osu-uwrt/hardware_boards/README.md

# riptide_hardware
Riptide specific EAGLE libs and board files
