osu-uwrt/hardware_boards/pneumaticsBoard/README.md

#Pneumatics Board

This is the board that goes in the pnuematics housing of the competition vehicle _Riptide 2018_.
