osu-uwrt/hardware_boards/batteryBalancer/Blaine/Block Diagram.png

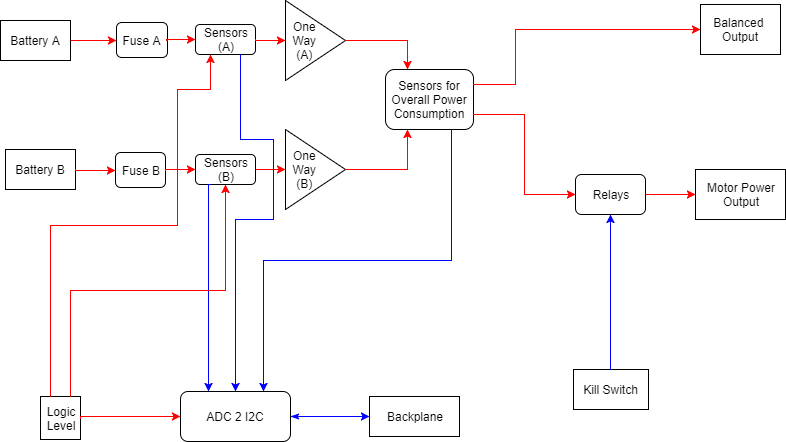
batteryBalancer/Blaine/Block Diagram.png
