osu-uwrt/hardware_boards/coProcessor/co_processor.cmp.bmp

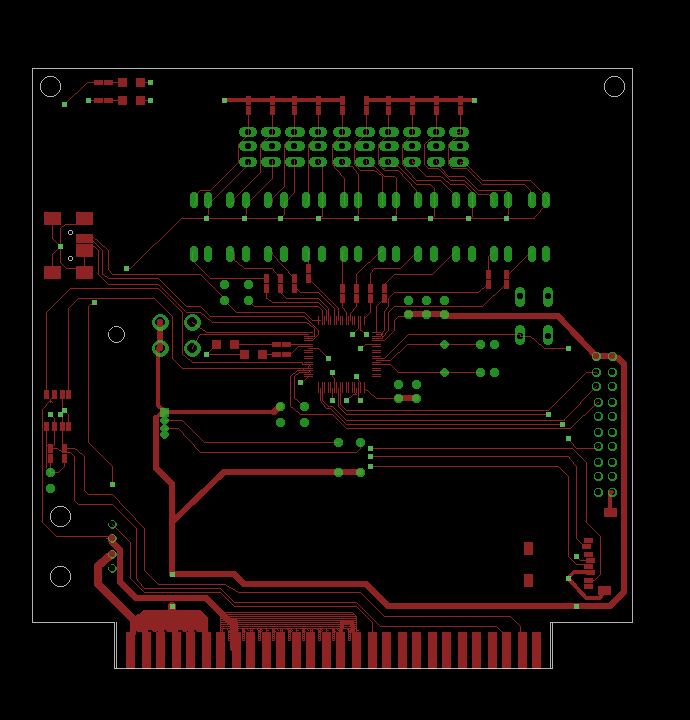
coProcessor/co_processor.cmp.bmp
