osu-uwrt/hardware_boards/coProcessor/co_processor.sol.bmp

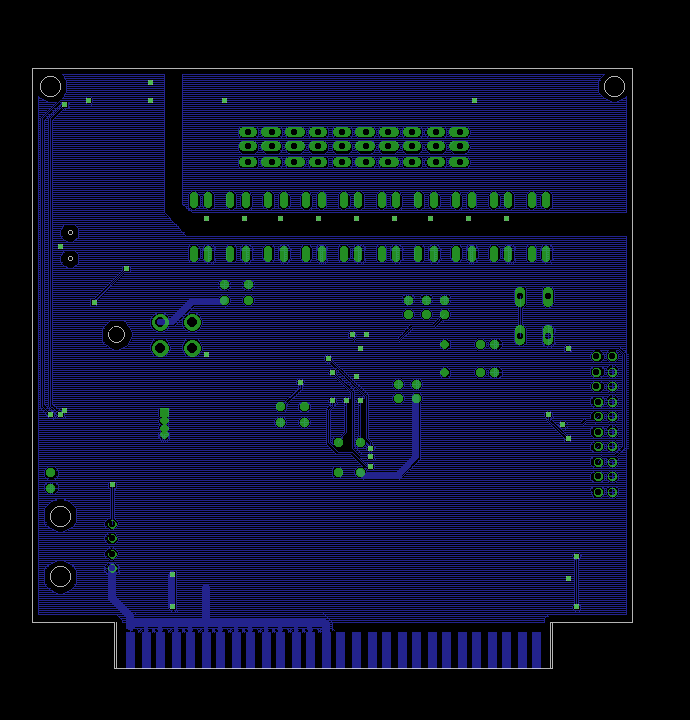
coProcessor/co_processor.sol.bmp
