osu-uwrt/hardware_boards/Status Board/Documentation/Eagle Board.png

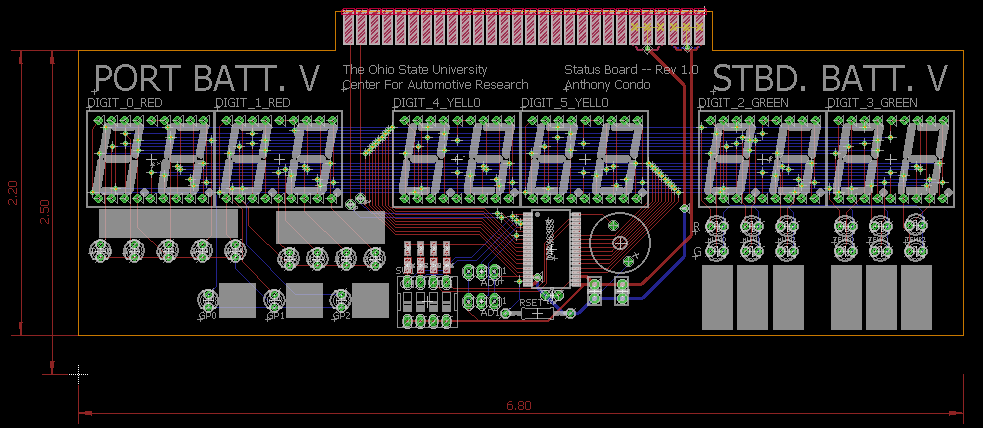
Status Board/Documentation/Eagle Board.png
