osu-uwrt/hardware_boards/Status Board/Documentation/Schematic Pt. 1 MAX6955 and Edge connector.png

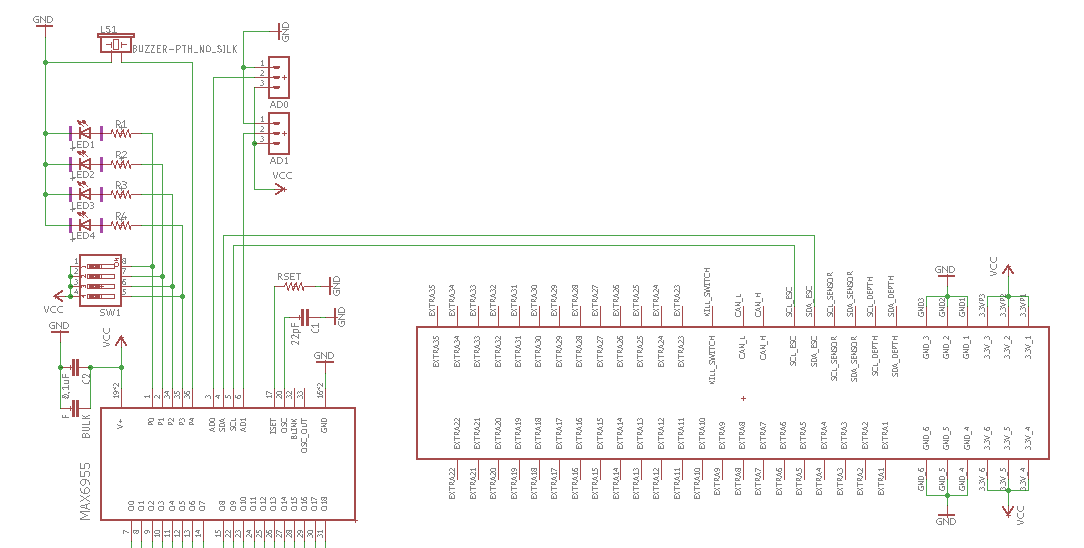
Status Board/Documentation/Schematic Pt. 1 MAX6955 and Edge connector.png
