osu-uwrt/hardware_boards/Status Board/Documentation/Schematic Pt. 2 One 4 Digit 7-Segment display and Discreet LED array.png

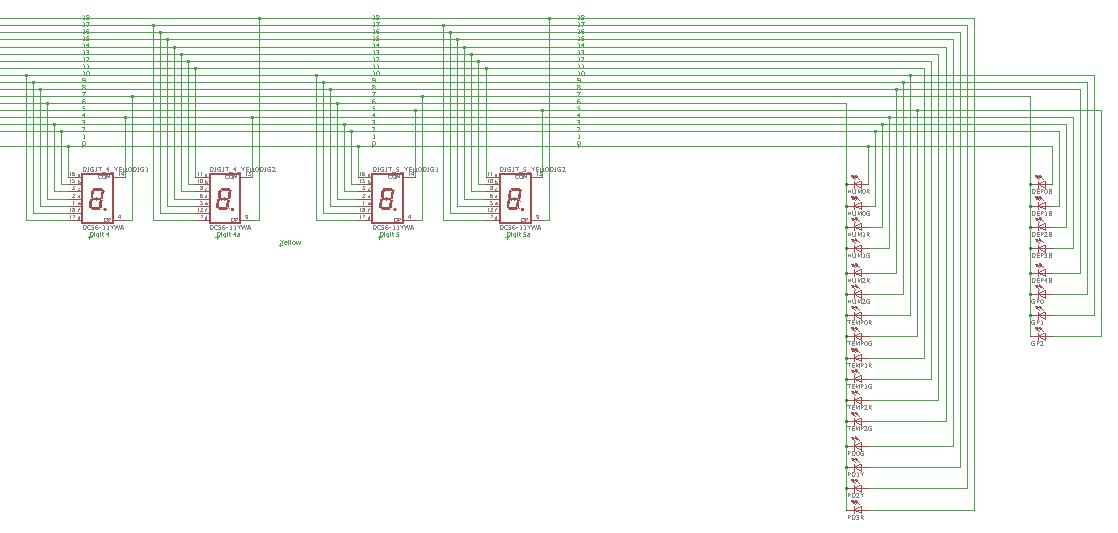
Status Board/Documentation/Schematic Pt. 2 One 4 Digit 7-Segment display and Discreet LED array.png
