osu-uwrt/hardware_boards/Status Board/Documentation/Schematic Pt. 3 Full Diagram.png

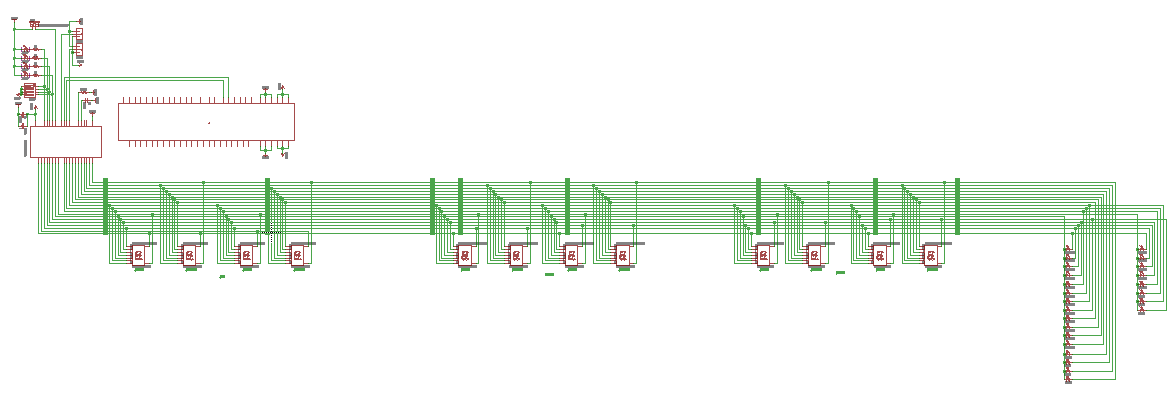
Status Board/Documentation/Schematic Pt. 3 Full Diagram.png
