osu-uwrt/hardware_boards/coProcessor/parts list.xlsx

type of part | mouser part name | manufacturer | number of parts | costs per part | total costs | mouser link | Description
Coprocessor Chip | 511-STM32F405RGT6 | STMicroelectronics | 1 |  | 0
Opto-Coupler | SFH610A-2 | Vishay | 10 |  | 0
USB Mini-B SMD Connector | PRT-00587 | Samtec | 1 |  | 0
DC Power Connector Power Jack | 490-PJ-002AH-SMT-TR | CUI Inc. | 1 |  | 0
3 Pin Header | 619-451-00303 | Parallax | 11 |  | 0
CAN Transceiver | 700-MAX3051EKAT | Maxim Integrated | 1 |  | 0 | https://www.mouser.com/ProductDetail/Maxim-Integrated/MAX3051EKA%2bT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
2 Pin Header | 538-22-27-2021 | Molex | 1 | 0.26 | 0.26 | http://mklec.com/connectors/pcb-header-pins/2-pin-header-pin-socket-and-plug-connector
Nanofit 12CKT Header Horizontal | 538-105312-2112 | Molex | 1 | 2.47 | 2.47 | https://www.mouser.com/ProductDetail/Molex/105314-2112
Nanofit 12CKT Wire Housing | 538-105312-2112 | Molex | 1 |  | 0 | https://www.mouser.com/ProductDetail/Molex/105312-2112
Standard TH LED | 941-C503BRANCZ0C0AA1 | Cree Inc. | 4 |  | 0 | https://www.mouser.com/ProductDetail/941-C503BRANCZ0C0AA1
Linear Voltage Regulator | 511-L78M05CV | STMicroelectronics | 1 |  | 0 | https://www.mouser.com/ProductDetail/511-L78M05CV
Tactile Switch | 653-B3F-1000 | Omron Electronics | 2 |  | 0 | https://www.mouser.com/ProductDetail/653-B3F-1000
SD Connector | 538-503398-0891 | Molex | 1 | 8.95 | 8.95 | https://www.mouser.com/ProductDetail/Molex/503398-0891?qs=sGAEpiMZZMvix4Kz%252byXAvY8l7qWUhbAP
Crystal Oscillator 20 pF | 520-HCA1600-20X | ECS | 1 | 0.6 | 0.6 | https://www.mouser.com/ProductDetail/ECS/ECS-160-20-1X?qs=sGAEpiMZZMsBj6bBr9Q9aXpukMv0ARbgbHEQKPAbIC0%3d
Ceramic Capacitor .1 uF 10% SMT | 80-C0603C104K5REAUTO | KEMET | 5 | 0.19 | 0.95 | https://www.mouser.com/ProductDetail/80-C0603C104K5REAUTO
Ceramic Capacitor 4.7 uF 10% | 963-JMK107BB7475KA-T | Taiyo Yuden | 6 | 0.27 | 1.62 | https://www.mouser.com/ProductDetail/963-JMK107BB7475KA-T
Ceramic Capacitor 2.2 uF 10% | 81-GRM188R61C225KE15 | Murata | 6 | 0.19 | 1.14 | https://www.mouser.com/ProductDetail/81-GRM188R61C225KE15
Ceramic Capacitor 1 nF |  |  |  |  | 0
 |  |  |  |  | 0
 |  |  |  |  | 0
 |  |  |  |  | 0
 |  |  |  |  | 0
 |  |  |  |  | 0
 |  |  |  |  | 0
 |  |  |  |  | 0
 |  |  |  |  | 0
 |  |  |  |  | 0
 |  |  |  |  | 0
 |  |  |  |  | 0
 |  |  |  |  | 0
 |  |  |  |  | 13.23
