osu-uwrt/hardware_boards/eagle_libs/internetLibraries/Eagle Libraries (E14)/LIB_STM32F405RGT6/STM32F405RGT6/3D/STM32F405RGT6.stp

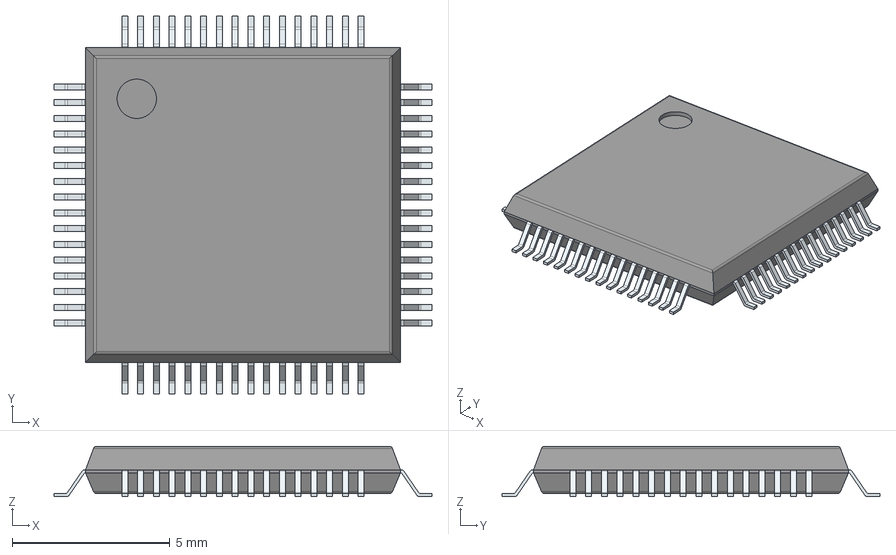
[picture p13: CAD file, 2017-11-12]
eagle_libs/internetLibraries/Eagle Libraries (E14)/LIB_STM32F405RGT6/STM32F405RGT6/3D/STM32F405RGT6.stp
12.0 x 12.0 x 1.60 mm
PinsArrayLR
PinsArrayTB
