osu-uwrt/hardware_boards/(list of files, cad)

Other CAD files:
eagle_libs/internetLibraries/Eagle Libraries (E14)/LIB_STM32F405RGT6/STM32F405RGT6/3D/STM32F405RGT6.stl
eagle_libs/internetLibraries/Eagle Libraries (E14)/STM32F405RGT6/3D/STM32F405RGT6.stl
