osu-uwrt/hardware_boards/debugBoard/README.md

#Electrical System Board Template

This is the template for our boards to fit in the mechanical mount. System revision 1.

##Description
*4inx4in board form factor. 

*4-40 through holes for mounting

*Current Edge connector and pinout configurations

*Initial labels that need to be on all boards

###--------------------------------------------------

Last revision 8/30/17
