osu-uwrt/hardware_boards/coProcessor/co_processor.pdf

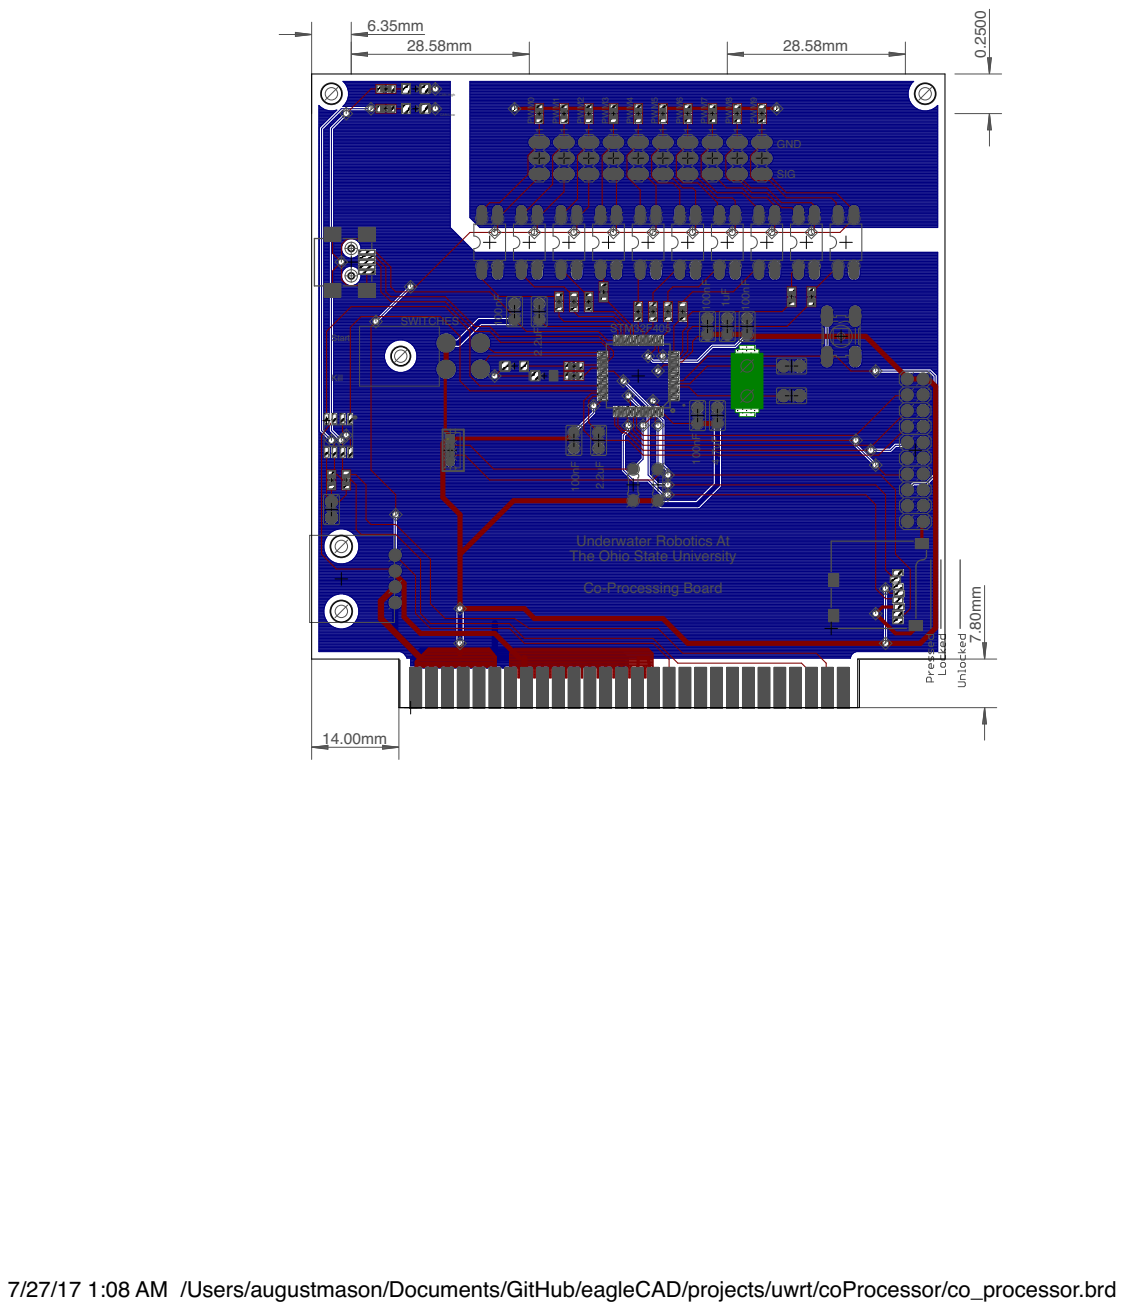
[picture p14: page 1]

Underwater Robotics At
The Ohio State University

7/27/17 1:08 AM /Users/augustmason/Documents/GitHub/eagleCAD/projects/uwrt/coProcessor/co_processor.brd
