osu-uwrt/hardware_boards/acoustics/Nice Acoustics/acoustics.brd

## EAGLE design acoustics/Nice Acoustics/acoustics.brd (2018-09-28)

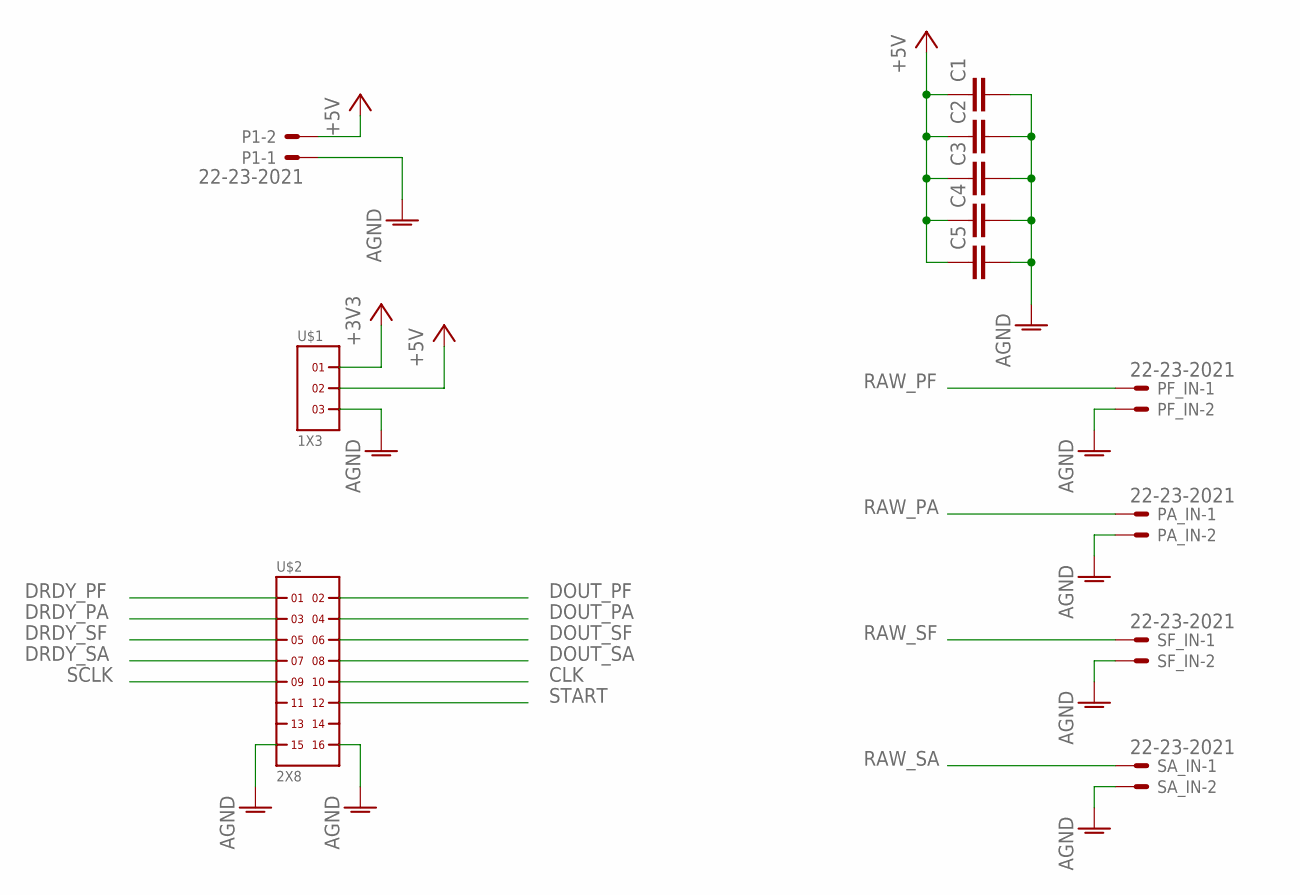
[picture p15: schematic acoustics.sch, sheet 1, Connectors]

Parts:
C1, C2, C3, C4, C5: C2,5-3; C2.5-3
P1: 22-23-2021
PA_IN: 22-23-2021
PF_IN: 22-23-2021
SA_IN: 22-23-2021
SF_IN: 22-23-2021
U$1: 1X3
U$2: 2X8

Connections:
+3V3: U$1.1; also elsewhere on the board
+5V: C1.1, C2.1, C3.1, C4.1, C5.1, P1.2, U$1.2
CLK: U$2.10; also elsewhere on the board
DOUT_PA: U$2.4; also elsewhere on the board
DOUT_PF: U$2.2; also elsewhere on the board
DOUT_SA: U$2.8; also elsewhere on the board
DOUT_SF: U$2.6; also elsewhere on the board
DRDY_PA: U$2.3; also elsewhere on the board
DRDY_PF: U$2.1; also elsewhere on the board
DRDY_SA: U$2.7; also elsewhere on the board
DRDY_SF: U$2.5; also elsewhere on the board
GND: C1.2, C2.2, C3.2, C4.2, C5.2, P1.1, PA_IN.2, PF_IN.2, SA_IN.2, SF_IN.2, U$1.3, U$2.15, U$2.16; also elsewhere on the board
RAW_PA: PA_IN.1; also elsewhere on the board
RAW_PF: PF_IN.1; also elsewhere on the board
RAW_SA: SA_IN.1; also elsewhere on the board
RAW_SF: SF_IN.1; also elsewhere on the board
SCLK: U$2.9; also elsewhere on the board
START: U$2.12; also elsewhere on the board

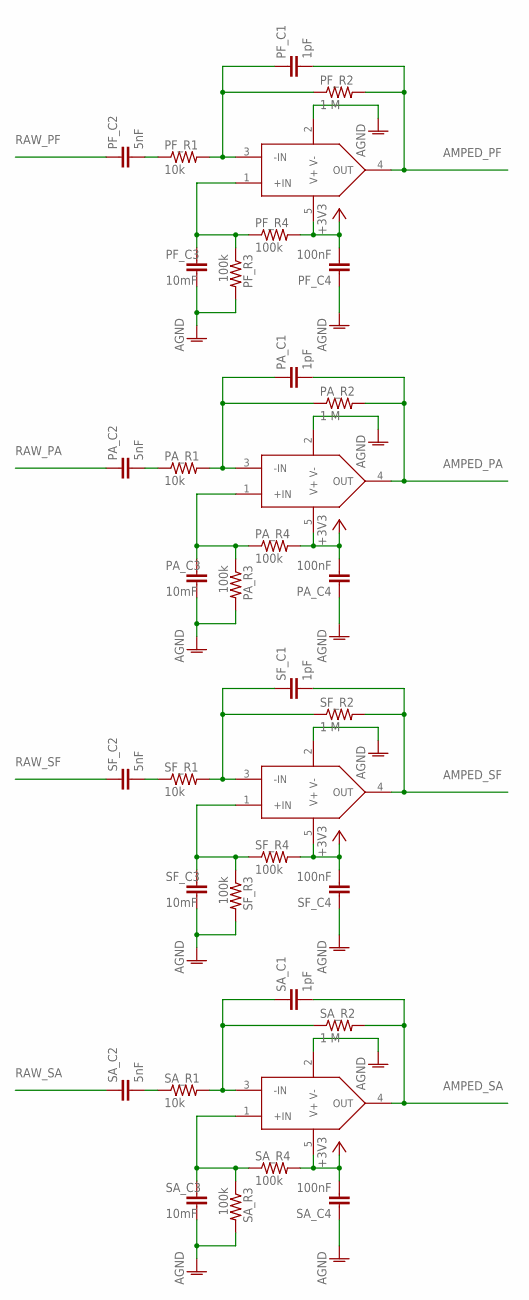
[picture p16: schematic acoustics.sch, sheet 2, Pre-amp]

Parts:
H4_PREAMP4: TLV6741; SC70-5
PA_C1: 1pF; C0603
PA_C2: 5nF; C0603
PA_C3: 10mF; C0603
PA_C4: 100nF; C0603
PA_PREAMP: TLV6741; SC70-5
PA_R1: 10k; R0603
PA_R2: 1 M; R0603
PA_R3, PA_R4: 100k; R0603
PF_C1: 1pF; C0603
PF_C2: 5nF; C0603
PF_C3: 10mF; C0603
PF_C4: 100nF; C0603
PF_PREAMP: TLV6741; SC70-5
PF_R1: 10k; R0603
PF_R2: 1 M; R0603
PF_R3, PF_R4: 100k; R0603
SA_C1: 1pF; C0603
SA_C2: 5nF; C0603
SA_C3: 10mF; C0603
SA_C4: 100nF; C0603
SA_R1: 10k; R0603
SA_R2: 1 M; R0603
SA_R3, SA_R4: 100k; R0603
SF_C1: 1pF; C0603
SF_C2: 5nF; C0603
SF_C3: 10mF; C0603
SF_C4: 100nF; C0603
SF_PREAMP3: TLV6741; SC70-5
SF_R1: 10k; R0603
SF_R2: 1 M; R0603
SF_R3, SF_R4: 100k; R0603

Connections:
+3V3: H4_PREAMP4.5 (V+), PA_C4.2, PA_PREAMP.5 (V+), PA_R4.2, PF_C4.2, PF_PREAMP.5 (V+), PF_R4.2, SA_C4.2, SA_R4.2, SF_C4.2, SF_PREAMP3.5 (V+), SF_R4.2; also elsewhere on the board
AMPED_PA: PA_C1.2, PA_PREAMP.4 (OUT), PA_R2.2; also elsewhere on the board
AMPED_PF: PF_C1.2, PF_PREAMP.4 (OUT), PF_R2.2; also elsewhere on the board
AMPED_SA: H4_PREAMP4.4 (OUT), SA_C1.2, SA_R2.2; also elsewhere on the board
AMPED_SF: SF_C1.2, SF_PREAMP3.4 (OUT), SF_R2.2; also elsewhere on the board
GND: H4_PREAMP4.2 (V-), PA_C3.2, PA_C4.1, PA_PREAMP.2 (V-), PA_R3.2, PF_C3.2, PF_C4.1, PF_PREAMP.2 (V-), PF_R3.2, SA_C3.2, SA_C4.1, SA_R3.2, SF_C3.2, SF_C4.1, SF_PREAMP3.2 (V-), SF_R3.2; also elsewhere on the board
unnamed: PF_C2.2, PF_R1.1
unnamed: PF_C1.1, PF_PREAMP.3 (-IN), PF_R1.2, PF_R2.1
unnamed: PF_C3.1, PF_PREAMP.1 (+IN), PF_R3.1, PF_R4.1
unnamed: PA_C2.2, PA_R1.1
unnamed: PA_C1.1, PA_PREAMP.3 (-IN), PA_R1.2, PA_R2.1
unnamed: PA_C3.1, PA_PREAMP.1 (+IN), PA_R3.1, PA_R4.1
unnamed: SF_C2.2, SF_R1.1
unnamed: SF_C1.1, SF_PREAMP3.3 (-IN), SF_R1.2, SF_R2.1
unnamed: SF_C3.1, SF_PREAMP3.1 (+IN), SF_R3.1, SF_R4.1
unnamed: SA_C2.2, SA_R1.1
unnamed: H4_PREAMP4.3 (-IN), SA_C1.1, SA_R1.2, SA_R2.1
unnamed: H4_PREAMP4.1 (+IN), SA_C3.1, SA_R3.1, SA_R4.1
RAW_PA: PA_C2.1; also elsewhere on the board
RAW_PF: PF_C2.1; also elsewhere on the board
RAW_SA: SA_C2.1; also elsewhere on the board
RAW_SF: SF_C2.1; also elsewhere on the board

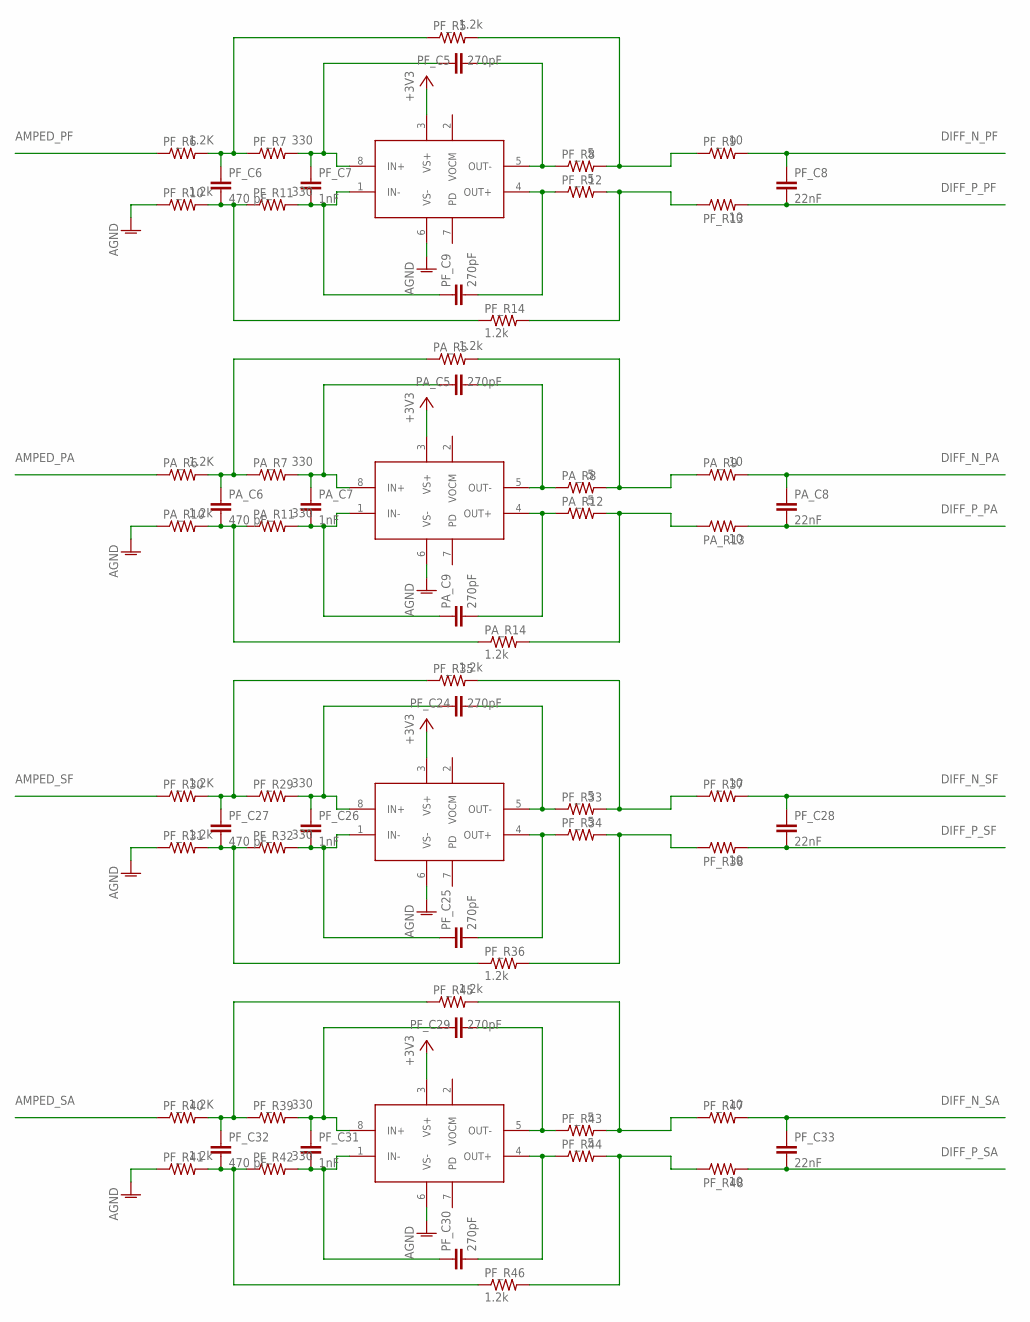
[picture p17: schematic acoustics.sch, sheet 3, Differential amplifier]

Parts:
PA_C5, PA_C9: 270pF; C0603
PA_C6: 470 pF; C0603
PA_C7: 1nF; C0603
PA_C8: 22nF; C0603
PA_DA: THS4551; VSSOP-8
PA_R5, PA_R10, PA_R14: 1.2k; R0603
PA_R6: 1.2K; R0603
PA_R7, PA_R11: 330; R0603
PA_R8, PA_R12: 5; R0603
PA_R9, PA_R13: 10; R0603
PF_C5, PF_C9, PF_C24, PF_C25, PF_C29, PF_C30: 270pF; C0603
PF_C6, PF_C27, PF_C32: 470 pF; C0603
PF_C7, PF_C26, PF_C31: 1nF; C0603
PF_C8, PF_C28, PF_C33: 22nF; C0603
PF_DA, PF_DA2, PF_DA3: THS4551; VSSOP-8
PF_R5, PF_R10, PF_R14, PF_R31, PF_R35, PF_R36, PF_R41, PF_R45, PF_R46: 1.2k; R0603
PF_R6, PF_R30, PF_R40: 1.2K; R0603
PF_R7, PF_R11, PF_R29, PF_R32, PF_R39, PF_R42: 330; R0603
PF_R8, PF_R12, PF_R33, PF_R34, PF_R43, PF_R44: 5; R0603
PF_R9, PF_R13, PF_R37, PF_R38, PF_R47, PF_R48: 10; R0603

Connections:
+3V3: PA_DA.3 (VS+), PF_DA.3 (VS+), PF_DA2.3 (VS+), PF_DA3.3 (VS+); also elsewhere on the board
AMPED_PA: PA_R6.1; also elsewhere on the board
AMPED_PF: PF_R6.1; also elsewhere on the board
AMPED_SA: PF_R40.1; also elsewhere on the board
AMPED_SF: PF_R30.1; also elsewhere on the board
DIFF_N_PA: PA_C8.1, PA_R9.2; also elsewhere on the board
DIFF_N_PF: PF_C8.1, PF_R9.2; also elsewhere on the board
DIFF_N_SA: PF_C33.1, PF_R47.2; also elsewhere on the board
DIFF_N_SF: PF_C28.1, PF_R37.2; also elsewhere on the board
DIFF_P_PA: PA_C8.2, PA_R13.2; also elsewhere on the board
DIFF_P_PF: PF_C8.2, PF_R13.2; also elsewhere on the board
DIFF_P_SA: PF_C33.2, PF_R48.2; also elsewhere on the board
DIFF_P_SF: PF_C28.2, PF_R38.2; also elsewhere on the board
GND: PA_DA.6 (VS-), PA_R10.1, PF_DA.6 (VS-), PF_DA2.6 (VS-), PF_DA3.6 (VS-), PF_R10.1, PF_R31.1, PF_R41.1; also elsewhere on the board
unnamed: PA_C5.2, PA_DA.5 (OUT-), PA_R8.1
unnamed: PA_C5.1, PA_C7.1, PA_DA.8 (IN+), PA_R7.2
unnamed: PA_C7.2, PA_C9.1, PA_DA.1 (IN-), PA_R11.2
unnamed: PA_C6.1, PA_R5.1, PA_R6.2, PA_R7.1
unnamed: PA_C6.2, PA_R10.2, PA_R11.1, PA_R14.1
unnamed: PA_C9.2, PA_DA.4 (OUT+), PA_R12.1
unnamed: PA_R5.2, PA_R8.2, PA_R9.1
unnamed: PA_R12.2, PA_R13.1, PA_R14.2
unnamed: PF_C24.2, PF_DA2.5 (OUT-), PF_R33.1
unnamed: PF_C24.1, PF_C26.1, PF_DA2.8 (IN+), PF_R29.2
unnamed: PF_C25.1, PF_C26.2, PF_DA2.1 (IN-), PF_R32.2
unnamed: PF_C27.1, PF_R29.1, PF_R30.2, PF_R35.1
unnamed: PF_C27.2, PF_R31.2, PF_R32.1, PF_R36.1
unnamed: PF_C25.2, PF_DA2.4 (OUT+), PF_R34.1
unnamed: PF_R33.2, PF_R35.2, PF_R37.1
unnamed: PF_R34.2, PF_R36.2, PF_R38.1
unnamed: PF_C29.2, PF_DA3.5 (OUT-), PF_R43.1
unnamed: PF_C29.1, PF_C31.1, PF_DA3.8 (IN+), PF_R39.2
unnamed: PF_C30.1, PF_C31.2, PF_DA3.1 (IN-), PF_R42.2
unnamed: PF_C32.1, PF_R39.1, PF_R40.2, PF_R45.1
unnamed: PF_C32.2, PF_R41.2, PF_R42.1, PF_R46.1
unnamed: PF_C30.2, PF_DA3.4 (OUT+), PF_R44.1
unnamed: PF_R43.2, PF_R45.2, PF_R47.1
unnamed: PF_R44.2, PF_R46.2, PF_R48.1
unnamed: PF_R12.2, PF_R13.1, PF_R14.2
unnamed: PF_C5.2, PF_DA.5 (OUT-), PF_R8.1
unnamed: PF_C5.1, PF_C7.1, PF_DA.8 (IN+), PF_R7.2
unnamed: PF_C7.2, PF_C9.1, PF_DA.1 (IN-), PF_R11.2
unnamed: PF_C6.1, PF_R5.1, PF_R6.2, PF_R7.1
unnamed: PF_C6.2, PF_R10.2, PF_R11.1, PF_R14.1
unnamed: PF_C9.2, PF_DA.4 (OUT+), PF_R12.1
unnamed: PF_R5.2, PF_R8.2, PF_R9.1

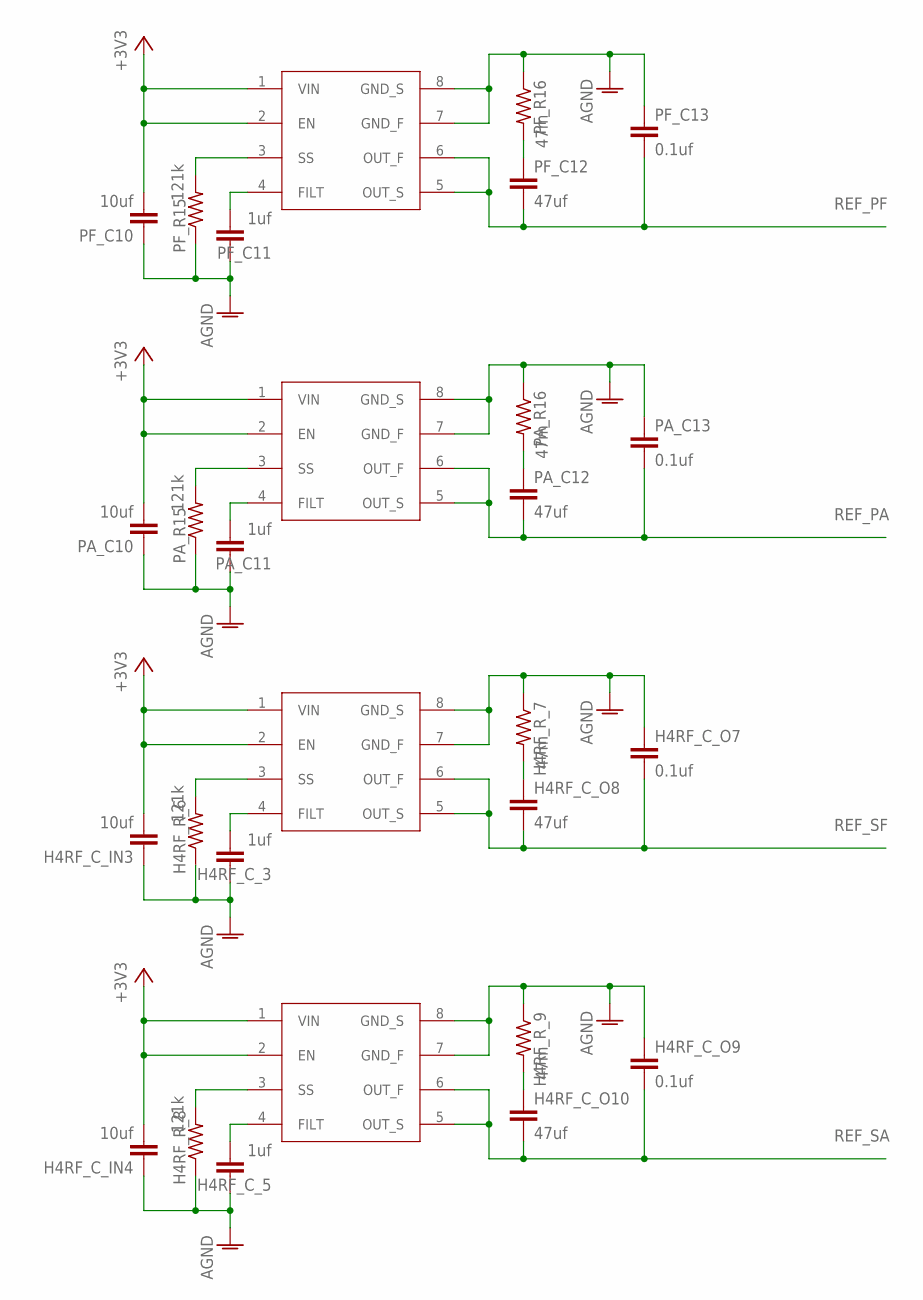
[picture p18: schematic acoustics.sch, sheet 4, Voltage Reference]

Parts:
H4RF_C_3, H4RF_C_5: 1uf; C0603
H4RF_C_IN3, H4RF_C_IN4: 10uf; C0603
H4RF_C_O7, H4RF_C_O9: 0.1uf; C0603
H4RF_C_O8, H4RF_C_O10: 47uf; C0603
H4RF_R_6, H4RF_R_8: 121k; R0603
H4RF_R_7, H4RF_R_9: 47m; R0603
H4_REFGEN3, H4_REFGEN4: REF6025
PA_C10: 10uf; C0603
PA_C11: 1uf; C0603
PA_C12: 47uf; C0603
PA_C13: 0.1uf; C0603
PA_R15: 121k; R0603
PA_R16: 47m; R0603
PA_REFGEN: REF6025
PF_C10: 10uf; C0603
PF_C11: 1uf; C0603
PF_C12: 47uf; C0603
PF_C13: 0.1uf; C0603
PF_R15: 121k; R0603
PF_R16: 47m; R0603
PF_REFGEN: REF6025

Connections:
+3V3: H4RF_C_IN3.2, H4RF_C_IN4.2, H4_REFGEN3.1 (VIN), H4_REFGEN3.2 (EN), H4_REFGEN4.1 (VIN), H4_REFGEN4.2 (EN), PA_C10.2, PA_REFGEN.1 (VIN), PA_REFGEN.2 (EN), PF_C10.2, PF_REFGEN.1 (VIN), PF_REFGEN.2 (EN); also elsewhere on the board
GND: H4RF_C_3.1, H4RF_C_5.1, H4RF_C_IN3.1, H4RF_C_IN4.1, H4RF_C_O7.1, H4RF_C_O9.1, H4RF_R_6.1, H4RF_R_7.1, H4RF_R_8.1, H4RF_R_9.1, H4_REFGEN3.7 (GND_F), H4_REFGEN3.8 (GND_S), H4_REFGEN4.7 (GND_F), H4_REFGEN4.8 (GND_S), PA_C10.1, PA_C11.1, PA_C13.1, PA_R15.1, PA_R16.1, PA_REFGEN.7 (GND_F), PA_REFGEN.8 (GND_S), PF_C10.1, PF_C11.1, PF_C13.1, PF_R15.1, PF_R16.1, PF_REFGEN.7 (GND_F), PF_REFGEN.8 (GND_S); also elsewhere on the board
unnamed: PF_C11.2, PF_REFGEN.4 (FILT)
unnamed: PF_R15.2, PF_REFGEN.3 (SS)
unnamed: PF_C12.1, PF_R16.2
unnamed: PA_C11.2, PA_REFGEN.4 (FILT)
unnamed: PA_R15.2, PA_REFGEN.3 (SS)
unnamed: PA_C12.1, PA_R16.2
unnamed: H4RF_C_3.2, H4_REFGEN3.4 (FILT)
unnamed: H4RF_R_6.2, H4_REFGEN3.3 (SS)
unnamed: H4RF_C_O8.1, H4RF_R_7.2
unnamed: H4RF_C_5.2, H4_REFGEN4.4 (FILT)
unnamed: H4RF_R_8.2, H4_REFGEN4.3 (SS)
unnamed: H4RF_C_O10.1, H4RF_R_9.2
REF_PA: PA_C12.2, PA_C13.2, PA_REFGEN.5 (OUT_S), PA_REFGEN.6 (OUT_F); also elsewhere on the board
REF_PF: PF_C12.2, PF_C13.2, PF_REFGEN.5 (OUT_S), PF_REFGEN.6 (OUT_F); also elsewhere on the board
REF_SA: H4RF_C_O9.2, H4RF_C_O10.2, H4_REFGEN4.5 (OUT_S), H4_REFGEN4.6 (OUT_F); also elsewhere on the board
REF_SF: H4RF_C_O7.2, H4RF_C_O8.2, H4_REFGEN3.5 (OUT_S), H4_REFGEN3.6 (OUT_F); also elsewhere on the board

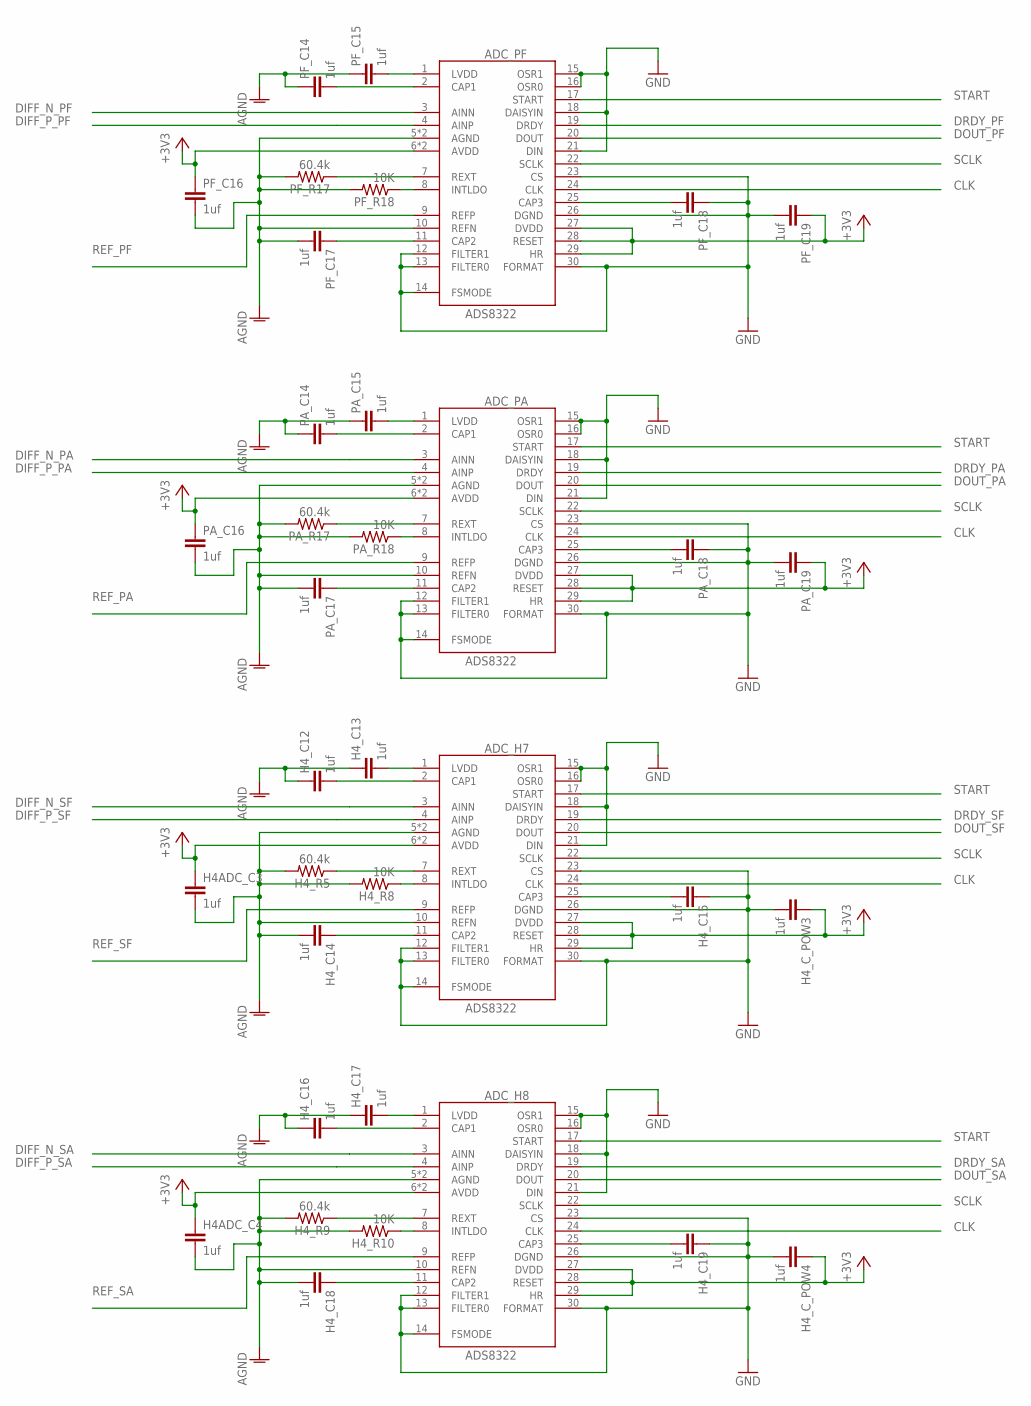
[picture p19: schematic acoustics.sch, sheet 5, ADCs]

Parts:
ADC_H7, ADC_H8: ADS8322; TQFP-32
ADC_PA: ADS8322; TQFP-32
ADC_PF: ADS8322; TQFP-32
H4ADC_C3, H4ADC_C4: 1uf; C0603K
H4_C12, H4_C13, H4_C14, H4_C15, H4_C16, H4_C17, H4_C18, H4_C19, H4_C_POW3, H4_C_POW4: 1uf; C0603
H4_R5, H4_R9: 60.4k; R0603
H4_R8, H4_R10: 10K; R0603
PA_C14, PA_C15, PA_C17, PA_C18, PA_C19: 1uf; C0603
PA_C16: 1uf; C0603K
PA_R17: 60.4k; R0603
PA_R18: 10K; R0603
PF_C14, PF_C15, PF_C17, PF_C18, PF_C19: 1uf; C0603
PF_C16: 1uf; C0603K
PF_R17: 60.4k; R0603
PF_R18: 10K; R0603

Connections:
+3V3: ADC_H7.6 (AVDD), ADC_H7.27 (DVDD), ADC_H7.28 (RESET), ADC_H7.29 (HR), ADC_H7.32 (AVDD), ADC_H8.6 (AVDD), ADC_H8.27 (DVDD), ADC_H8.28 (RESET), ADC_H8.29 (HR), ADC_H8.32 (AVDD), ADC_PA.6 (AVDD), ADC_PA.27 (DVDD), ADC_PA.28 (RESET), ADC_PA.29 (HR), ADC_PA.32 (AVDD), ADC_PF.6 (AVDD), ADC_PF.27 (DVDD), ADC_PF.28 (RESET), ADC_PF.29 (HR), ADC_PF.32 (AVDD), H4ADC_C3.1, H4ADC_C4.1, H4_C_POW3.1, H4_C_POW4.1, PA_C16.1, PA_C19.1, PF_C16.1, PF_C19.1; also elsewhere on the board
CLK: ADC_H7.24 (CLK), ADC_H8.24 (CLK), ADC_PA.24 (CLK), ADC_PF.24 (CLK); also elsewhere on the board
DIFF_N_PA: ADC_PA.3 (AINN); also elsewhere on the board
DIFF_N_PF: ADC_PF.3 (AINN); also elsewhere on the board
DIFF_N_SA: ADC_H8.3 (AINN); also elsewhere on the board
DIFF_N_SF: ADC_H7.3 (AINN); also elsewhere on the board
DIFF_P_PA: ADC_PA.4 (AINP); also elsewhere on the board
DIFF_P_PF: ADC_PF.4 (AINP); also elsewhere on the board
DIFF_P_SA: ADC_H8.4 (AINP); also elsewhere on the board
DIFF_P_SF: ADC_H7.4 (AINP); also elsewhere on the board
DOUT_PA: ADC_PA.20 (DOUT); also elsewhere on the board
DOUT_PF: ADC_PF.20 (DOUT); also elsewhere on the board
DOUT_SA: ADC_H8.20 (DOUT); also elsewhere on the board
DOUT_SF: ADC_H7.20 (DOUT); also elsewhere on the board
DRDY_PA: ADC_PA.19 (DRDY); also elsewhere on the board
DRDY_PF: ADC_PF.19 (DRDY); also elsewhere on the board
DRDY_SA: ADC_H8.19 (DRDY); also elsewhere on the board
DRDY_SF: ADC_H7.19 (DRDY); also elsewhere on the board
GND: ADC_H7.5 (AGND), ADC_H7.10 (REFN), ADC_H7.12 (FILTER1), ADC_H7.13 (FILTER0), ADC_H7.14 (FSMODE), ADC_H7.15 (OSR1), ADC_H7.16 (OSR0), ADC_H7.18 (DAISYIN), ADC_H7.21 (DIN), ADC_H7.23 (CS), ADC_H7.26 (DGND), ADC_H7.30 (FORMAT), ADC_H7.31 (AGND), ADC_H8.5 (AGND), ADC_H8.10 (REFN), ADC_H8.12 (FILTER1), ADC_H8.13 (FILTER0), ADC_H8.14 (FSMODE), ADC_H8.15 (OSR1), ADC_H8.16 (OSR0), ADC_H8.18 (DAISYIN), ADC_H8.21 (DIN), ADC_H8.23 (CS), ADC_H8.26 (DGND), ADC_H8.30 (FORMAT), ADC_H8.31 (AGND), ADC_PA.5 (AGND), ADC_PA.10 (REFN), ADC_PA.12 (FILTER1), ADC_PA.13 (FILTER0), ADC_PA.14 (FSMODE), ADC_PA.15 (OSR1), ADC_PA.16 (OSR0), ADC_PA.18 (DAISYIN), ADC_PA.21 (DIN), ADC_PA.23 (CS), ADC_PA.26 (DGND), ADC_PA.30 (FORMAT), ADC_PA.31 (AGND), ADC_PF.5 (AGND), ADC_PF.10 (REFN), ADC_PF.12 (FILTER1), ADC_PF.13 (FILTER0), ADC_PF.14 (FSMODE), ADC_PF.15 (OSR1), ADC_PF.16 (OSR0), ADC_PF.18 (DAISYIN), ADC_PF.21 (DIN), ADC_PF.23 (CS), ADC_PF.26 (DGND), ADC_PF.30 (FORMAT), ADC_PF.31 (AGND), H4ADC_C3.2, H4ADC_C4.2, H4_C12.1, H4_C13.1, H4_C14.2, H4_C15.1, H4_C16.1, H4_C17.1, H4_C18.2, H4_C19.1, H4_C_POW3.2, H4_C_POW4.2, H4_R5.2, H4_R8.2, H4_R9.2, H4_R10.2, PA_C14.1, PA_C15.1, PA_C16.2, PA_C17.2, PA_C18.1, PA_C19.2, PA_R17.2, PA_R18.2, PF_C14.1, PF_C15.1, PF_C16.2, PF_C17.2, PF_C18.1, PF_C19.2, PF_R17.2, PF_R18.2; also elsewhere on the board
unnamed: ADC_PF.2 (CAP1), PF_C14.2
unnamed: ADC_PA.1 (LVDD), PA_C15.2
unnamed: ADC_PA.8 (INTLDO), PA_R18.1
unnamed: ADC_PA.7 (REXT), PA_R17.1
unnamed: ADC_PA.11 (CAP2), PA_C17.1
unnamed: ADC_PA.25 (CAP3), PA_C18.2
unnamed: ADC_PF.1 (LVDD), PF_C15.2
unnamed: ADC_PA.2 (CAP1), PA_C14.2
unnamed: ADC_PF.8 (INTLDO), PF_R18.1
unnamed: ADC_PF.7 (REXT), PF_R17.1
unnamed: ADC_PF.11 (CAP2), PF_C17.1
unnamed: ADC_PF.25 (CAP3), PF_C18.2
unnamed: ADC_H7.1 (LVDD), H4_C13.2
unnamed: ADC_H7.8 (INTLDO), H4_R8.1
unnamed: ADC_H7.7 (REXT), H4_R5.1
unnamed: ADC_H7.11 (CAP2), H4_C14.1
unnamed: ADC_H7.25 (CAP3), H4_C15.2
unnamed: ADC_H7.2 (CAP1), H4_C12.2
unnamed: ADC_H8.1 (LVDD), H4_C17.2
unnamed: ADC_H8.8 (INTLDO), H4_R10.1
unnamed: ADC_H8.7 (REXT), H4_R9.1
unnamed: ADC_H8.11 (CAP2), H4_C18.1
unnamed: ADC_H8.25 (CAP3), H4_C19.2
unnamed: ADC_H8.2 (CAP1), H4_C16.2
REF_PA: ADC_PA.9 (REFP); also elsewhere on the board
REF_PF: ADC_PF.9 (REFP); also elsewhere on the board
REF_SA: ADC_H8.9 (REFP); also elsewhere on the board
REF_SF: ADC_H7.9 (REFP); also elsewhere on the board
SCLK: ADC_H7.22 (SCLK), ADC_H8.22 (SCLK), ADC_PA.22 (SCLK), ADC_PF.22 (SCLK); also elsewhere on the board
START: ADC_H7.17 (START), ADC_H8.17 (START), ADC_PA.17 (START), ADC_PF.17 (START); also elsewhere on the board

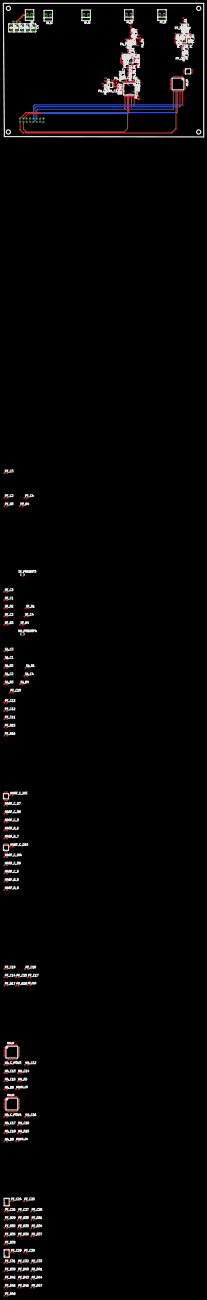
[picture p20: board acoustics.brd from above]

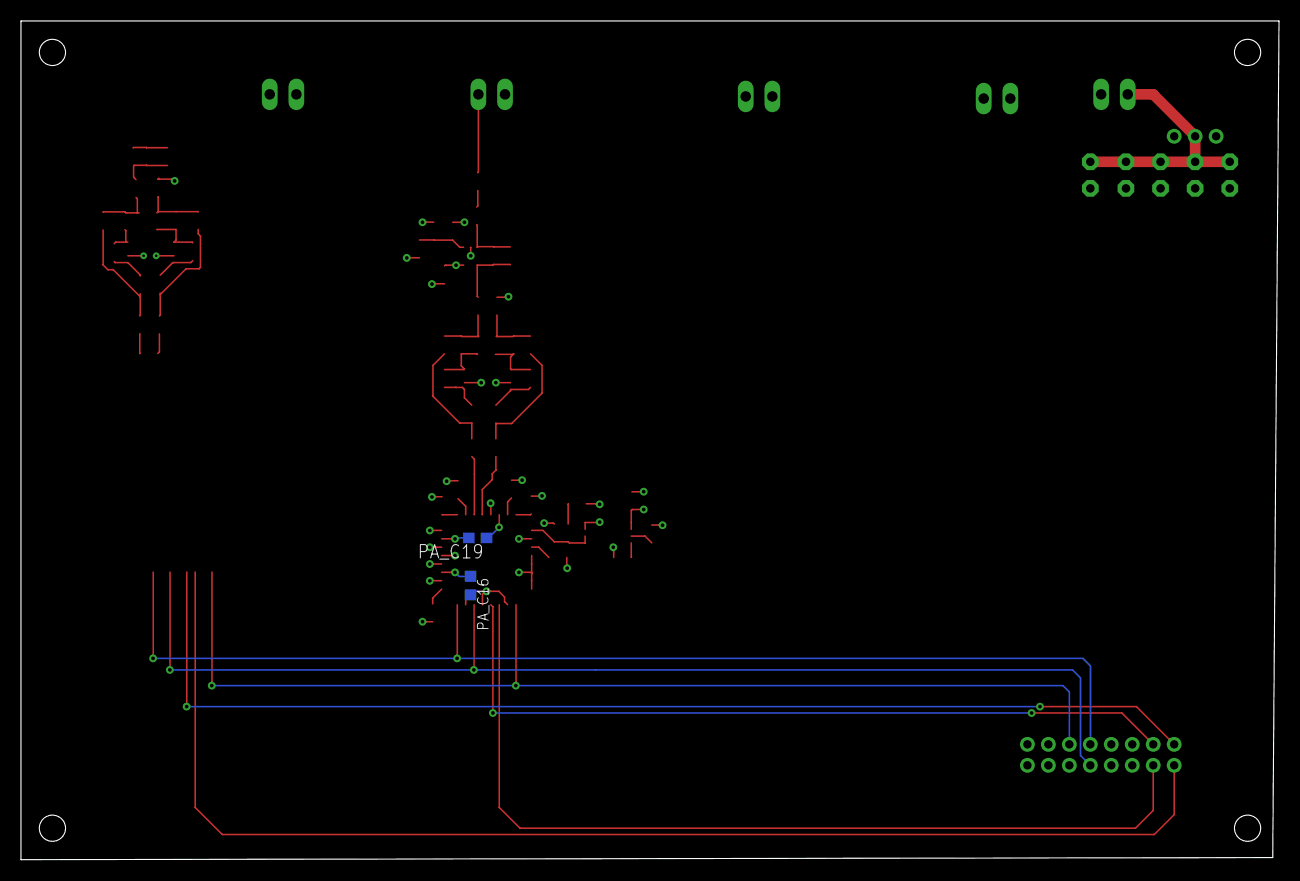
[picture p21: board acoustics.brd from below]

Board: 4 copper layers, 120.0 x 80.0 mm, 176 parts (2 on the bottom side), 114 nets.
