osu-uwrt/hardware_boards/Converter Board/ConverterBoard.brd

## EAGLE design Converter Board/ConverterBoard.brd (2018-05-21)

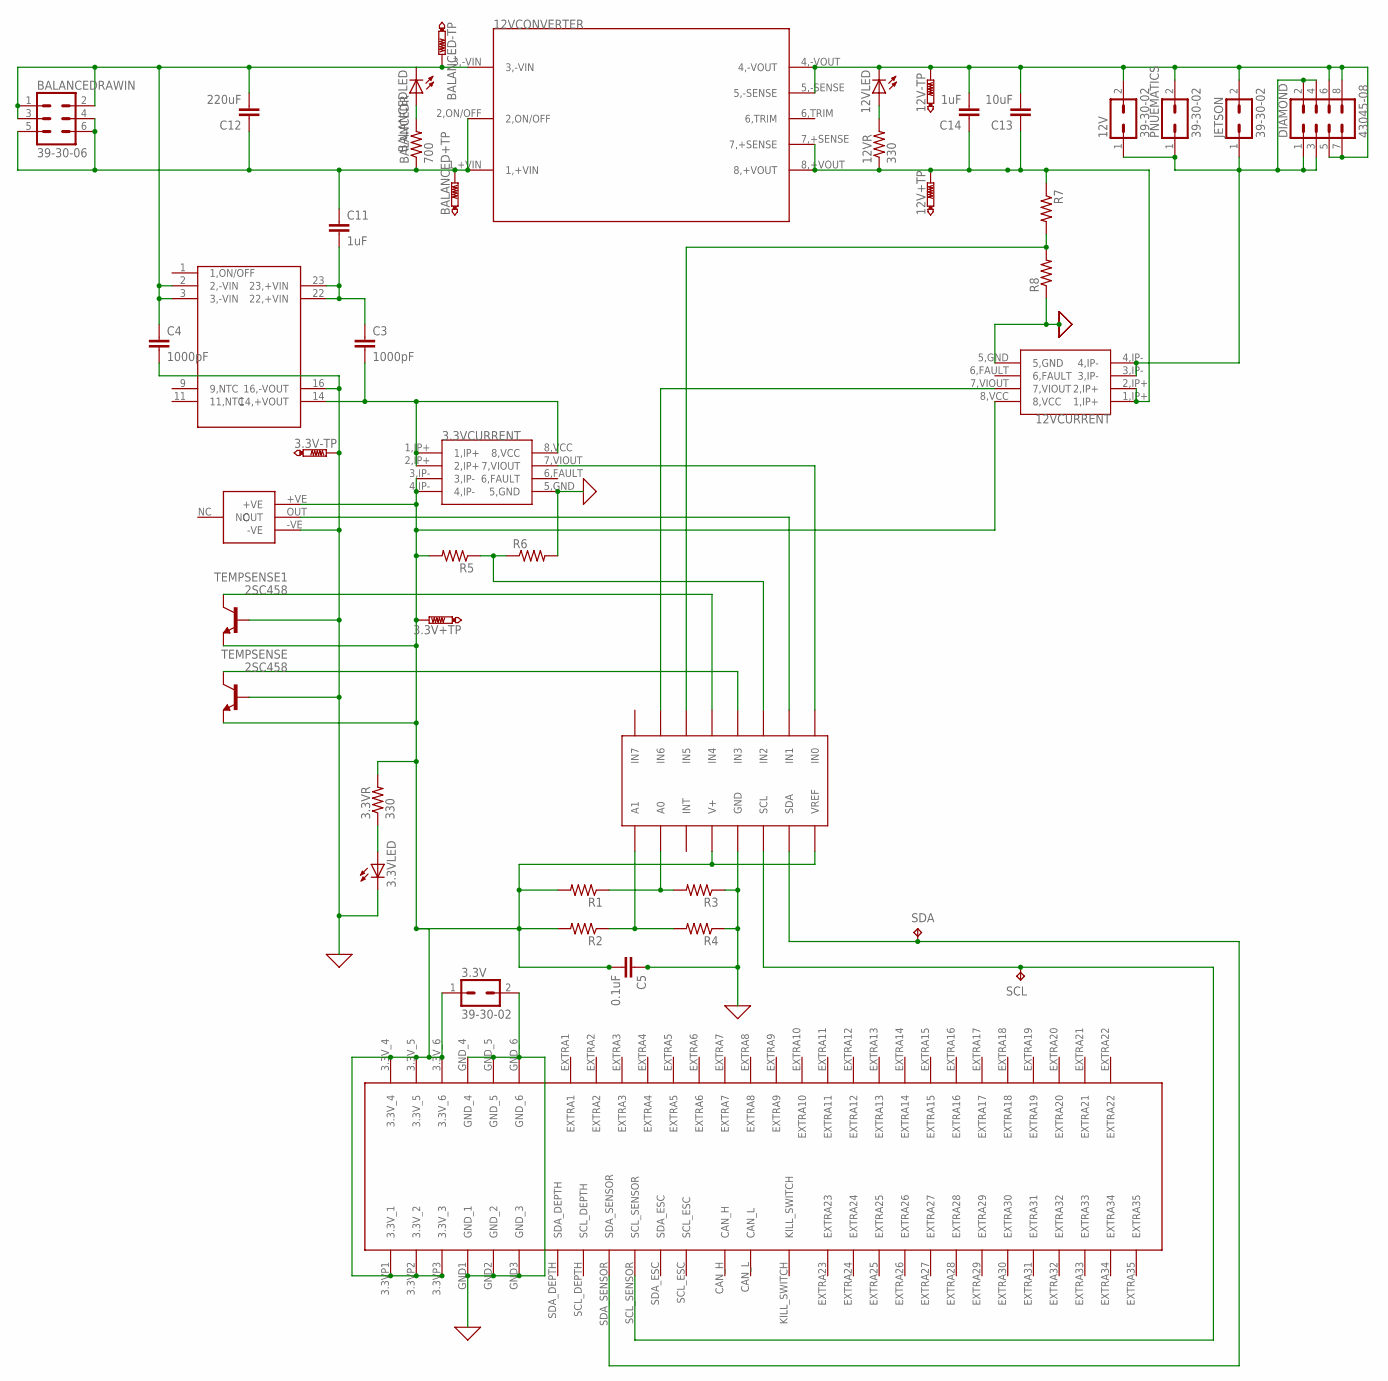
[picture p22: schematic ConverterBoard.sch]

Parts:
3.3V, 12V: 39-30-02; 39-30-?02?
3.3V+TP, 3.3V-TP, 12V+TP, 12V-TP: PTR1B1,27; B1,27
3.3VCURRENT, 12VCURRENT: CURRENTSENS
3.3VLED, 12VLED: LTST-S270GKT
3.3VR, 12VR: 330; 0204/7
12VCONVERTER: 12VCONV
ADC: ADC128D818; TSSOP-16
BALANCED+TP: PTR1B1,27; B1,27
BALANCED-TP: PTR1B1,27; B1,27
BALANCEDLED: LTST-S270GKT
BALANCEDR: 700; 0204/7
BALANCEDRAWIN: 39-30-06; 39-30-?06?
C3, C4: 1000pF; C5B3
C5: 0.1uF; C2.5-2
C11, C14: 1uF; C5B3
C12: 220uF; C5B3
C13: 10uF; C5B3
DIAMOND: 43045-08
JETSON: 39-30-02; 39-30-?02?
PNUEMATICS: 39-30-02; 39-30-?02?
R1, R2, R3, R4, R5, R6, R7, R8: R-US_0204/7; 0204/7
SCL: TPPAD1-20; P1-20
SDA: TPPAD1-20; P1-20
TEMPSENSE, TEMPSENSE1: 2SC458; TO92-ECB
U$2: 3.3VCONV
U$3: 5530843; 5530843-6-BOARDFINGERS
U$6: HUMIDITYSENSOR

Connections:
3.3VCONVIN: C3.1, C11.2, U$2.22 (22,+VIN), U$2.23 (23,+VIN)
3.3VCONVOUT: 3.3VCURRENT.1,IP+, 3.3VCURRENT.2,IP+, 3.3VCURRENT.8,VCC, C3.2, U$2.14 (14,+VOUT)
3.3VCURRENTDATA: 3.3VCURRENT.7,VIOUT, ADC.IN0
3.3VCURRENTOUT: 3.3V.1, 3.3V+TP.TP, 3.3VCURRENT.3,IP-, 3.3VCURRENT.4,IP-, 3.3VR.2, 12VCURRENT.8,VCC, ADC.V+, ADC.VREF, C5.2, R1.2, R2.2, R5.2, TEMPSENSE.E, TEMPSENSE1.E, U$3.3.3VP1 (3.3V_1), U$3.3.3VP2 (3.3V_2), U$3.3.3VP3 (3.3V_3), U$3.3.3V_4, U$3.3.3V_5, U$3.3.3V_6, U$6.+VE
3.3VDATA: ADC.IN2, R5.1, R6.1
3.3VLED: 3.3VLED.ANODE (A), 3.3VR.1
12VCONV+: 12V+TP.TP, 12VCONVERTER.7,+SENSE, 12VCONVERTER.8,+VOUT, 12VCURRENT.1,IP+, 12VCURRENT.2,IP+, 12VR.1, C13.1, C14.1, R7.1
12VCURRENTDATA: 12VCURRENT.7,VIOUT, ADC.IN6
12VCURRENTOUT: 12V.1, 12VCURRENT.3,IP-, 12VCURRENT.4,IP-, DIAMOND.1, DIAMOND.2, DIAMOND.3, DIAMOND.4, JETSON.1, PNUEMATICS.1
12VDIV: ADC.IN5, R7.2, R8.2
12VLED: 12VLED.ANODE (A), 12VR.2
A0: ADC.A0, R1.1, R3.2
A1: ADC.A1, R2.1, R4.2
BALANCED+: 12VCONVERTER.1,+VIN, 12VCONVERTER.2,ON/OFF, BALANCED+TP.TP, BALANCEDR.1, BALANCEDRAWIN.4, BALANCEDRAWIN.5, BALANCEDRAWIN.6, C11.1, C12.1
BALANCEDGND: 12VCONVERTER.3,-VIN, BALANCED-TP.TP, BALANCEDLED.CATHODE (C), BALANCEDRAWIN.1, BALANCEDRAWIN.2, BALANCEDRAWIN.3, C4.1, C12.2, U$2.2 (2,-VIN), U$2.3 (3,-VIN)
BALANCEDLED: BALANCEDLED.ANODE (A), BALANCEDR.2
CMGND: 3.3V.2, 3.3V-TP.TP, 3.3VCURRENT.5,GND, 3.3VLED.CATHODE (C), 12V.2, 12V-TP.TP, 12VCONVERTER.4,-VOUT, 12VCONVERTER.5,-SENSE, 12VCURRENT.5,GND, 12VLED.CATHODE (C), ADC.GND, C4.2, C5.1, C13.2, C14.2, DIAMOND.5, DIAMOND.6, DIAMOND.7, DIAMOND.8, JETSON.2, PNUEMATICS.2, R3.1, R4.1, R6.2, R8.1, TEMPSENSE.B, TEMPSENSE1.B, U$2.16 (16,-VOUT), U$3.GND1 (GND_1), U$3.GND2 (GND_2), U$3.GND3 (GND_3), U$3.GND_4, U$3.GND_5, U$3.GND_6, U$6.-VE
HUMIDITYDATA: ADC.IN1, U$6.OUT
SCL: ADC.SCL, SCL.TP, U$3.SCL_SENSOR
SDA: ADC.SDA, SDA.TP, U$3.SDA_SENSOR
TEMP1DATA: ADC.IN4, TEMPSENSE1.C
TEMPDATA: ADC.IN3, TEMPSENSE.C

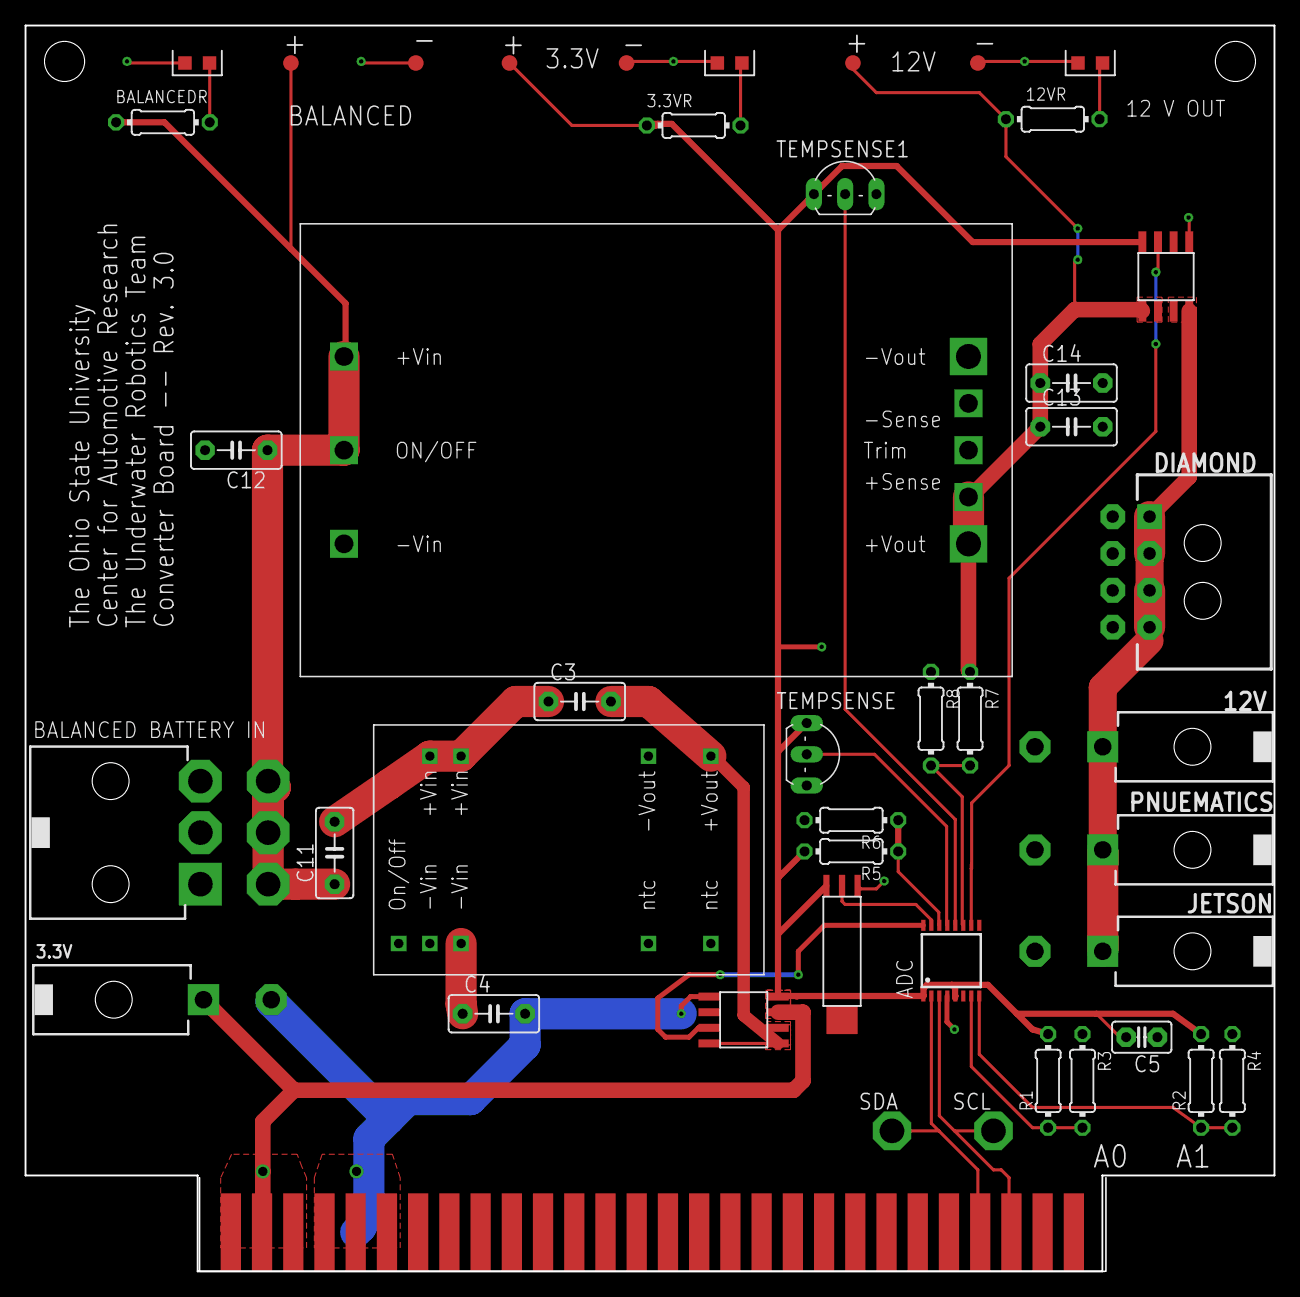
[picture p23: board Converter Board/ConverterBoard.brd from above]

Board: 2 copper layers, 101.6 x 101.3 mm, 44 parts (0 on the bottom side), 22 nets.
