osu-uwrt/hardware_boards/BatteryMonitor/Battery_Monitor.brd

## EAGLE design BatteryMonitor/Battery_Monitor.brd (2018-04-10)

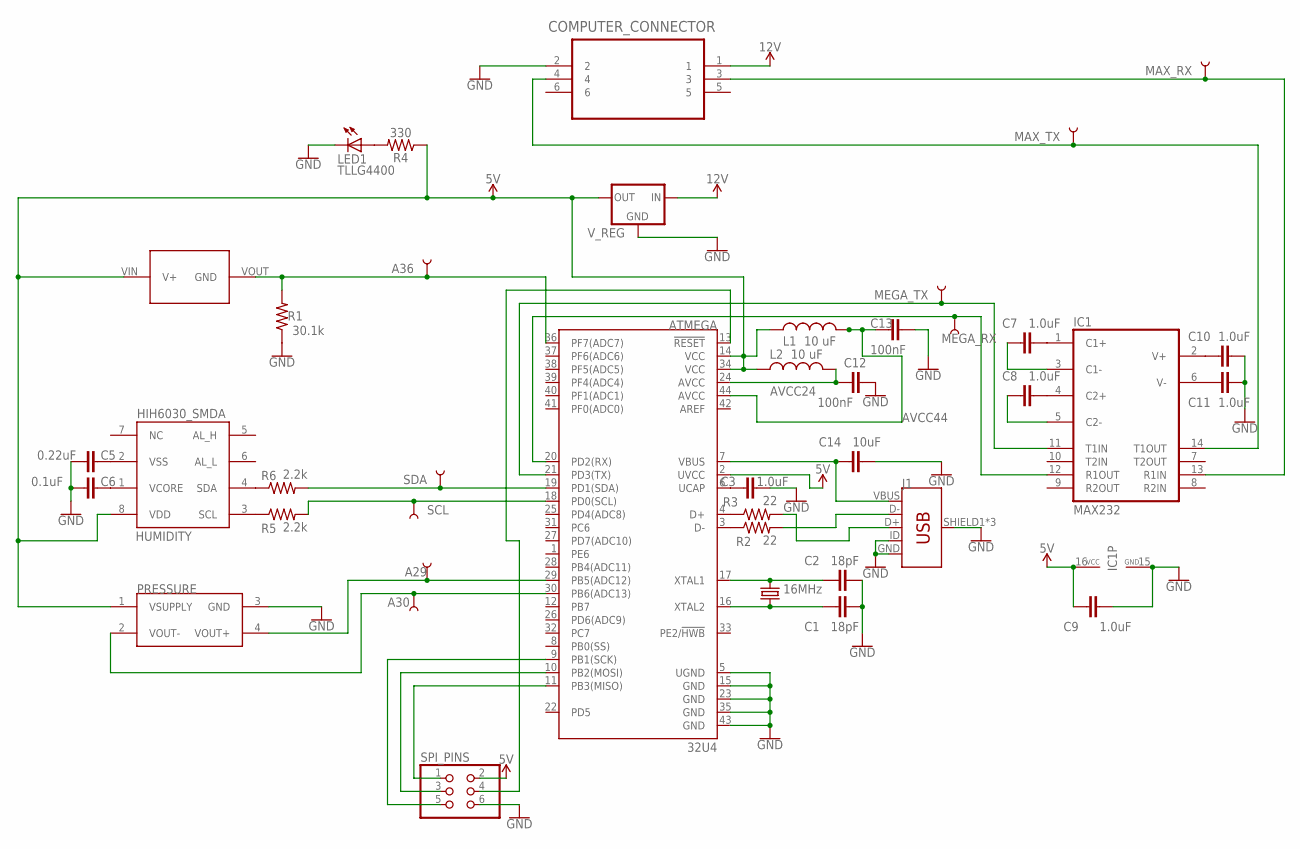
[picture p24: schematic Battery_Monitor.sch]

Parts:
16MHZ_CRYSTAL: 16MHz; HC49/S
A29, A30, A36: TEST-POINT3X5; PAD.03X.05
ATMEGA: 32U4; QFN-44
C1, C2: 18pF; 0603
C3, C7, C8, C9, C10, C11: 1.0uF; 0402
C5: 0.22uF; 0603
C6: 0.1uF; 0402
C12, C13: 100nF; 0402
C14: 10uF; 0603
COMPUTER_CONNECTOR: 52271-0469; MOLEX_52271-0469
FLEX_SQ: MOLEX_2WIRE2018; SMT_MOLEX_PKG
HUMIDITY: HIH6030_SMDA; SMD-8
IC1: MAX232; DIL16
J1: USB_MICRO-B_FEMALE-SMT; USB-B-MICRO-SMD
L1, L2: 10 uF; L1812
LED1: TLLG4400; LED3MM
MAX_RX: TEST-POINT3X5; PAD.03X.05
MAX_TX: TEST-POINT3X5; PAD.03X.05
MEGA_RX: TEST-POINT3X5; PAD.03X.05
MEGA_TX: TEST-POINT3X5; PAD.03X.05
PRESSURE: HONEYWELL_PRESSURE_SENSOR2018; 4PIN_SMT
R1: 30.1k; 0603
R2, R3: 22; 0402
R4: 330; 0603
R5, R6: 2.2k; 0603
SCL: TEST-POINT3X5; PAD.03X.05
SDA: TEST-POINT3X5; PAD.03X.05
SPI_PINS: PINHD-2X3; 2X03
V_REG: DC_DC_78XXA; DC-DC_CONVERTER_78XX

Connections:
5V: ATMEGA.2 (UVCC), ATMEGA.14 (VCC), ATMEGA.34 (VCC), C9.1, FLEX_SQ.VIN (V+), HUMIDITY.8 (VDD), IC1.16 (VCC), L1.1, L2.1, PRESSURE.1 (VSUPPLY), R4.1, SPI_PINS.2, V_REG.VOUT (OUT)
12V: COMPUTER_CONNECTOR.1, V_REG.VIN (IN)
A29: A29.P$1, ATMEGA.29 (PB5(ADC12)), PRESSURE.4 (VOUT+)
A30: A30.P$1, ATMEGA.30 (PB6(ADC13)), PRESSURE.2 (VOUT-)
A36: A36.P$1, ATMEGA.36 (PF7(ADC7)), FLEX_SQ.VOUT (GND), R1.2
AVCC24: ATMEGA.24 (AVCC), C12.2, L2.2
AVCC44: ATMEGA.44 (AVCC), C13.2, L1.2
D+: J1.D+, R3.2
D-: J1.D-, R2.2
GND: ATMEGA.5 (UGND), ATMEGA.15 (GND), ATMEGA.23 (GND), ATMEGA.35 (GND), ATMEGA.43 (GND), C1.1, C2.1, C3.2, C5.1, C6.1, C9.2, C10.2, C11.2, C12.1, C13.1, C14.2, COMPUTER_CONNECTOR.2, IC1.15 (GND), J1.GND, J1.ID, J1.SHIELD1 (SHIELD), J1.SHIELD2 (SHIELD), J1.SHIELD3 (SHIELD), LED1.K (C), PRESSURE.3 (GND), R1.1, SPI_PINS.6, V_REG.GND
MAX_RX: COMPUTER_CONNECTOR.3, IC1.13 (R1IN), MAX_RX.P$1
MAX_TX: COMPUTER_CONNECTOR.4, IC1.14 (T1OUT), MAX_TX.P$1
MEGA_RX: ATMEGA.20 (PD2(RX)), IC1.12 (R1OUT), MEGA_RX.P$1
MEGA_TX: ATMEGA.21 (PD3(TX)), IC1.11 (T1IN), MEGA_TX.P$1
MISO: ATMEGA.11 (PB3(MISO)), SPI_PINS.1
MOSI: ATMEGA.10 (PB2(MOSI)), SPI_PINS.3
unnamed: HUMIDITY.3 (SCL), R5.1
unnamed: HUMIDITY.4 (SDA), R6.1
unnamed: C6.2, HUMIDITY.1 (VCORE)
unnamed: C5.2, HUMIDITY.2 (VSS)
unnamed: C7.1, IC1.1 (C1+)
unnamed: C8.1, IC1.4 (C2+)
unnamed: C8.2, IC1.5 (C2-)
unnamed: C7.2, IC1.3 (C1-)
unnamed: C10.1, IC1.2 (V+)
unnamed: C11.1, IC1.6 (V-)
unnamed: ATMEGA.3 (D-), R2.1
unnamed: ATMEGA.4 (D+), R3.1
unnamed: ATMEGA.6 (UCAP), C3.1
unnamed: LED1.A, R4.2
RESET: ATMEGA.13 (!RESET), SPI_PINS.4
SCK: ATMEGA.9 (PB1(SCK)), SPI_PINS.5
SCL: ATMEGA.18 (PD0(SCL)), R5.2, SCL.P$1
SDA: ATMEGA.19 (PD1(SDA)), R6.2, SDA.P$1
TAL1: 16MHZ_CRYSTAL.1, ATMEGA.17 (XTAL1), C2.2
TAL2: 16MHZ_CRYSTAL.2, ATMEGA.16 (XTAL2), C1.2
VBUS: ATMEGA.7 (VBUS), C14.1, J1.VBUS

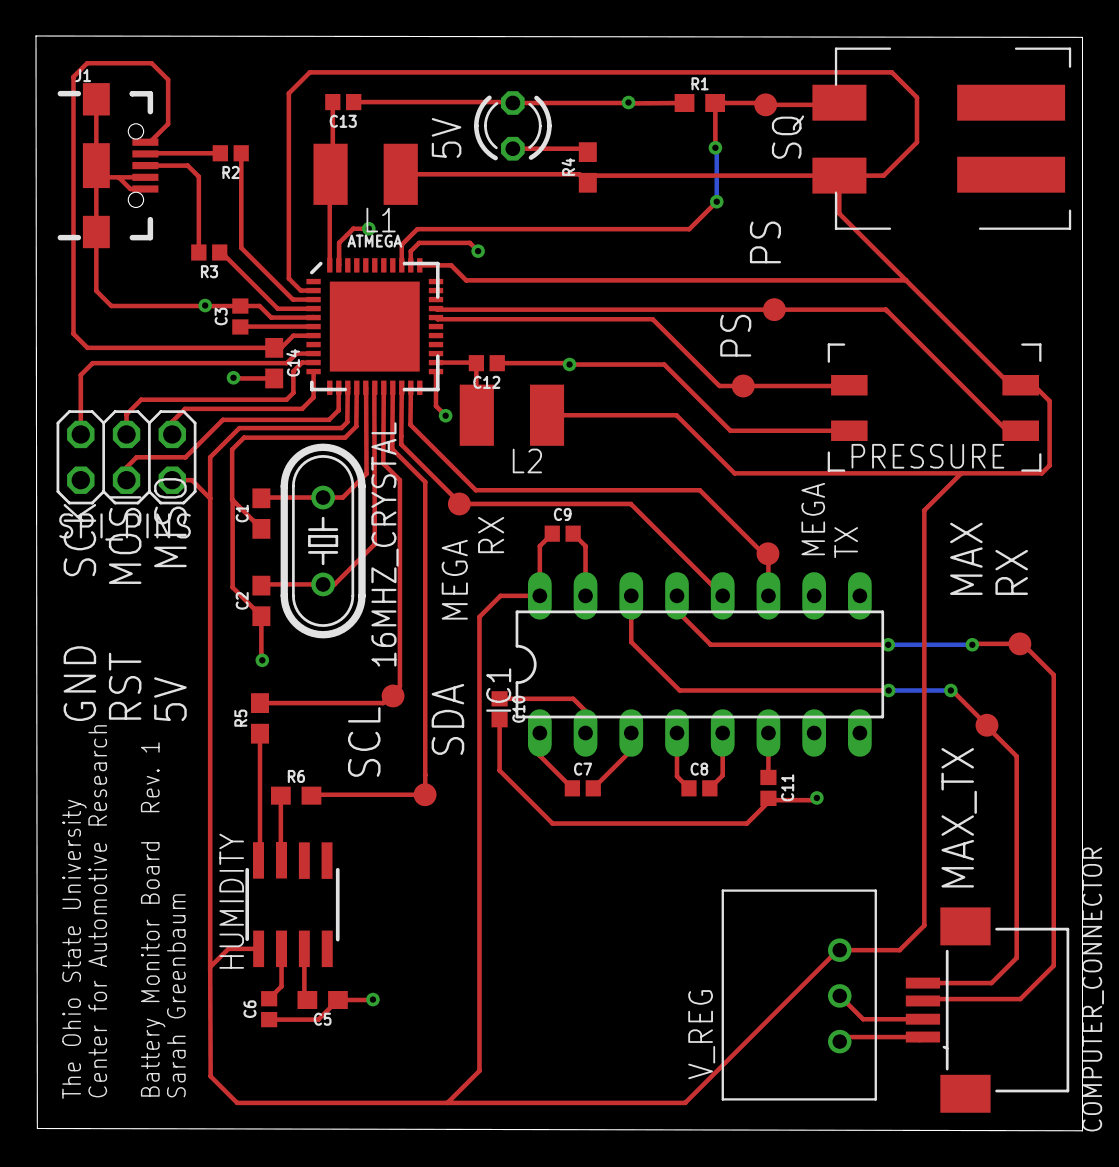
[picture p25: board Battery_Monitor.brd from above]

Board: 2 copper layers, 58.1 x 60.8 mm, 41 parts (0 on the bottom side), 37 nets.
