osu-uwrt/hardware_boards/Status Board/Current Rev/Status_Board.brd

## EAGLE design Status Board/Current Rev/Status_Board.brd (2018-04-06)

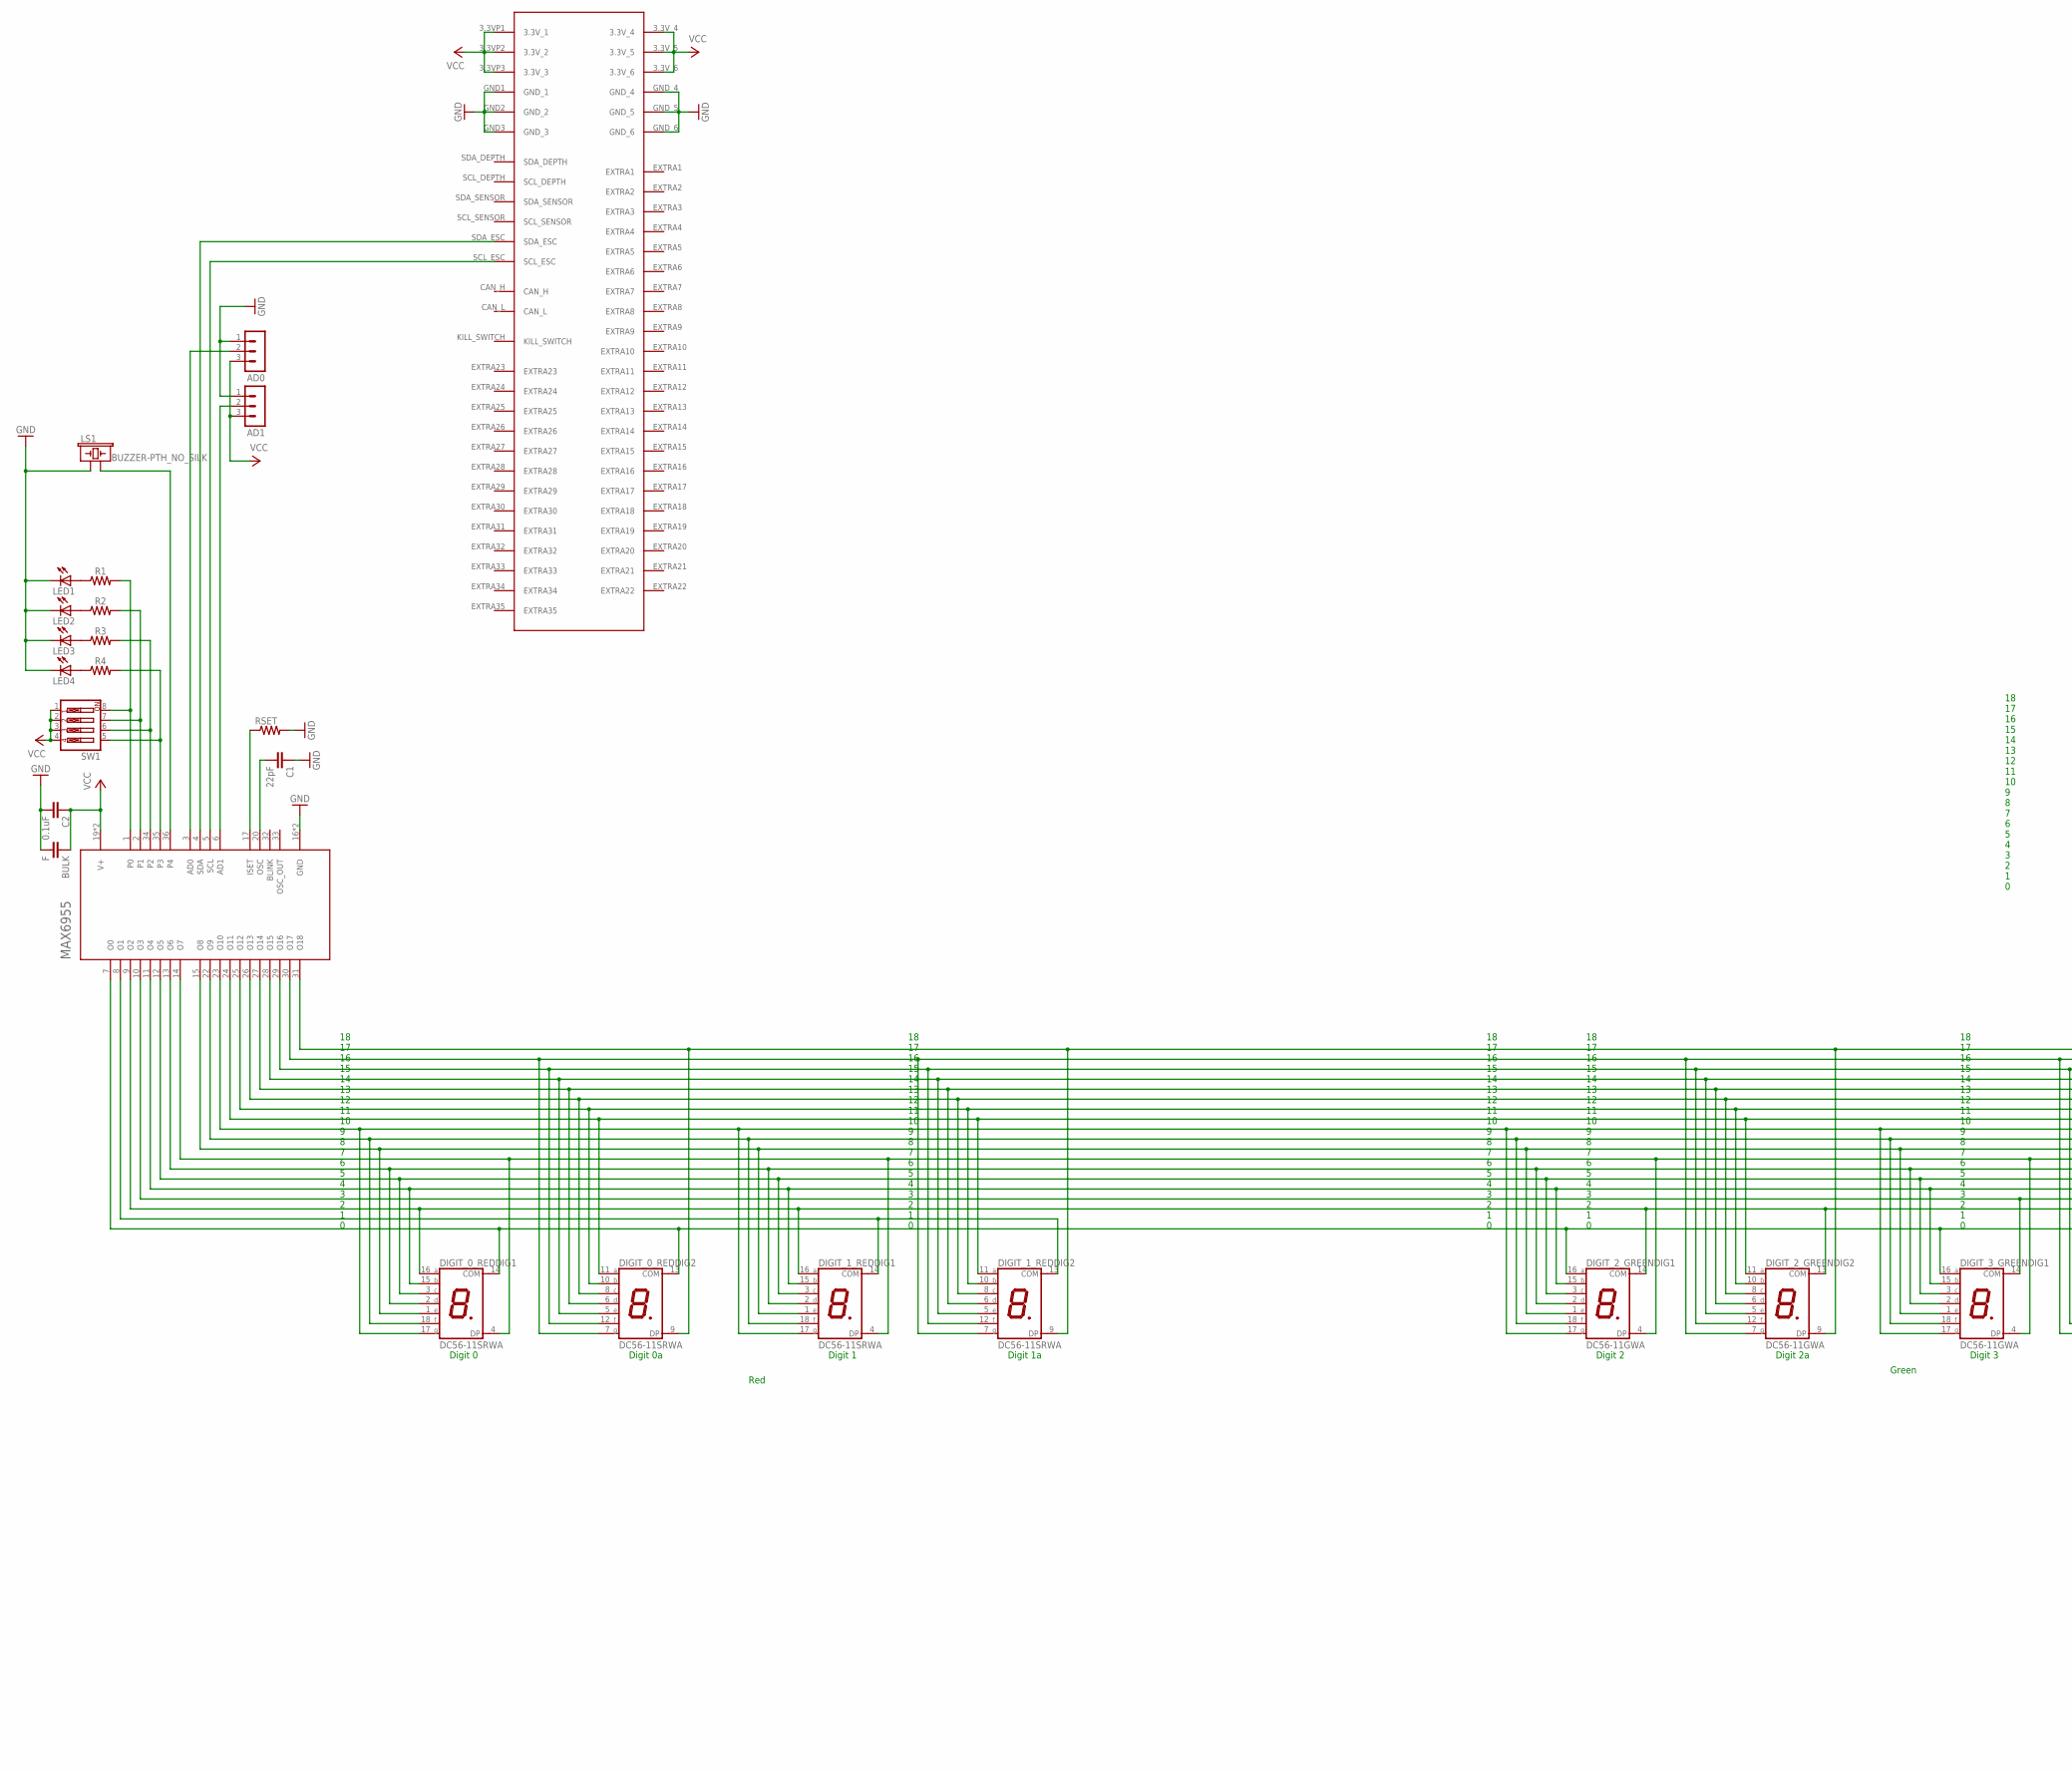
[picture p26: schematic Status_Board.sch, part in row 1, column 1]

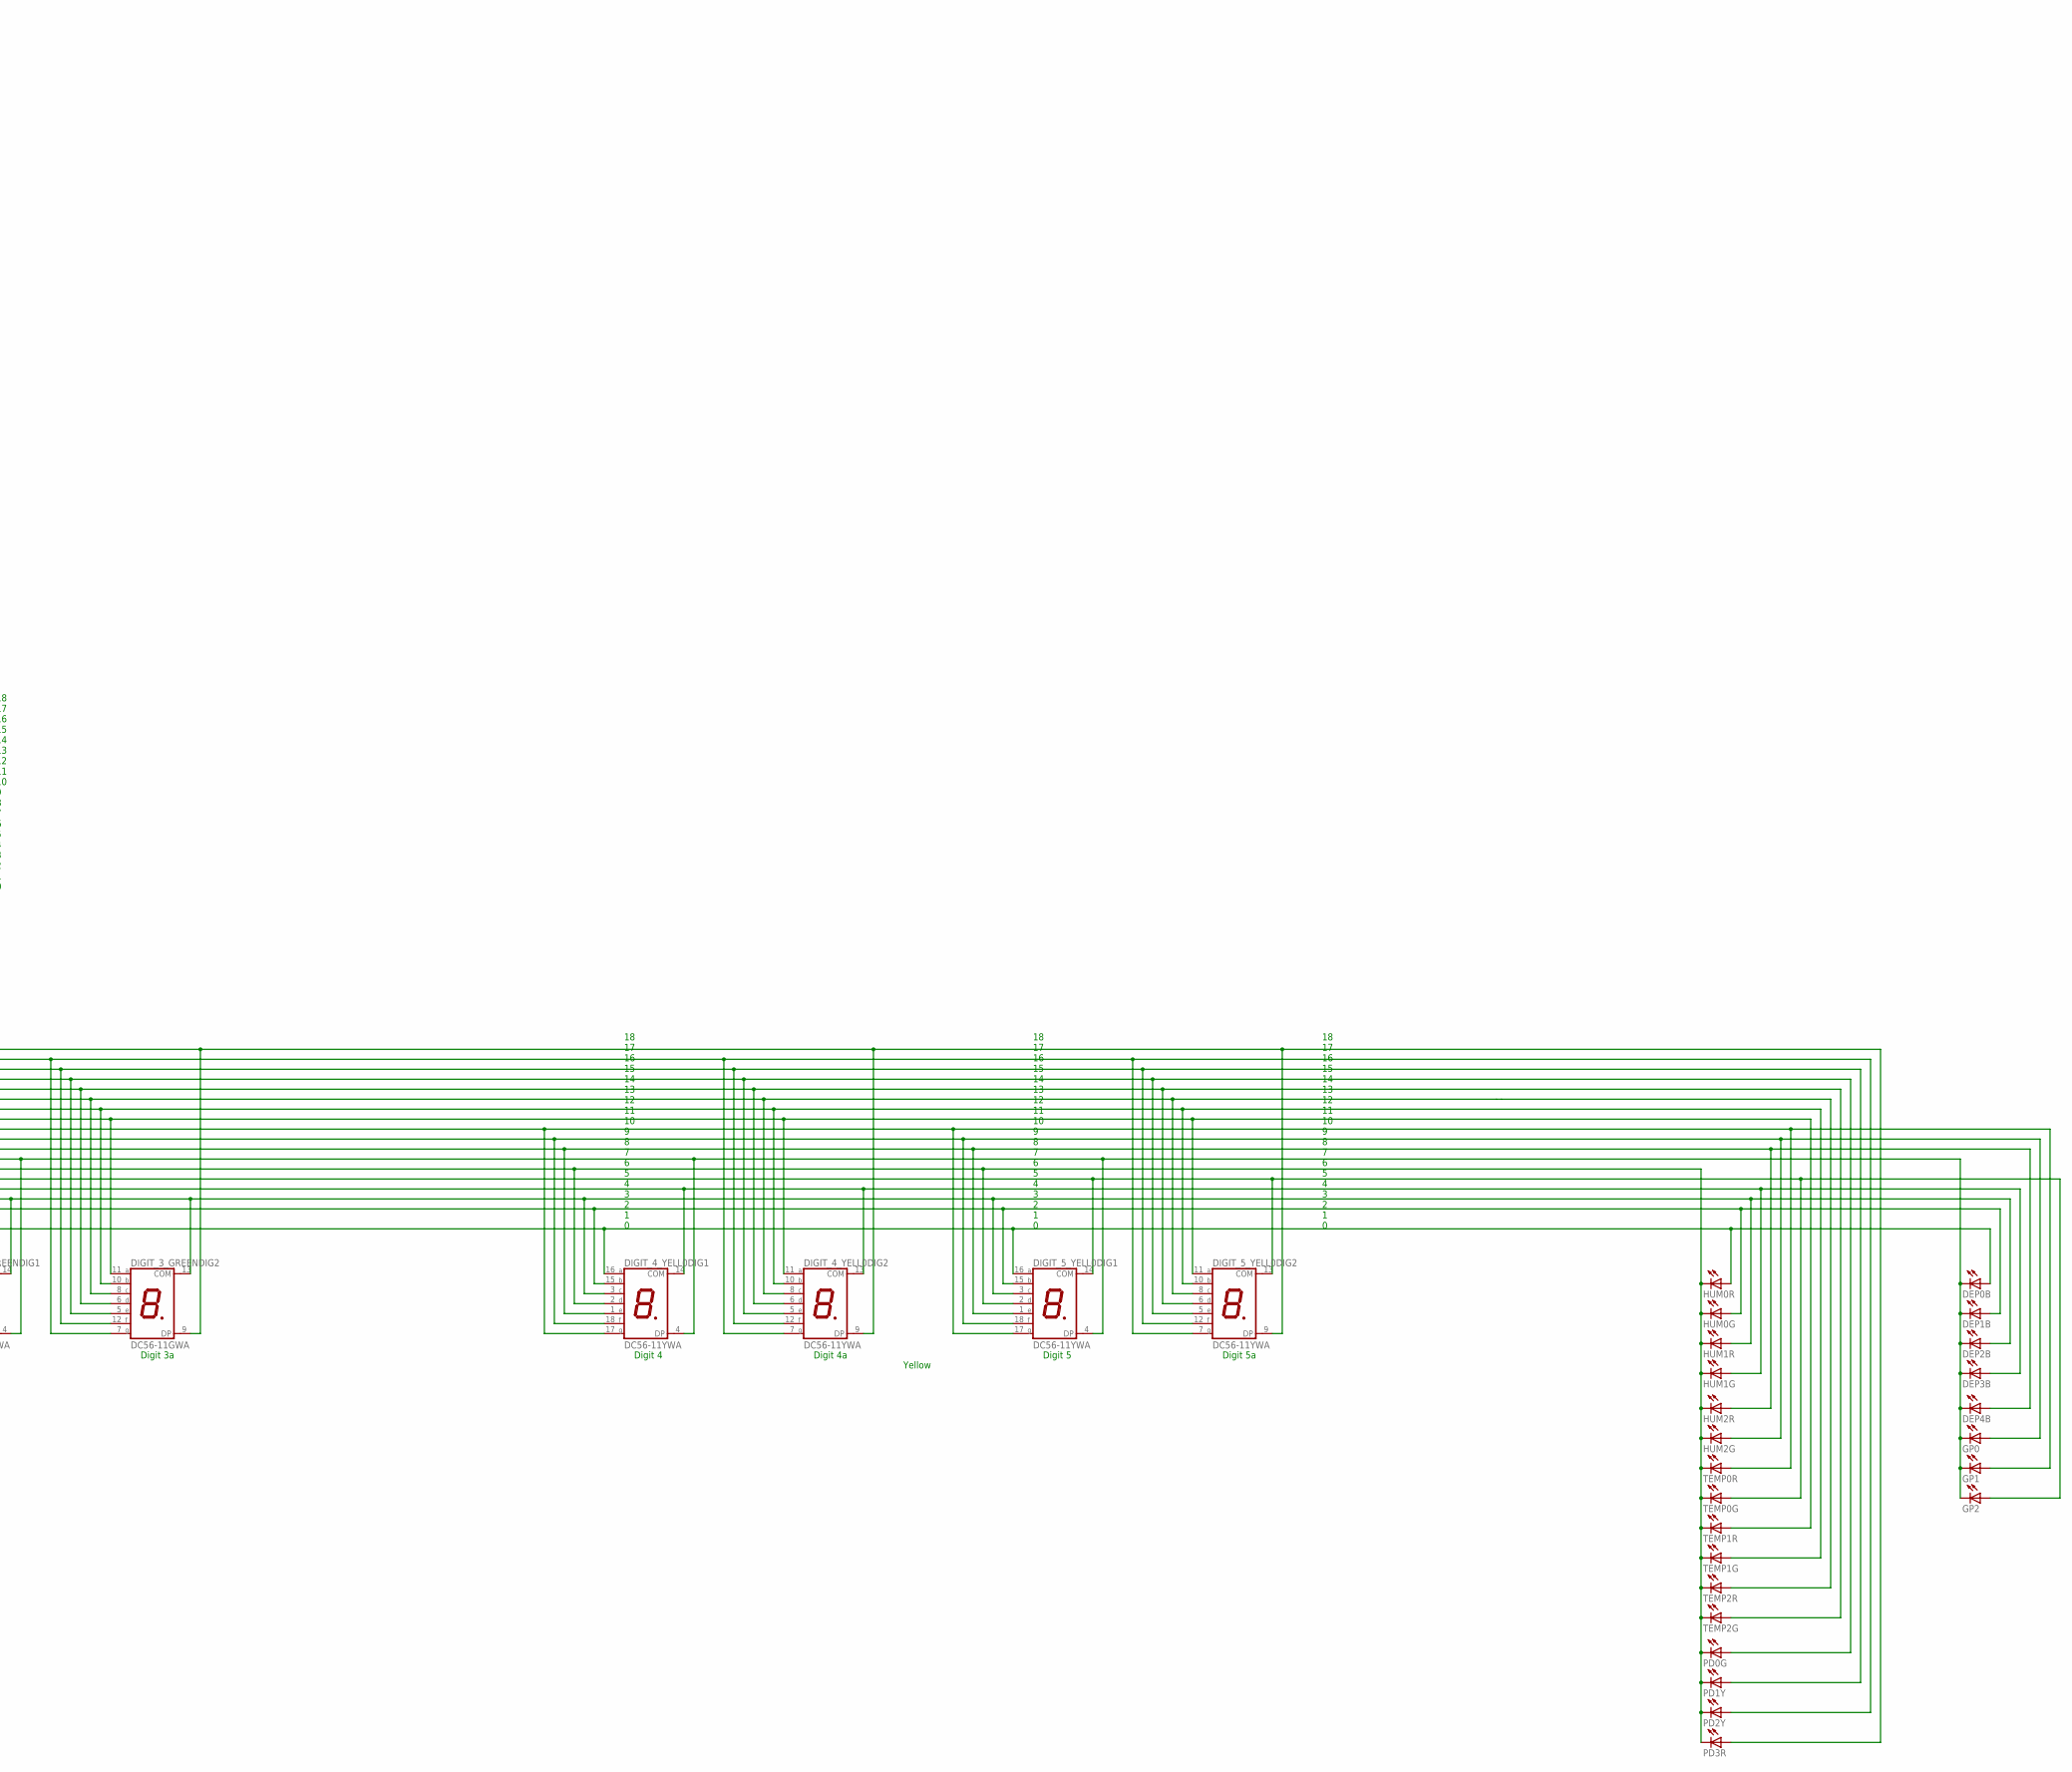
[picture p27: schematic Status_Board.sch, part in row 1, column 2]

Parts:
AD0, AD1: MA03-1
BULK: F; CAP-PTH-SMALL-KIT
C1: 22pF; CAP-PTH-2.54
C2: 0.1uF; CAP-PTH-SMALL-KIT
DEP0B, DEP1B, DEP2B, DEP3B, DEP4B: LED3MM
DIGIT_0_RED, DIGIT_1_RED: DC56-11SRWA; DA56
DIGIT_2_GREEN, DIGIT_3_GREEN: DC56-11GWA; DA56
DIGIT_4_YELL0, DIGIT_5_YELL0: DC56-11YWA; DA56
GP0, GP1, GP2: LED3MM
HUM0G, HUM0R, HUM1G, HUM1R, HUM2G, HUM2R: LED3MM
LED1, LED2, LED3, LED4: LED_ESML0603; LED_SML0603
LS1: BUZZER-PTH_NO_SILK; BUZZER-12MM-NS
MAX6955: MAX6955; SSOP36
PD0G, PD1Y, PD2Y, PD3R: LED3MM
R1, R2, R3, R4: 68OHM-0603-1/10W-1%; 0603
RSET: R-US_0207/12; 0207/12
SW1: SW_DIP-4; EDG-04
TEMP0G, TEMP0R, TEMP1G, TEMP1R, TEMP2G, TEMP2R: LED3MM
U$2: 5530843; 5530843-6-BOARDFINGERS

Connections:
013: DIGIT_0_RED.8 (C), DIGIT_1_RED.8 (C), DIGIT_2_GREEN.8 (C), DIGIT_3_GREEN.8 (C), DIGIT_4_YELL0.8 (C), DIGIT_5_YELL0.8 (C), MAX6955.26 (O13), TEMP2R.A
AD0: AD0.2, MAX6955.3 (AD0)
AD1: AD1.2, MAX6955.6 (AD1)
GND: AD0.1, AD1.1, BULK.2, C1.1, C2.2, LED1.C, LED2.C, LED3.C, LED4.C, LS1.+ (1), MAX6955.16 (GND), MAX6955.18 (GND), RSET.2, U$2.GND1 (GND_1), U$2.GND2 (GND_2), U$2.GND3 (GND_3), U$2.GND_4, U$2.GND_5, U$2.GND_6
ISET: MAX6955.17 (ISET), RSET.1
unnamed: LED1.A, R1.1
unnamed: LED2.A, R2.1
unnamed: LED3.A, R3.1
unnamed: LED4.A, R4.1
O0: DEP0B.A, DIGIT_0_RED.13 (COM), DIGIT_0_RED.14 (COM), DIGIT_2_GREEN.16 (A), DIGIT_3_GREEN.16 (A), DIGIT_4_YELL0.16 (A), DIGIT_5_YELL0.16 (A), HUM0R.A, MAX6955.7 (O0)
O1: DIGIT_1_RED.13 (COM), DIGIT_1_RED.14 (COM), MAX6955.8 (O1)
O2: DEP1B.A, DIGIT_0_RED.16 (A), DIGIT_1_RED.16 (A), DIGIT_2_GREEN.13 (COM), DIGIT_2_GREEN.14 (COM), DIGIT_4_YELL0.15 (B), DIGIT_5_YELL0.15 (B), HUM0G.A, MAX6955.9 (O2)
O3: DEP2B.A, DIGIT_3_GREEN.13 (COM), DIGIT_3_GREEN.14 (COM), DIGIT_4_YELL0.3 (C), DIGIT_5_YELL0.3 (C), HUM1R.A, MAX6955.10 (O3)
O4: DEP3B.A, DIGIT_0_RED.15 (B), DIGIT_1_RED.15 (B), DIGIT_2_GREEN.15 (B), DIGIT_3_GREEN.15 (B), DIGIT_4_YELL0.13 (COM), DIGIT_4_YELL0.14 (COM), HUM1G.A, MAX6955.11 (O4)
O5: DIGIT_0_RED.3 (C), DIGIT_1_RED.3 (C), DIGIT_2_GREEN.3 (C), DIGIT_3_GREEN.3 (C), DIGIT_5_YELL0.13 (COM), DIGIT_5_YELL0.14 (COM), GP2.A, MAX6955.12 (O5), TEMP0G.A
O6: DIGIT_0_RED.2 (D), DIGIT_1_RED.2 (D), DIGIT_2_GREEN.2 (D), DIGIT_3_GREEN.2 (D), DIGIT_4_YELL0.2 (D), DIGIT_5_YELL0.2 (D), HUM0G.K (C), HUM0R.K (C), HUM1G.K (C), HUM1R.K (C), HUM2G.K (C), HUM2R.K (C), MAX6955.13 (O6), PD0G.K (C), PD1Y.K (C), PD2Y.K (C), PD3R.K (C), TEMP0G.K (C), TEMP0R.K (C), TEMP1G.K (C), TEMP1R.K (C), TEMP2G.K (C), TEMP2R.K (C)
O7: DEP0B.K (C), DEP1B.K (C), DEP2B.K (C), DEP3B.K (C), DEP4B.K (C), DIGIT_0_RED.4 (DP), DIGIT_1_RED.4 (DP), DIGIT_2_GREEN.4 (DP), DIGIT_3_GREEN.4 (DP), DIGIT_4_YELL0.4 (DP), DIGIT_5_YELL0.4 (DP), GP0.K (C), GP1.K (C), GP2.K (C), MAX6955.14 (O7)
O8: DEP4B.A, DIGIT_0_RED.1 (E), DIGIT_1_RED.1 (E), DIGIT_2_GREEN.1 (E), DIGIT_3_GREEN.1 (E), DIGIT_4_YELL0.1 (E), DIGIT_5_YELL0.1 (E), HUM2R.A, MAX6955.15 (O8)
O9: DIGIT_0_RED.18 (F), DIGIT_1_RED.18 (F), DIGIT_2_GREEN.18 (F), DIGIT_3_GREEN.18 (F), DIGIT_4_YELL0.18 (F), DIGIT_5_YELL0.18 (F), GP0.A, HUM2G.A, MAX6955.22 (O9)
O10: DIGIT_0_RED.17 (G), DIGIT_1_RED.17 (G), DIGIT_2_GREEN.17 (G), DIGIT_3_GREEN.17 (G), DIGIT_4_YELL0.17 (G), DIGIT_5_YELL0.17 (G), GP1.A, MAX6955.23 (O10), TEMP0R.A
O11: DIGIT_0_RED.11 (A), DIGIT_1_RED.11 (A), DIGIT_2_GREEN.11 (A), DIGIT_3_GREEN.11 (A), DIGIT_4_YELL0.11 (A), DIGIT_5_YELL0.11 (A), MAX6955.24 (O11), TEMP1R.A
O12: DIGIT_0_RED.10 (B), DIGIT_1_RED.10 (B), DIGIT_2_GREEN.10 (B), DIGIT_3_GREEN.10 (B), DIGIT_4_YELL0.10 (B), DIGIT_5_YELL0.10 (B), MAX6955.25 (O12), TEMP1G.A
O14: DIGIT_0_RED.6 (D), DIGIT_1_RED.6 (D), DIGIT_2_GREEN.6 (D), DIGIT_3_GREEN.6 (D), DIGIT_4_YELL0.6 (D), DIGIT_5_YELL0.6 (D), MAX6955.27 (O14), TEMP2G.A
O15: DIGIT_0_RED.5 (E), DIGIT_1_RED.5 (E), DIGIT_2_GREEN.5 (E), DIGIT_3_GREEN.5 (E), DIGIT_4_YELL0.5 (E), DIGIT_5_YELL0.5 (E), MAX6955.28 (O15), PD0G.A
O16: DIGIT_0_RED.12 (F), DIGIT_1_RED.12 (F), DIGIT_2_GREEN.12 (F), DIGIT_3_GREEN.12 (F), DIGIT_4_YELL0.12 (F), DIGIT_5_YELL0.12 (F), MAX6955.29 (O16), PD1Y.A
O17: DIGIT_0_RED.7 (G), DIGIT_1_RED.7 (G), DIGIT_2_GREEN.7 (G), DIGIT_3_GREEN.7 (G), DIGIT_4_YELL0.7 (G), DIGIT_5_YELL0.7 (G), MAX6955.30 (O17), PD2Y.A
O18: DIGIT_0_RED.9 (DP), DIGIT_1_RED.9 (DP), DIGIT_2_GREEN.9 (DP), DIGIT_3_GREEN.9 (DP), DIGIT_4_YELL0.9 (DP), DIGIT_5_YELL0.9 (DP), MAX6955.31 (O18), PD3R.A
OSC: C1.2, MAX6955.20 (OSC)
P0: MAX6955.1 (P0), R1.2, SW1.8
P1: MAX6955.2 (P1), R2.2, SW1.7
P2: MAX6955.34 (P2), R3.2, SW1.6
P3: MAX6955.35 (P3), R4.2, SW1.5
P4: LS1.- (2), MAX6955.36 (P4)
SCL: MAX6955.5 (SCL), U$2.SCL_ESC
SDA: MAX6955.4 (SDA), U$2.SDA_ESC
VCC: AD0.3, AD1.3, BULK.1, C2.1, MAX6955.19 (V+), MAX6955.21 (V+), SW1.1, SW1.2, SW1.3, SW1.4, U$2.3.3VP1 (3.3V_1), U$2.3.3VP2 (3.3V_2), U$2.3.3VP3 (3.3V_3), U$2.3.3V_4, U$2.3.3V_5, U$2.3.3V_6

Notes on the sheet:
Green
Red
Yellow
Digit 0
Digit 0a
18 17 16 15 14 13 12 11 10 9 8 7 6 5 4 3 2 1 0
Digit 1
Digit 1a
Digit 2
Digit 2a
Digit 3
Digit 3a
Digit 4
Digit 4a
Digit 5
Digit 5a

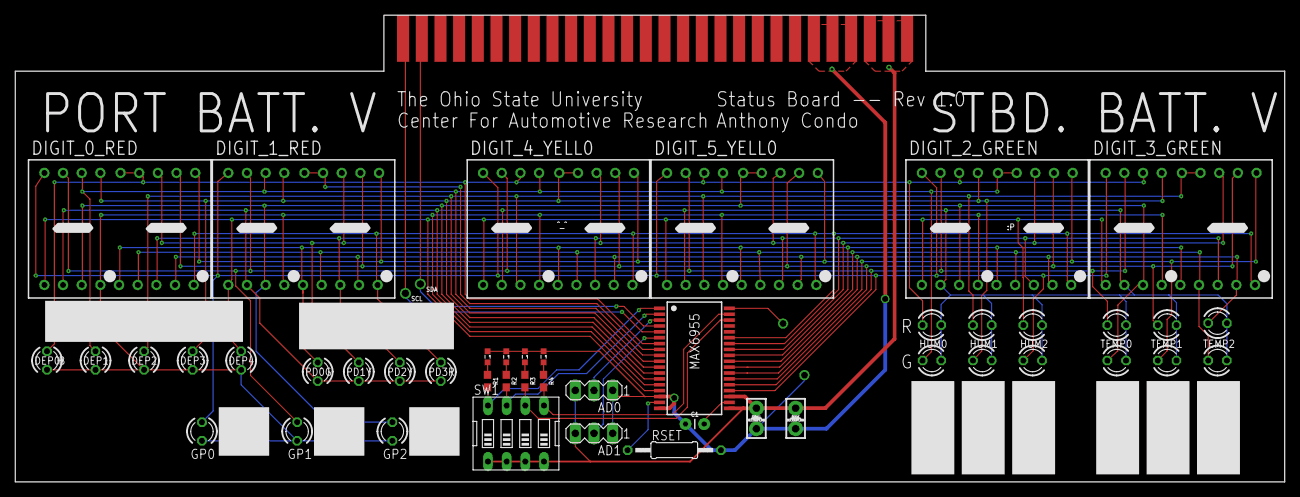
[picture p28: board Status_Board.brd from above]

Board: 2 copper layers, 172.7 x 63.5 mm, 48 parts (0 on the bottom side), 36 nets.
