osu-uwrt/hardware_boards/coProcessor/CoprocessorBoard3.0.brd

## EAGLE design coProcessor/CoprocessorBoard3.0.brd (2018-04-06)

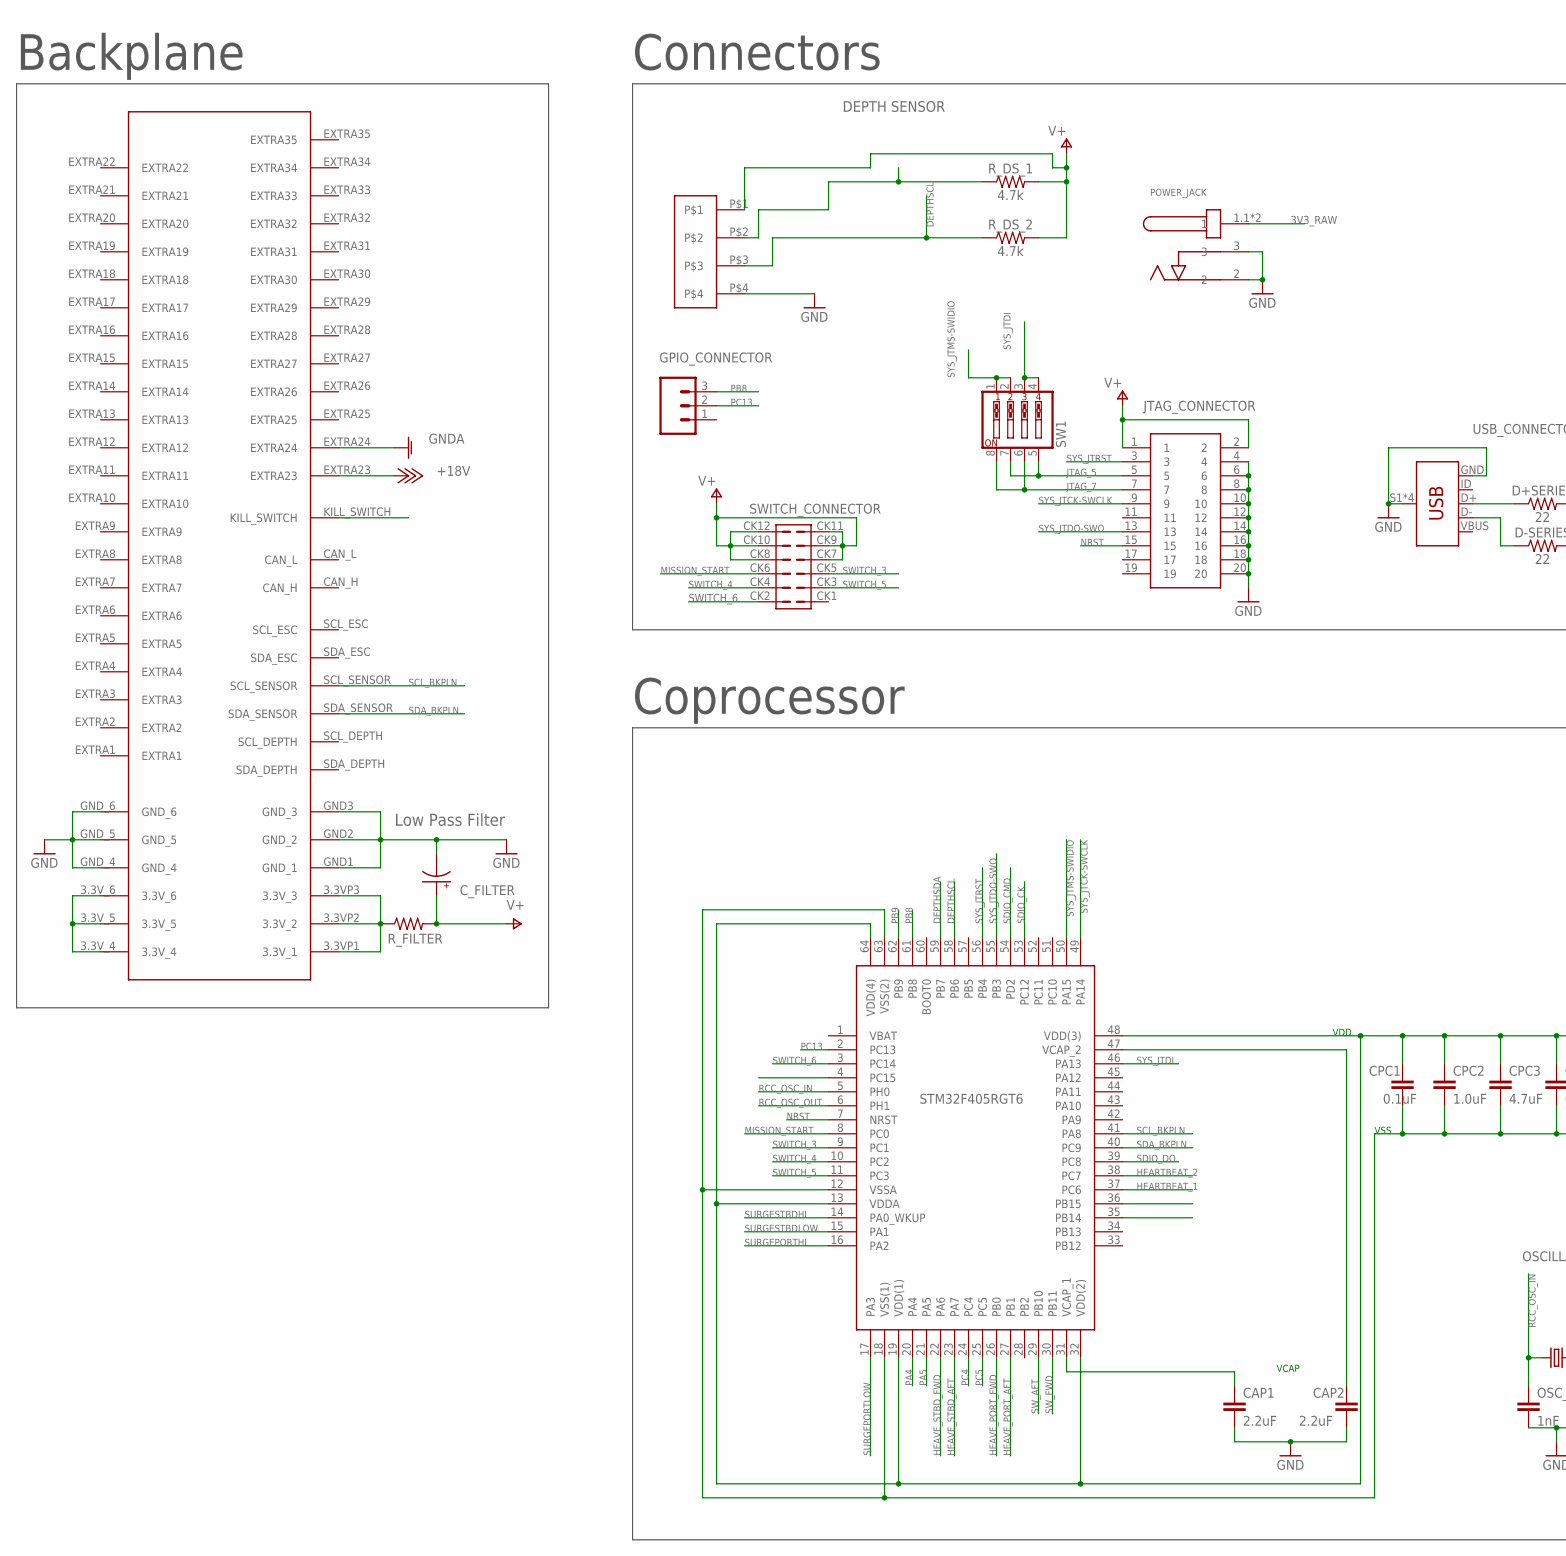
[picture p29: schematic CoprocessorBoard3.0.sch, part in row 1, column 1]

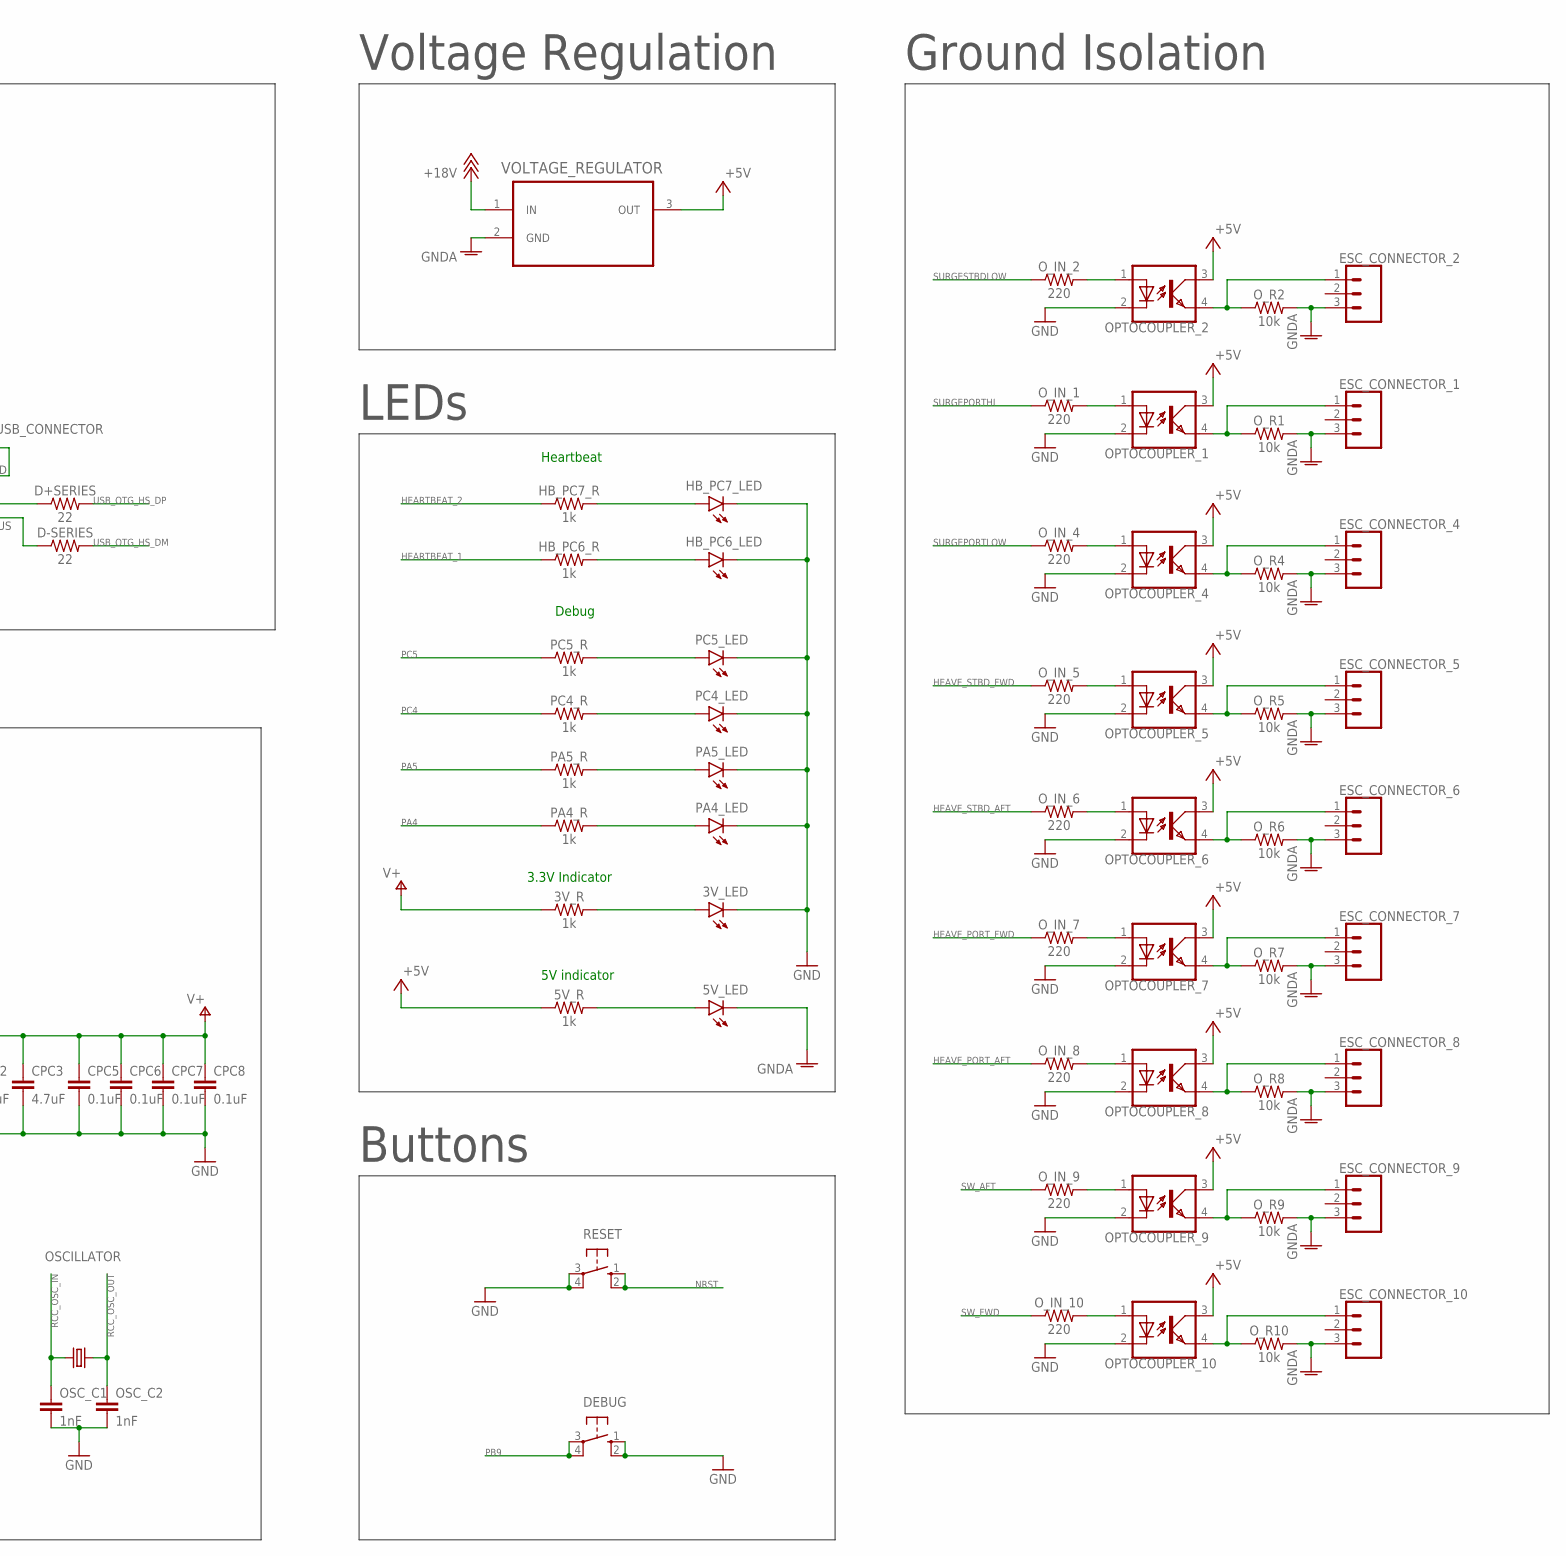
[picture p30: schematic CoprocessorBoard3.0.sch, part in row 1, column 2]

Parts:
3V_LED, 5V_LED: WHITE; LED-0603
3V_R, 5V_R: 1k; AXIAL-0.3
CAP1, CAP2: 2.2uF; 0603
CPC1, CPC5, CPC6, CPC7, CPC8: 0.1uF; 0603
CPC2: 1.0uF; 0603
CPC3: 4.7uF; 0603
C_FILTER: CPOL-USE2-5; E2-5
D+SERIES: 22; AXIAL-0.3
D-SERIES: 22; AXIAL-0.3
DEBUG: 10-XX; B3F-10XX
ESC_CONNECTOR_1, ESC_CONNECTOR_2, ESC_CONNECTOR_4, ESC_CONNECTOR_5, ESC_CONNECTOR_6, ESC_CONNECTOR_7, ESC_CONNECTOR_8, ESC_CONNECTOR_9, ESC_CONNECTOR_10: 455-1750-1-ND; 1X03
GPIO_CONNECTOR: 455-1750-1-ND; 1X03
HB_PC6_LED, HB_PC7_LED: WHITE; LED-0603
HB_PC6_R, HB_PC7_R: 1k; AXIAL-0.3
IC1: STM32F405RGT6; QFP50P1200X1200X160-64N
JTAG_CONNECTOR: 30320-6002HB; SHDR20W81P254_2X10_3300X840X93
OPTOCOUPLER_1, OPTOCOUPLER_2, OPTOCOUPLER_4, OPTOCOUPLER_5, OPTOCOUPLER_6, OPTOCOUPLER_7, OPTOCOUPLER_8, OPTOCOUPLER_9, OPTOCOUPLER_10: SFH610; DIL04
OSCILLATOR: CRYSTALHC49S; HC49/S
OSC_C1, OSC_C2: 1nF; CAP-PTH-2.54
O_IN_1, O_IN_2, O_IN_4, O_IN_5, O_IN_6, O_IN_7, O_IN_8, O_IN_9, O_IN_10: 220; AXIAL-0.3
O_R1, O_R2, O_R4, O_R5, O_R6, O_R7, O_R8, O_R9, O_R10: 10k; AXIAL-0.3
PA4_LED, PA5_LED: WHITE; LED-0603
PA4_R, PA5_R: 1k; AXIAL-0.3
PC4_LED, PC5_LED: WHITE; LED-0603
PC4_R, PC5_R: 1k; AXIAL-0.3
POWER_JACK: PJ-002AH-SMT-TR; CUI_PJ-002AH-SMT-TR
RESET: 10-XX; B3F-10XX
R_DS_1, R_DS_2: 4.7k; AXIAL-0.3
R_FILTER: R-US_0204/7; 0204/7
SW1: SW_DIP-4; EDG-04
SWITCH_CONNECTOR: 105314-2112
U$1: 5530843; 5530843-6-BOARDFINGERS
U$2: NANOFIT_4PIN_STR
USB_CONNECTOR: USB_MINI-B_SMT; USB-MINIB
VOLTAGE_REGULATOR: L78M05CV; TO254P450X1020X1935-3P

Connections:
3V3: 3V_R.P$1 (1), CPC1.1, CPC2.1, CPC3.1, CPC5.1, CPC6.1, CPC7.1, CPC8.1, C_FILTER.+, IC1.13 (VDDA), IC1.19 (VDD(1)), IC1.32 (VDD(2)), IC1.48 (VDD(3)), IC1.64 (VDD(4)), JTAG_CONNECTOR.1, JTAG_CONNECTOR.2, R_DS_1.P$2 (2), R_DS_2.P$2 (2), R_FILTER.2, SWITCH_CONNECTOR.CK7, SWITCH_CONNECTOR.CK8, SWITCH_CONNECTOR.CK9, SWITCH_CONNECTOR.CK10, SWITCH_CONNECTOR.CK11, SWITCH_CONNECTOR.CK12, U$2.P$1
3V3_RAW: POWER_JACK.1.1 (1), POWER_JACK.1.2 (1), R_FILTER.1, U$1.3.3VP1 (3.3V_1), U$1.3.3VP2 (3.3V_2), U$1.3.3VP3 (3.3V_3), U$1.3.3V_4, U$1.3.3V_5, U$1.3.3V_6
+5V: 5V_R.P$1 (1), OPTOCOUPLER_1.3 (COL), OPTOCOUPLER_2.3 (COL), OPTOCOUPLER_4.3 (COL), OPTOCOUPLER_5.3 (COL), OPTOCOUPLER_6.3 (COL), OPTOCOUPLER_7.3 (COL), OPTOCOUPLER_8.3 (COL), OPTOCOUPLER_9.3 (COL), OPTOCOUPLER_10.3 (COL), VOLTAGE_REGULATOR.3 (OUT)
+18V: U$1.EXTRA23, VOLTAGE_REGULATOR.1 (IN)
D+CON: D+SERIES.P$1 (1), USB_CONNECTOR.D+
D-CON: D-SERIES.P$1 (1), USB_CONNECTOR.D-
DEPTHSCL: IC1.58 (PB6), R_DS_2.P$1 (1), U$2.P$3
DEPTHSDA: IC1.59 (PB7), R_DS_1.P$1 (1), U$2.P$2
GND: 3V_LED.C, CAP1.2, CAP2.2, CPC1.2, CPC2.2, CPC3.2, CPC5.2, CPC6.2, CPC7.2, CPC8.2, C_FILTER.-, DEBUG.1 (S), DEBUG.2 (S1), HB_PC6_LED.C, HB_PC7_LED.C, IC1.12 (VSSA), IC1.18 (VSS(1)), IC1.63 (VSS(2)), JTAG_CONNECTOR.4, JTAG_CONNECTOR.6, JTAG_CONNECTOR.8, JTAG_CONNECTOR.10, JTAG_CONNECTOR.12, JTAG_CONNECTOR.14, JTAG_CONNECTOR.16, JTAG_CONNECTOR.18, JTAG_CONNECTOR.20, OPTOCOUPLER_1.2 (C), OPTOCOUPLER_2.2 (C), OPTOCOUPLER_4.2 (C), OPTOCOUPLER_5.2 (C), OPTOCOUPLER_6.2 (C), OPTOCOUPLER_7.2 (C), OPTOCOUPLER_8.2 (C), OPTOCOUPLER_9.2 (C), OPTOCOUPLER_10.2 (C), OSC_C1.2, OSC_C2.2, PA4_LED.C, PA5_LED.C, PC4_LED.C, PC5_LED.C, POWER_JACK.2, POWER_JACK.3, RESET.3, RESET.4 (P1), U$1.GND1 (GND_1), U$1.GND2 (GND_2), U$1.GND3 (GND_3), U$1.GND_4, U$1.GND_5, U$1.GND_6, U$2.P$4, USB_CONNECTOR.GND, USB_CONNECTOR.S1 (SHIELD), USB_CONNECTOR.S2 (SHIELD), USB_CONNECTOR.S3 (SHIELD), USB_CONNECTOR.S4 (SHIELD)
GNDBAT: 5V_LED.C, ESC_CONNECTOR_1.3, ESC_CONNECTOR_2.3, ESC_CONNECTOR_4.3, ESC_CONNECTOR_5.3, ESC_CONNECTOR_6.3, ESC_CONNECTOR_7.3, ESC_CONNECTOR_8.3, ESC_CONNECTOR_9.3, ESC_CONNECTOR_10.3, O_R1.P$2 (2), O_R2.P$2 (2), O_R4.P$2 (2), O_R5.P$2 (2), O_R6.P$2 (2), O_R7.P$2 (2), O_R8.P$2 (2), O_R9.P$2 (2), O_R10.P$2 (2), U$1.EXTRA24, VOLTAGE_REGULATOR.2 (GND)
HEARTBEAT_1: HB_PC6_R.P$1 (1), IC1.37 (PC6)
HEARTBEAT_2: HB_PC7_R.P$1 (1), IC1.38 (PC7)
HEAVE_PORT_AFT: IC1.27 (PB1), O_IN_8.P$1 (1)
HEAVE_PORT_FWD: IC1.26 (PB0), O_IN_7.P$1 (1)
HEAVE_STBD_AFT: IC1.23 (PA7), O_IN_6.P$1 (1)
HEAVE_STBD_FWD: IC1.22 (PA6), O_IN_5.P$1 (1)
JTAG_5: JTAG_CONNECTOR.5, SW1.5, SW1.7
JTAG_7: JTAG_CONNECTOR.7, SW1.6, SW1.8
KILL_SWITCH: IC1.4 (PC15), U$1.KILL_SWITCH
MISSION_START: IC1.8 (PC0), SWITCH_CONNECTOR.CK6
unnamed: ESC_CONNECTOR_1.1, OPTOCOUPLER_1.4 (EMIT), O_R1.P$1 (1)
unnamed: ESC_CONNECTOR_2.1, OPTOCOUPLER_2.4 (EMIT), O_R2.P$1 (1)
unnamed: OPTOCOUPLER_1.1 (A), O_IN_1.P$2 (2)
unnamed: ESC_CONNECTOR_4.1, OPTOCOUPLER_4.4 (EMIT), O_R4.P$1 (1)
unnamed: ESC_CONNECTOR_5.1, OPTOCOUPLER_5.4 (EMIT), O_R5.P$1 (1)
unnamed: ESC_CONNECTOR_6.1, OPTOCOUPLER_6.4 (EMIT), O_R6.P$1 (1)
unnamed: ESC_CONNECTOR_7.1, OPTOCOUPLER_7.4 (EMIT), O_R7.P$1 (1)
unnamed: ESC_CONNECTOR_8.1, OPTOCOUPLER_8.4 (EMIT), O_R8.P$1 (1)
unnamed: ESC_CONNECTOR_9.1, OPTOCOUPLER_9.4 (EMIT), O_R9.P$1 (1)
unnamed: ESC_CONNECTOR_10.1, OPTOCOUPLER_10.4 (EMIT), O_R10.P$1 (1)
unnamed: OPTOCOUPLER_10.1 (A), O_IN_10.P$2 (2)
unnamed: OPTOCOUPLER_9.1 (A), O_IN_9.P$2 (2)
unnamed: OPTOCOUPLER_8.1 (A), O_IN_8.P$2 (2)
unnamed: OPTOCOUPLER_7.1 (A), O_IN_7.P$2 (2)
unnamed: OPTOCOUPLER_6.1 (A), O_IN_6.P$2 (2)
unnamed: OPTOCOUPLER_5.1 (A), O_IN_5.P$2 (2)
unnamed: OPTOCOUPLER_4.1 (A), O_IN_4.P$2 (2)
unnamed: OPTOCOUPLER_2.1 (A), O_IN_2.P$2 (2)
unnamed: HB_PC6_LED.A, HB_PC6_R.P$2 (2)
unnamed: HB_PC7_LED.A, HB_PC7_R.P$2 (2)
unnamed: PC5_LED.A, PC5_R.P$2 (2)
unnamed: PC4_LED.A, PC4_R.P$2 (2)
unnamed: PA5_LED.A, PA5_R.P$2 (2)
unnamed: PA4_LED.A, PA4_R.P$2 (2)
unnamed: 5V_LED.A, 5V_R.P$2 (2)
unnamed: 3V_LED.A, 3V_R.P$2 (2)
NRST: IC1.7 (NRST), JTAG_CONNECTOR.15, RESET.1 (S), RESET.2 (S1)
PA4: IC1.20 (PA4), PA4_R.P$1 (1)
PA5: IC1.21 (PA5), PA5_R.P$1 (1)
PB8: GPIO_CONNECTOR.3, IC1.61 (PB8)
PB9: DEBUG.3, DEBUG.4 (P1), IC1.62 (PB9)
PC4: IC1.24 (PC4), PC4_R.P$1 (1)
PC5: IC1.25 (PC5), PC5_R.P$1 (1)
PC13: GPIO_CONNECTOR.2, IC1.2 (PC13)
RCC_OSC_IN: IC1.5 (PH0), OSCILLATOR.1, OSC_C1.1
RCC_OSC_OUT: IC1.6 (PH1), OSCILLATOR.2, OSC_C2.1
SCL_BKPLN: IC1.41 (PA8), U$1.SCL_SENSOR
SDA_BKPLN: IC1.40 (PC9), U$1.SDA_SENSOR
SDIO_CK: IC1.53 (PC12)
SDIO_CMD: IC1.54 (PD2)
SDIO_DO: IC1.39 (PC8)
SURGEPORTHI: IC1.16 (PA2), O_IN_1.P$1 (1)
SURGEPORTLOW: IC1.17 (PA3), O_IN_4.P$1 (1)
SURGESTBDHI: IC1.14 (PA0_WKUP)
SURGESTBDLOW: IC1.15 (PA1), O_IN_2.P$1 (1)
SWITCH_3: IC1.9 (PC1), SWITCH_CONNECTOR.CK5
SWITCH_4: IC1.10 (PC2), SWITCH_CONNECTOR.CK4
SWITCH_5: IC1.11 (PC3), SWITCH_CONNECTOR.CK3
SWITCH_6: IC1.3 (PC14), SWITCH_CONNECTOR.CK2
SW_AFT: IC1.29 (PB10), O_IN_9.P$1 (1)
SW_FWD: IC1.30 (PB11), O_IN_10.P$1 (1)
SYS_JTCK-SWCLK: IC1.49 (PA14), JTAG_CONNECTOR.9
SYS_JTDI: IC1.46 (PA13), SW1.3, SW1.4
SYS_JTDO-SWO: IC1.55 (PB3), JTAG_CONNECTOR.13
SYS_JTMS-SWIDIO: IC1.50 (PA15), SW1.1, SW1.2
SYS_JTRST: IC1.56 (PB4), JTAG_CONNECTOR.3
USB_OTG_HS_DM: D-SERIES.P$2 (2), IC1.35 (PB14)
USB_OTG_HS_DP: D+SERIES.P$2 (2), IC1.36 (PB15)
VBUS: USB_CONNECTOR.VBUS
VCAP1: CAP1.1, IC1.31 (VCAP_1)
VCAP2: CAP2.1, IC1.47 (VCAP_2)

Notes on the sheet:
Connectors
Voltage Regulation
Ground Isolation
Coprocessor
VCAP
VDD
VSS
Backplane
LEDs
Heartbeat
Debug
5V indicator
3.3V Indicator
Buttons
DEPTH SENSOR
Low Pass Filter

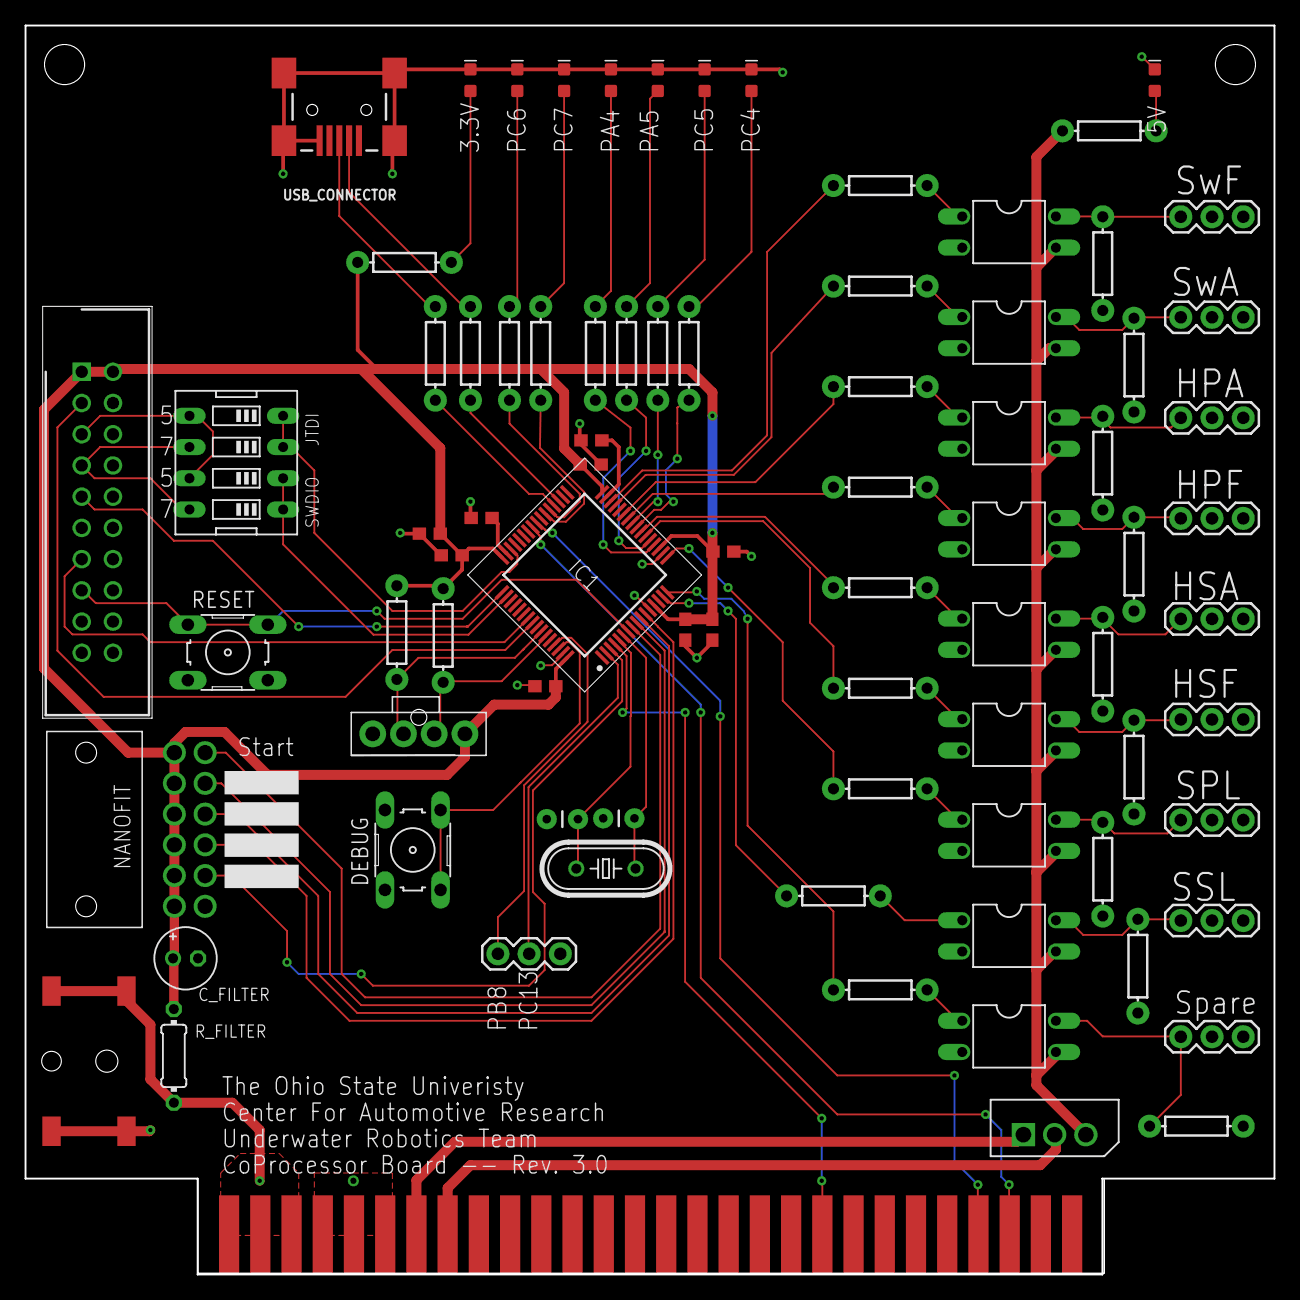
[picture p31: board CoprocessorBoard3.0.brd from above]

Board: 2 copper layers, 101.6 x 101.6 mm, 82 parts (0 on the bottom side), 76 nets.
