osu-uwrt/hardware_boards/coProcessor/OldRevs/Coprocessor_Board.brd

## EAGLE design coProcessor/OldRevs/Coprocessor_Board.brd (2018-01-24, an earlier design)

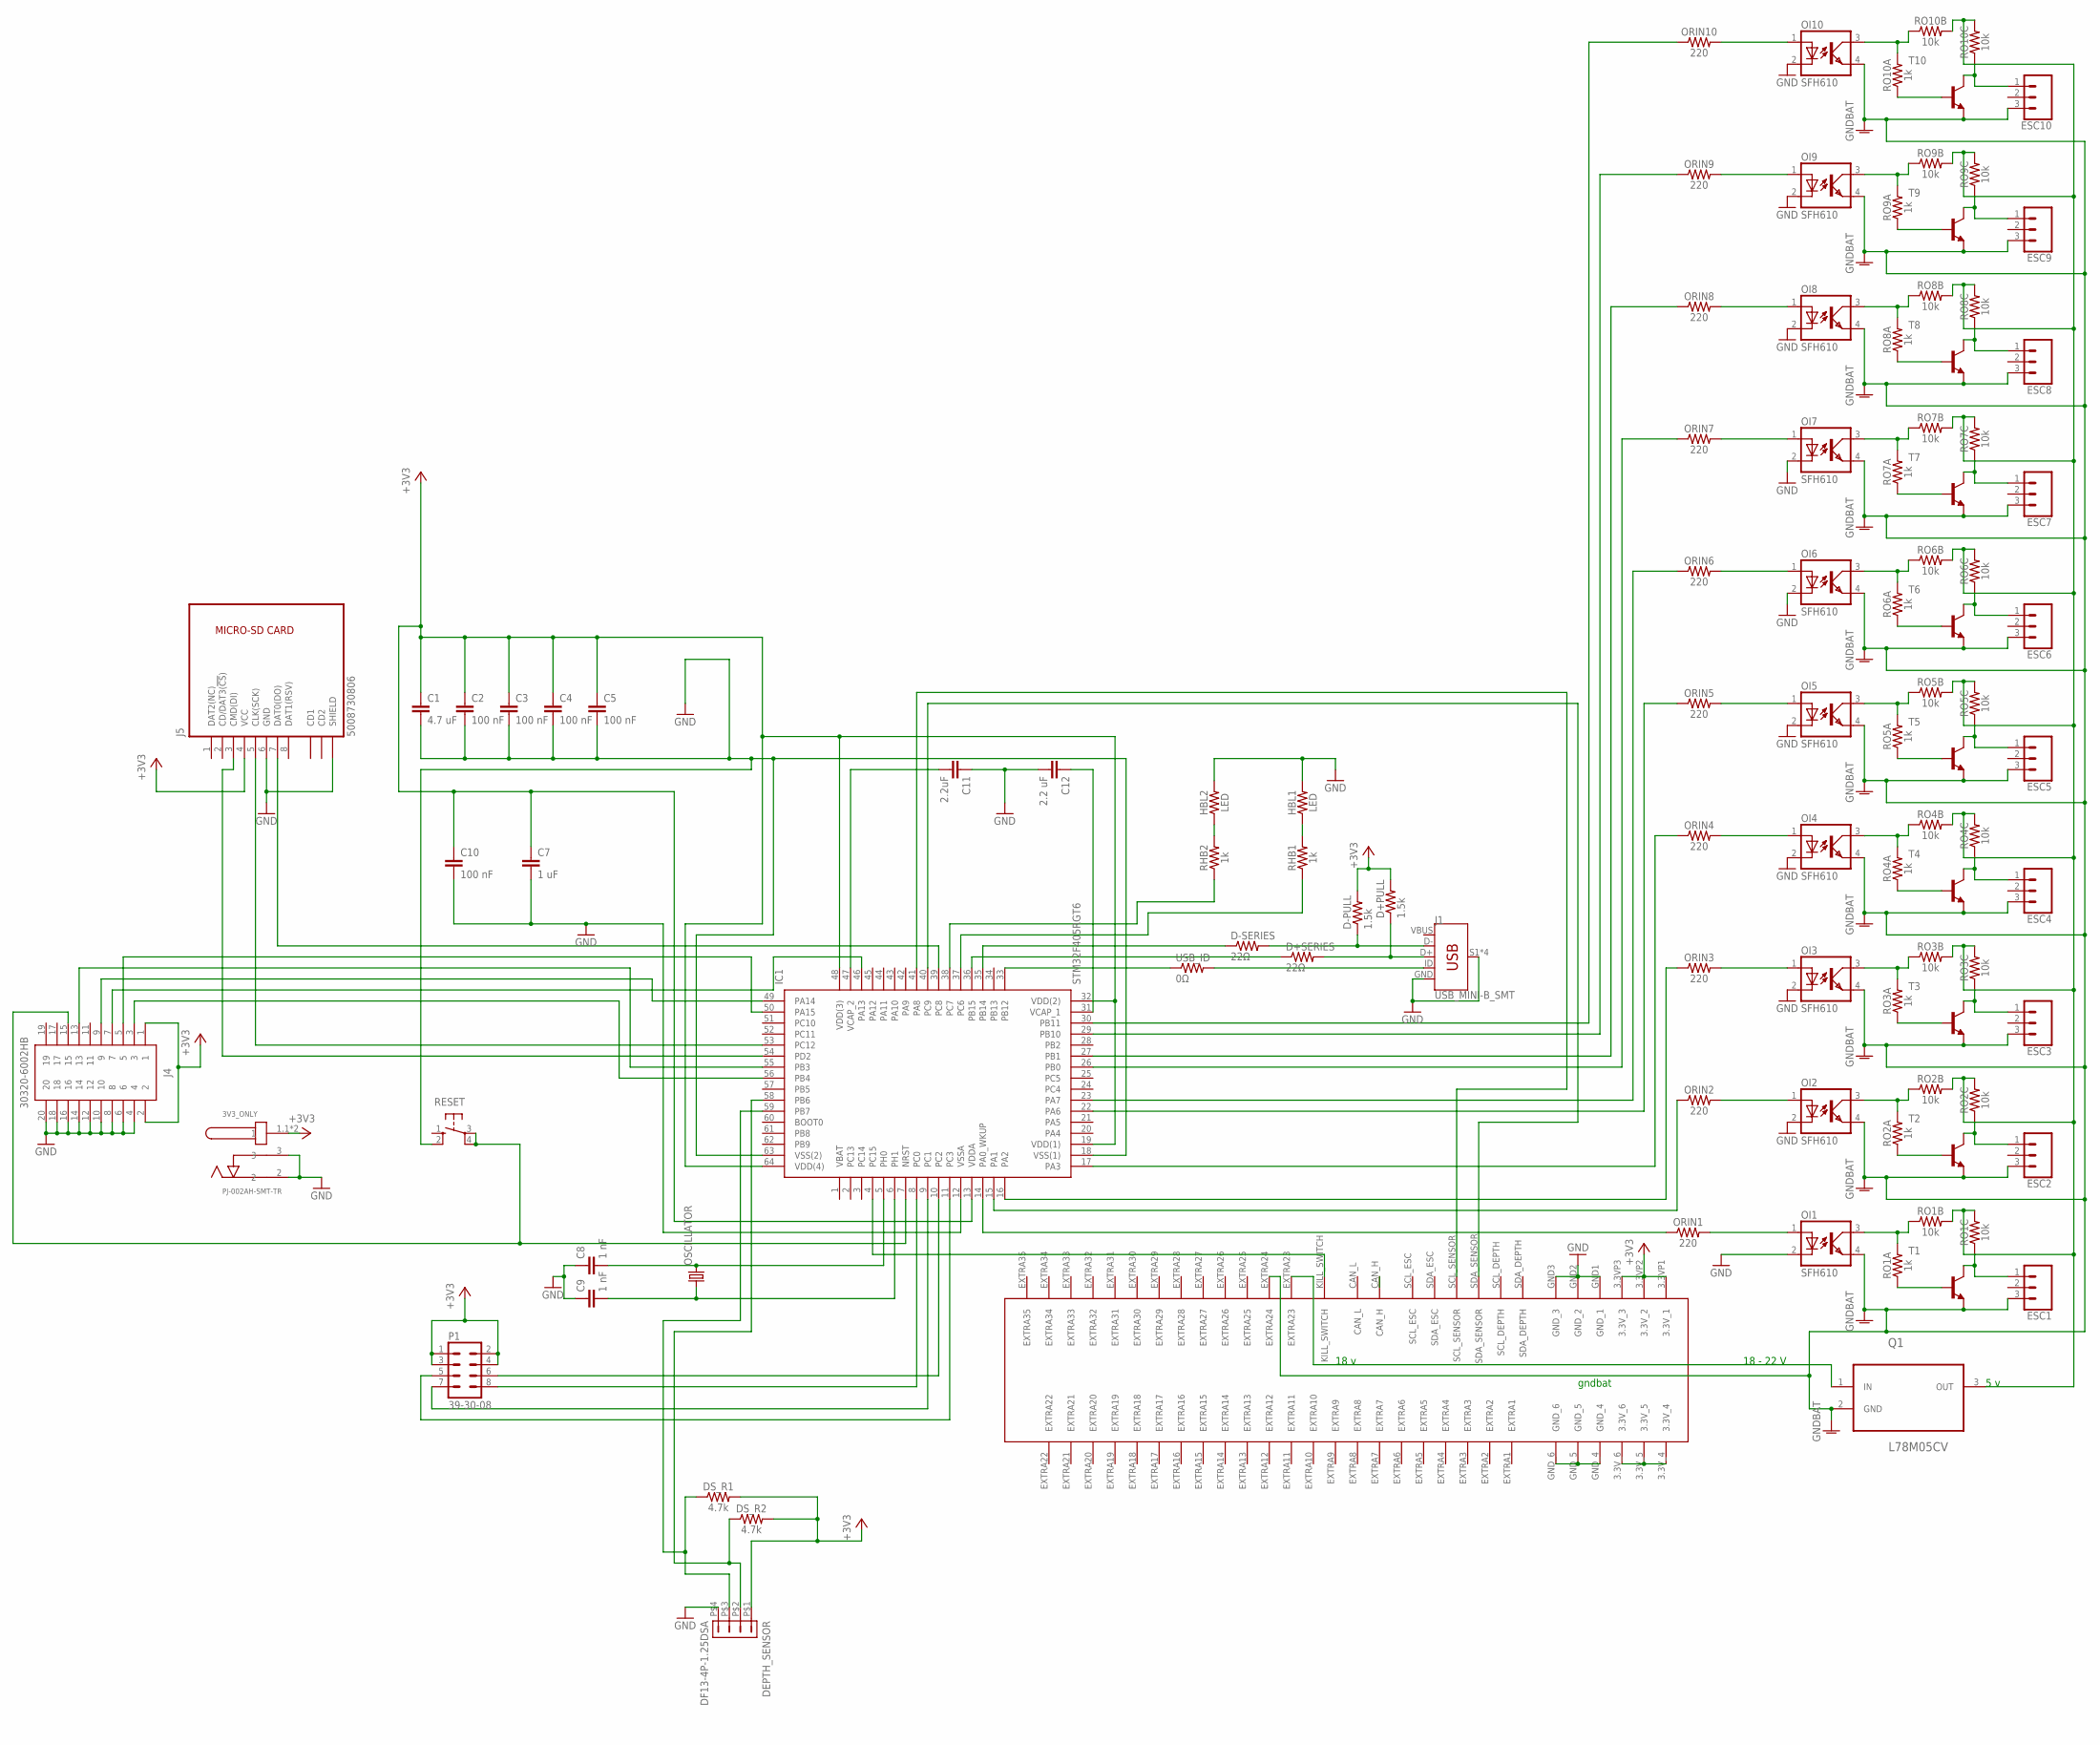
[picture p32: schematic Coprocessor_Board.sch]

Parts:
3V3_ONLY: PJ-002AH-SMT-TR; CUI_PJ-002AH-SMT-TR
C1: 4.7 uF; 0603
C2, C3, C4, C5, C10: 100 nF; 0603
C7: 1 uF; 0603
C8, C9: 1 nF; CAP-PTH-2.54
C11: 2.2uF; 0603
C12: 2.2 uF; 0603
D+PULL: 1.5k; 0204/7
D+SERIES: 22Ω; 0204/7
D-PULL: 1.5k; 0204/7
D-SERIES: 22Ω; 0204/7
DEPTH_SENSOR: DF13-4P-1.25DSA
DS_R1, DS_R2: 4.7k; AXIAL-0.1
ESC1, ESC2, ESC3, ESC4, ESC5, ESC6, ESC7, ESC8, ESC9, ESC10: CONN_03; 1X03
HBL1, HBL2: LED; AXIAL-0.1
IC1: STM32F405RGT6; QFP50P1200X1200X160-64N
J1: USB_MINI-B_SMT; USB-MINIB
J4: 30320-6002HB; SHDR20W81P254_2X10_3300X840X93
J5: 5008730806
OI1, OI2, OI3, OI4, OI5, OI6, OI7, OI8, OI9, OI10: SFH610; DIL04
ORIN1, ORIN2, ORIN3, ORIN4, ORIN5, ORIN6, ORIN7, ORIN8, ORIN9, ORIN10: 220; AXIAL-0.1
OSCILLATOR: CRYSTALHC49S; HC49/S
P1: 39-30-08; 39-30-?08?
Q1: L78M05CV; TO254P450X1020X1935-3P
RESET: 10-XX; B3F-10XX
RHB1, RHB2: 1k; AXIAL-0.3
RO1A, RO2A, RO3A, RO4A, RO5A, RO6A, RO7A, RO8A, RO9A, RO10A: 1k; 0603
RO1B, RO1C, RO2B, RO2C, RO3B, RO3C, RO4B, RO4C, RO5B, RO5C, RO6B, RO6C, RO7B, RO7C, RO8B, RO8C, RO9B, RO9C, RO10B, RO10C: 10k; 0603
T1, T2, T3, T4, T5, T6, T7, T8, T9, T10: -NPN-TO126V; TO126V
U$1: 5530843; 5530843-6-BOARDFINGERS
USB_ID: 0Ω; 0204/7

Connections:
3.3V: 3V3_ONLY.1.1 (1), 3V3_ONLY.1.2 (1), C1.1, C2.1, C3.1, C4.1, C5.1, C7.1, C10.1, D+PULL.2, D-PULL.2, DEPTH_SENSOR.P$1 (1), DS_R1.P$2 (2), DS_R2.P$2 (2), IC1.13 (VDDA), IC1.19 (VDD(1)), IC1.32 (VDD(2)), IC1.48 (VDD(3)), IC1.64 (VDD(4)), J4.1, J4.2, J5.4 (VCC), P1.1, P1.2, P1.3, P1.4, U$1.3.3VP1 (3.3V_1), U$1.3.3VP2 (3.3V_2), U$1.3.3VP3 (3.3V_3), U$1.3.3V_4, U$1.3.3V_5, U$1.3.3V_6
5V: Q1.3 (OUT), RO1B.2, RO1C.2, RO2B.2, RO2C.2, RO3B.2, RO3C.2, RO4B.2, RO4C.2, RO5B.2, RO5C.2, RO6B.2, RO6C.2, RO7B.2, RO7C.2, RO8B.2, RO8C.2, RO9B.2, RO9C.2, RO10B.2, RO10C.2
18V: Q1.1 (IN), U$1.EXTRA23
CANH: U$1.CAN_H
D+CON: D+PULL.1, D+SERIES.2, J1.D+
D-CON: D-PULL.1, D-SERIES.2, J1.D-
DEPTHSCL: DEPTH_SENSOR.P$2 (2), DS_R2.P$1 (1), IC1.58 (PB6)
DEPTHSDA: DEPTH_SENSOR.P$3 (3), DS_R1.P$1 (1), IC1.59 (PB7)
GATE1: RO1A.1, T1.3 (B)
GATE2: RO2A.1, T2.3 (B)
GATE3: RO3A.1, T3.3 (B)
GATE4: RO4A.1, T4.3 (B)
GATE5: RO5A.1, T5.3 (B)
GATE6: RO6A.1, T6.3 (B)
GATE7: RO7A.1, T7.3 (B)
GATE8: RO8A.1, T8.3 (B)
GATE9: RO9A.1, T9.3 (B)
GATE10: RO10A.1, T10.3 (B)
GND: 3V3_ONLY.2, 3V3_ONLY.3, C1.2, C2.2, C3.2, C4.2, C5.2, C7.2, C8.1, C9.1, C10.2, C11.1, C12.2, DEPTH_SENSOR.P$4 (4), HBL1.P$2 (2), HBL2.P$2 (2), IC1.12 (VSSA), IC1.18 (VSS(1)), IC1.63 (VSS(2)), J1.GND, J1.S1 (SHIELD), J1.S2 (SHIELD), J1.S3 (SHIELD), J1.S4 (SHIELD), J4.4, J4.6, J4.8, J4.10, J4.12, J4.14, J4.16, J4.18, J4.20, J5.6 (GND), J5.S3 (SHIELD), J5.S4 (SHIELD), OI1.2 (C), OI2.2 (C), OI3.2 (C), OI4.2 (C), OI5.2 (C), OI6.2 (C), OI7.2 (C), OI8.2 (C), OI9.2 (C), OI10.2 (C), RESET.2 (S1), U$1.GND1 (GND_1), U$1.GND2 (GND_2), U$1.GND3 (GND_3), U$1.GND_4, U$1.GND_5, U$1.GND_6
GNDBAT: ESC1.3, ESC2.3, ESC3.3, ESC4.3, ESC5.3, ESC6.3, ESC7.3, ESC8.3, ESC9.3, ESC10.3, OI1.4 (EMIT), OI2.4 (EMIT), OI3.4 (EMIT), OI4.4 (EMIT), OI5.4 (EMIT), OI6.4 (EMIT), OI7.4 (EMIT), OI8.4 (EMIT), OI9.4 (EMIT), OI10.4 (EMIT), Q1.2 (GND), T1.1 (E), T2.1 (E), T3.1 (E), T4.1 (E), T5.1 (E), T6.1 (E), T7.1 (E), T8.1 (E), T9.1 (E), T10.1 (E), U$1.EXTRA24
HEARTBEAT_1: IC1.37 (PC6), RHB1.P$1 (1)
HEARTBEAT_2: IC1.38 (PC7), RHB2.P$1 (1)
HEAVE_PORT_AFT: IC1.27 (PB1), ORIN8.P$1 (1)
HEAVE_PORT_FWD: IC1.26 (PB0), ORIN7.P$1 (1)
HEAVE_STBD_AFT: IC1.23 (PA7), ORIN6.P$1 (1)
HEAVE_STBD_FWD: IC1.22 (PA6), ORIN5.P$1 (1)
JTAG15: IC1.7 (NRST), J4.15, RESET.3, RESET.4 (P1)
KILLSWITCH: IC1.4 (PC15), U$1.KILL_SWITCH
MISSION_START: IC1.8 (PC0), P1.8
unnamed: HBL1.P$1 (1), RHB1.P$2 (2)
unnamed: HBL2.P$1 (1), RHB2.P$2 (2)
OTG_ID: IC1.33 (PB12), USB_ID.1
OTG_ID_CON: J1.ID, USB_ID.2
POWER2O1: OI1.3 (COL), RO1A.2, RO1B.1
POWER2O2: OI2.3 (COL), RO2A.2, RO2B.1
POWER2O3: OI3.3 (COL), RO3A.2, RO3B.1
POWER2O4: OI4.3 (COL), RO4A.2, RO4B.1
POWER2O5: OI5.3 (COL), RO5A.2, RO5B.1
POWER2O6: OI6.3 (COL), RO6A.2, RO6B.1
POWER2O9: OI9.3 (COL), RO9A.2, RO9B.1
POWER2O10: OI10.3 (COL), RO10A.2, RO10B.1
POWER207: OI7.3 (COL), RO7A.2, RO7B.1
POWER208: OI8.3 (COL), RO8A.2, RO8B.1
PWM1: OI1.1 (A), ORIN1.P$2 (2)
PWM2: OI2.1 (A), ORIN2.P$2 (2)
PWM3: OI3.1 (A), ORIN3.P$2 (2)
PWM4: OI4.1 (A), ORIN4.P$2 (2)
PWM5: OI5.1 (A), ORIN5.P$2 (2)
PWM6: OI6.1 (A), ORIN6.P$2 (2)
PWM7: OI7.1 (A), ORIN7.P$2 (2)
PWM8: OI8.1 (A), ORIN8.P$2 (2)
PWM9: OI9.1 (A), ORIN9.P$2 (2)
PWM10: OI10.1 (A), ORIN10.P$2 (2)
RCC_OSC_IN: C8.2, IC1.5 (PH0), OSCILLATOR.2
RCC_OSC_OUT: C9.2, IC1.6 (PH1), OSCILLATOR.1
SCL_BKPLN: IC1.41 (PA8), U$1.SCL_SENSOR
SDA_BKPLN: IC1.40 (PC9), U$1.SDA_SENSOR
SDIO_CK: IC1.53 (PC12), J5.5 (CLK(SCK))
SDIO_CMD: IC1.54 (PD2), J5.3 (CMD(DI))
SDIO_DO: IC1.39 (PC8), J5.7 (DAT0(DO))
SOURCE1: ESC1.1, RO1C.1, T1.2 (C)
SOURCE2: ESC2.1, RO2C.1, T2.2 (C)
SOURCE3: ESC3.1, RO3C.1, T3.2 (C)
SOURCE4: ESC4.1, RO4C.1, T4.2 (C)
SOURCE5: ESC5.1, RO5C.1, T5.2 (C)
SOURCE6: ESC6.1, RO6C.1, T6.2 (C)
SOURCE7: ESC7.1, RO7C.1, T7.2 (C)
SOURCE8: ESC8.1, RO8C.1, T8.2 (C)
SOURCE9: ESC9.1, RO9C.1, T9.2 (C)
SOURCE10: ESC10.1, RO10C.1, T10.2 (C)
SURGEPORTHI: IC1.16 (PA2), ORIN3.P$1 (1)
SURGEPORTLOW: IC1.17 (PA3), ORIN4.P$1 (1)
SURGESTBDHI: IC1.14 (PA0_WKUP), ORIN1.P$1 (1)
SURGESTBDLOW: IC1.15 (PA1), ORIN2.P$1 (1)
SWITCH_3: IC1.9 (PC1), P1.7
SWITCH_4: IC1.10 (PC2), P1.6
SWITCH_5: IC1.11 (PC3), P1.5
SW_AFT: IC1.29 (PB10), ORIN9.P$1 (1)
SW_FWD: IC1.30 (PB11), ORIN10.P$1 (1)
SYS_JTCK-SWCLK: IC1.49 (PA14), J4.9
SYS_JTDI: IC1.46 (PA13), J4.7
SYS_JTDO-SWO: IC1.55 (PB3), J4.13
SYS_JTMS-SWIDIO: IC1.50 (PA15), J4.5
SYS_JTRST: IC1.56 (PB4), J4.3
USB_OTG_HS_DM: D-SERIES.1, IC1.35 (PB14)
USB_OTG_HS_DP: D+SERIES.1, IC1.36 (PB15)
VBUS: J1.VBUS
VCAP: C11.2, IC1.47 (VCAP_2)
VCAP2: C12.1, IC1.31 (VCAP_1)

Notes on the sheet:
5 v
18 - 22 V
18 v
gndbat

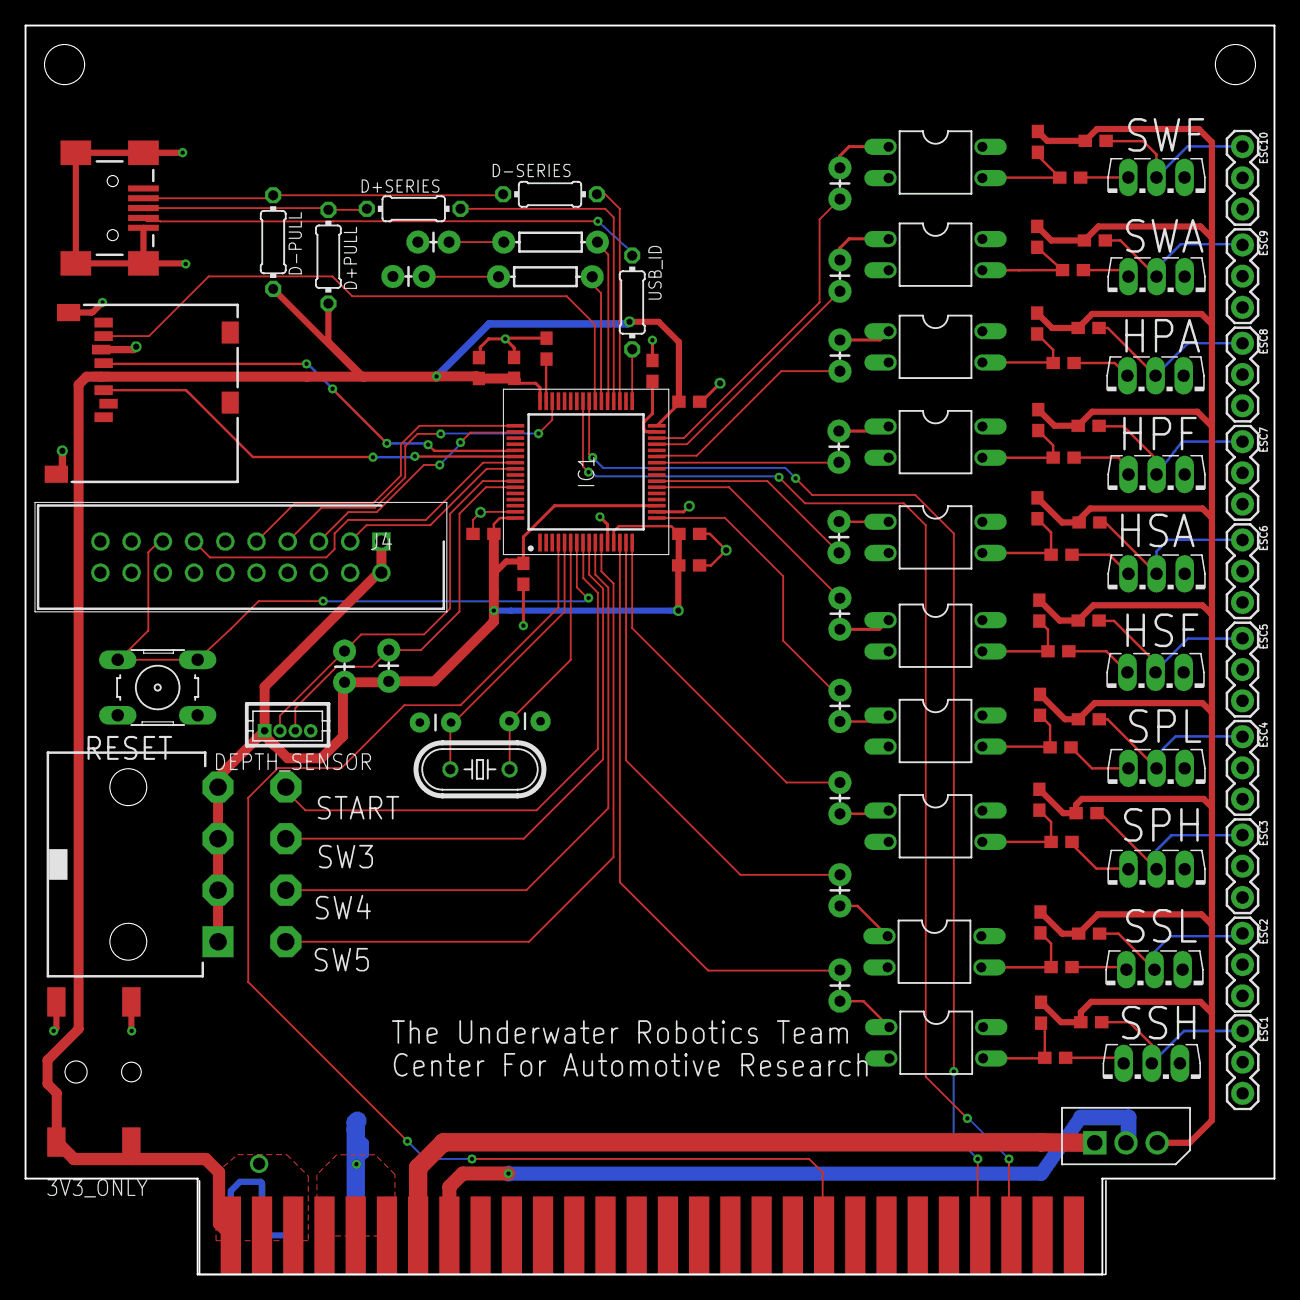
[picture p33: board Coprocessor_Board.brd from above]

Board: 2 copper layers, 101.6 x 101.6 mm, 103 parts (0 on the bottom side), 87 nets.
