osu-uwrt/hardware_boards/coProcessor/Coprocessor_Board_Rev2.brd

## EAGLE design coProcessor/OldRevs/Coprocessor_Board_Rev2.brd (2018-02-09, an earlier design)

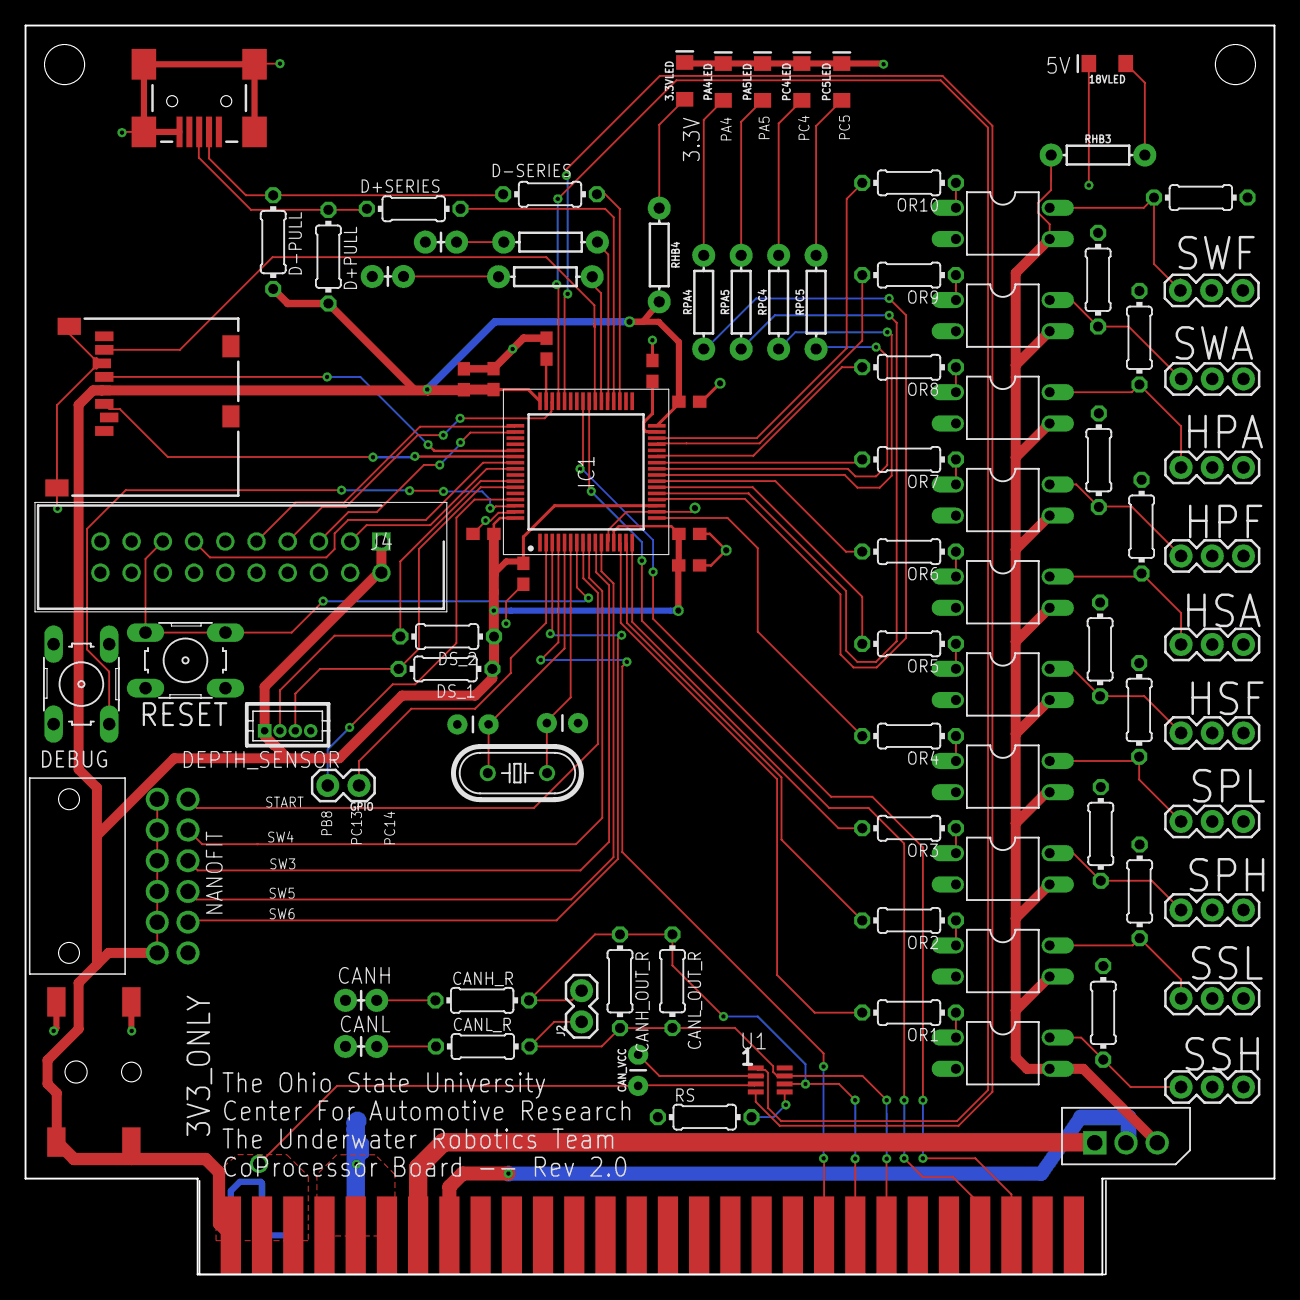
[picture p34: board Coprocessor_Board_Rev2.brd from above]

Board: 2 copper layers, 101.6 x 101.6 mm, 96 parts (0 on the bottom side), 86 nets.

Parts:
3.3VLED, 18VLED: WHITE; LED-1206
3V3_ONLY: PJ-002AH-SMT-TR; CUI_PJ-002AH-SMT-TR
C1: 4.7 uF; 0603
C2, C3, C4, C5, C10: .1 uF; 0603
C7: 1 uF; 0603
C8, C9: 1 nF; CAP-PTH-2.54
C11: 2.2uF; 0603
C12: 2.2 uF; 0603
CANH_LED: LED; AXIAL-0.1
CANH_OUT_R: 120; 0204/7
CANH_R: 330; 0204/7
CANL_LED: LED; AXIAL-0.1
CANL_OUT_R: 120; 0204/7
CANL_R: 330; 0204/7
CAN_VCC: .1 uF; CAP-PTH-2.54
D+PULL: 1.5k; 0204/7
D+SERIES: 22Ω; 0204/7
D-PULL: 1.5k; 0204/7
D-SERIES: 22Ω; 0204/7
DEBUG: B3F-10XX
DEPTH_SENSOR: DF13-4P-1.25DSA
DS_1, DS_2: 4.7k; 0204/7
ESC1, ESC2, ESC3, ESC4, ESC5, ESC6, ESC7, ESC8, ESC9, ESC10: 1X03
GPIO: 1X02
HBL1, HBL2: LED; AXIAL-0.1
IC1: STM32F405RGT6; QFP50P1200X1200X160-64N
J1: USB_MINI-B_SMT; USB-MINIB
J2: 1X02
J4: 30320-6002HB; SHDR20W81P254_2X10_3300X840X93
J5: 5008730806
OI1, OI2, OI3, OI4, OI5, OI6, OI7, OI8, OI9, OI10: SFH610; DIL04
OR1, OR2, OR3, OR4, OR5, OR6, OR7, OR8, OR9, OR10: 220; 0204/7
OSCILLATOR: HC49/S
PA4LED, PA5LED: WHITE; LED-1206
PC4LED, PC5LED: WHITE; LED-1206
Q1: L78M05CV; TO254P450X1020X1935-3P
RESET: B3F-10XX
RHB1, RHB2: 1k; AXIAL-0.3
RHB3: 1.8k; AXIAL-0.3
RHB4: 330; AXIAL-0.3
RO1, RO2, RO3, RO4, RO5, RO6, RO7, RO8, RO9, RO10: 10k; 0204/7
RPA4, RPA5: 330; AXIAL-0.3
RPC4, RPC5: 330; AXIAL-0.3
RS: 0; 0204/7
U1: MAX3051ESA; 8-SOICN
U$1: 5530843; 5530843-6-BOARDFINGERS
U$2: 105314-2112

Connections:
3.3V: 3V3_ONLY.1.1, 3V3_ONLY.1.2, C1.1, C2.1, C3.1, C4.1, C5.1, C7.1, C10.1, CAN_VCC.1, D+PULL.2, D-PULL.2, DEPTH_SENSOR.P$1, DS_1.1, DS_2.1, IC1.13, IC1.19, IC1.32, IC1.48, IC1.64, J4.1, J4.2, J5.4, RHB4.P$2, U1.3, U$1.3.3VP1, U$1.3.3VP2, U$1.3.3VP3, U$1.3.3V_4, U$1.3.3V_5, U$1.3.3V_6, U$2.CK7, U$2.CK8, U$2.CK9, U$2.CK10, U$2.CK11, U$2.CK12
5V: OI1.3, OI2.3, OI3.3, OI4.3, OI5.3, OI6.3, OI7.3, OI8.3, OI9.3, OI10.3, Q1.3, RHB3.P$1
18V: Q1.1, U$1.EXTRA23
CAN1_RXD: IC1.44, U1.4
CAN1_TXD: IC1.45, U1.1
CANH: CANH_OUT_R.1, CANH_R.2, CANL_OUT_R.1, J2.2, U1.7, U$1.CAN_H
CANL: CANH_OUT_R.2, CANL_OUT_R.2, CANL_R.2, J2.1, U1.6, U$1.CAN_L
D+CON: D+PULL.1, D+SERIES.2, J1.D+
D-CON: D-PULL.1, D-SERIES.2, J1.D-
DEPTHSCL: DEPTH_SENSOR.P$2, DS_2.2, IC1.58
DEPTHSDA: DEPTH_SENSOR.P$3, DS_1.2, IC1.59
GND: 3.3VLED.C, 3V3_ONLY.2, 3V3_ONLY.3, C1.2, C2.2, C3.2, C4.2, C5.2, C7.2, C8.1, C9.1, C10.2, C11.1, C12.2, CANH_LED.P$2, CANL_LED.P$1, CAN_VCC.2, DEBUG.3, DEBUG.4, DEPTH_SENSOR.P$4, HBL1.P$2, HBL2.P$2, IC1.12, IC1.18, IC1.63, J1.GND, J1.S1, J1.S2, J1.S3, J1.S4, J4.4, J4.6, J4.8, J4.10, J4.12, J4.14, J4.16, J4.18, J4.20, J5.6, J5.S3, J5.S4, OI1.2, OI2.2, OI3.2, OI4.2, OI5.2, OI6.2, OI7.2, OI8.2, OI9.2, OI10.2, PA4LED.C, PA5LED.C, PC4LED.C, PC5LED.C, RESET.2, RS.1, U1.2, U$1.GND1, U$1.GND2, U$1.GND3, U$1.GND_4, U$1.GND_5, U$1.GND_6
GNDBAT: 18VLED.C, ESC1.3, ESC2.3, ESC3.3, ESC4.3, ESC5.3, ESC6.3, ESC7.3, ESC8.3, ESC9.3, ESC10.3, Q1.2, RO1.1, RO2.1, RO3.1, RO4.1, RO5.1, RO6.1, RO7.1, RO8.1, RO9.1, RO10.1, U$1.EXTRA24
HEARTBEAT_1: IC1.37, RHB1.P$1
HEARTBEAT_2: IC1.38, RHB2.P$1
HEARTBEAT_3: IC1.20, RPA4.P$1
HEARTBEAT_4: IC1.21, RPA5.P$1
HEAVE_PORT_AFT: IC1.27, OR8.2
HEAVE_PORT_FWD: IC1.26, OR7.2
HEAVE_STBD_AFT: IC1.23, OR6.2
HEAVE_STBD_FWD: IC1.22, OR5.2
JTAG15: IC1.7, J4.15, RESET.3, RESET.4
KILLSWITCH: IC1.4, U$1.KILL_SWITCH
MISSION_START: IC1.8, U$2.CK6
unnamed: HBL1.P$1, RHB1.P$2
unnamed: RS.2, U1.8
unnamed: 18VLED.A, RHB3.P$2
unnamed: 3.3VLED.A, RHB4.P$1
unnamed: CANH_LED.P$1, CANH_R.1
unnamed: CANL_LED.P$2, CANL_R.1
unnamed: PA4LED.A, RPA4.P$2
unnamed: PA5LED.A, RPA5.P$2
unnamed: PC4LED.A, RPC4.P$2
unnamed: PC5LED.A, RPC5.P$2
unnamed: HBL2.P$1, RHB2.P$2
PB8: GPIO.2, IC1.61
PB9: DEBUG.2, IC1.62
PC4: IC1.24, RPC4.P$1
PC5: IC1.25, RPC5.P$1
PC13: GPIO.1, IC1.2
PWM1: OI1.1, OR1.1
PWM2: OI2.1, OR2.1
PWM3: OI3.1, OR3.1
PWM4: OI4.1, OR4.1
PWM5: OI5.1, OR5.1
PWM5V1: ESC1.1, OI1.4, RO1.2
PWM5V2: ESC2.1, OI2.4, RO2.2
PWM5V3: ESC3.1, OI3.4, RO3.2
PWM5V4: ESC4.1, OI4.4, RO4.2
PWM5V5: ESC5.1, OI5.4, RO5.2
PWM5V6: ESC6.1, OI6.4, RO6.2
PWM5V7: ESC7.1, OI7.4, RO7.2
PWM5V8: ESC8.1, OI8.4, RO8.2
PWM5V9: ESC9.1, OI9.4, RO9.2
PWM5V10: ESC10.1, OI10.4, RO10.2
PWM6: OI6.1, OR6.1
PWM7: OI7.1, OR7.1
PWM8: OI8.1, OR8.1
PWM9: OI9.1, OR9.1
PWM10: OI10.1, OR10.1
RCC_OSC_IN: C8.2, IC1.5, OSCILLATOR.2
RCC_OSC_OUT: C9.2, IC1.6, OSCILLATOR.1
SCL_BKPLN: IC1.41, U$1.SCL_SENSOR
SDA_BKPLN: IC1.40, U$1.SDA_SENSOR
SDIO_CK: IC1.53, J5.5
SDIO_CMD: IC1.54, J5.3
SDIO_DO: IC1.39, J5.7
SURGEPORTHI: IC1.16, OR3.2
SURGEPORTLOW: IC1.17, OR4.2
SURGESTBDHI: IC1.14, OR1.2
SURGESTBDLOW: IC1.15, OR2.2
SWITCH6: IC1.3, U$2.CK2
SWITCH_3: IC1.9, U$2.CK5
SWITCH_4: IC1.10, U$2.CK4
SWITCH_5: IC1.11, U$2.CK3
SW_AFT: IC1.29, OR9.2
SW_FWD: IC1.30, OR10.2
SYS_JTCK-SWCLK: IC1.49, J4.9
SYS_JTDI: IC1.46, J4.7
SYS_JTDO-SWO: IC1.55, J4.13
SYS_JTMS-SWIDIO: IC1.50, J4.5
SYS_JTRST: IC1.56, J4.3
USB_OTG_HS_DM: D-SERIES.1, IC1.35
USB_OTG_HS_DP: D+SERIES.1, IC1.36
VCAP: C11.2, IC1.47
VCAP2: C12.1, IC1.31
