osu-uwrt/hardware_boards/Status Board/Old Revs/Status Board 0.2.brd

## EAGLE design Status Board/Old Revs/Status Board 0.2.brd (2018-02-19, an earlier design)

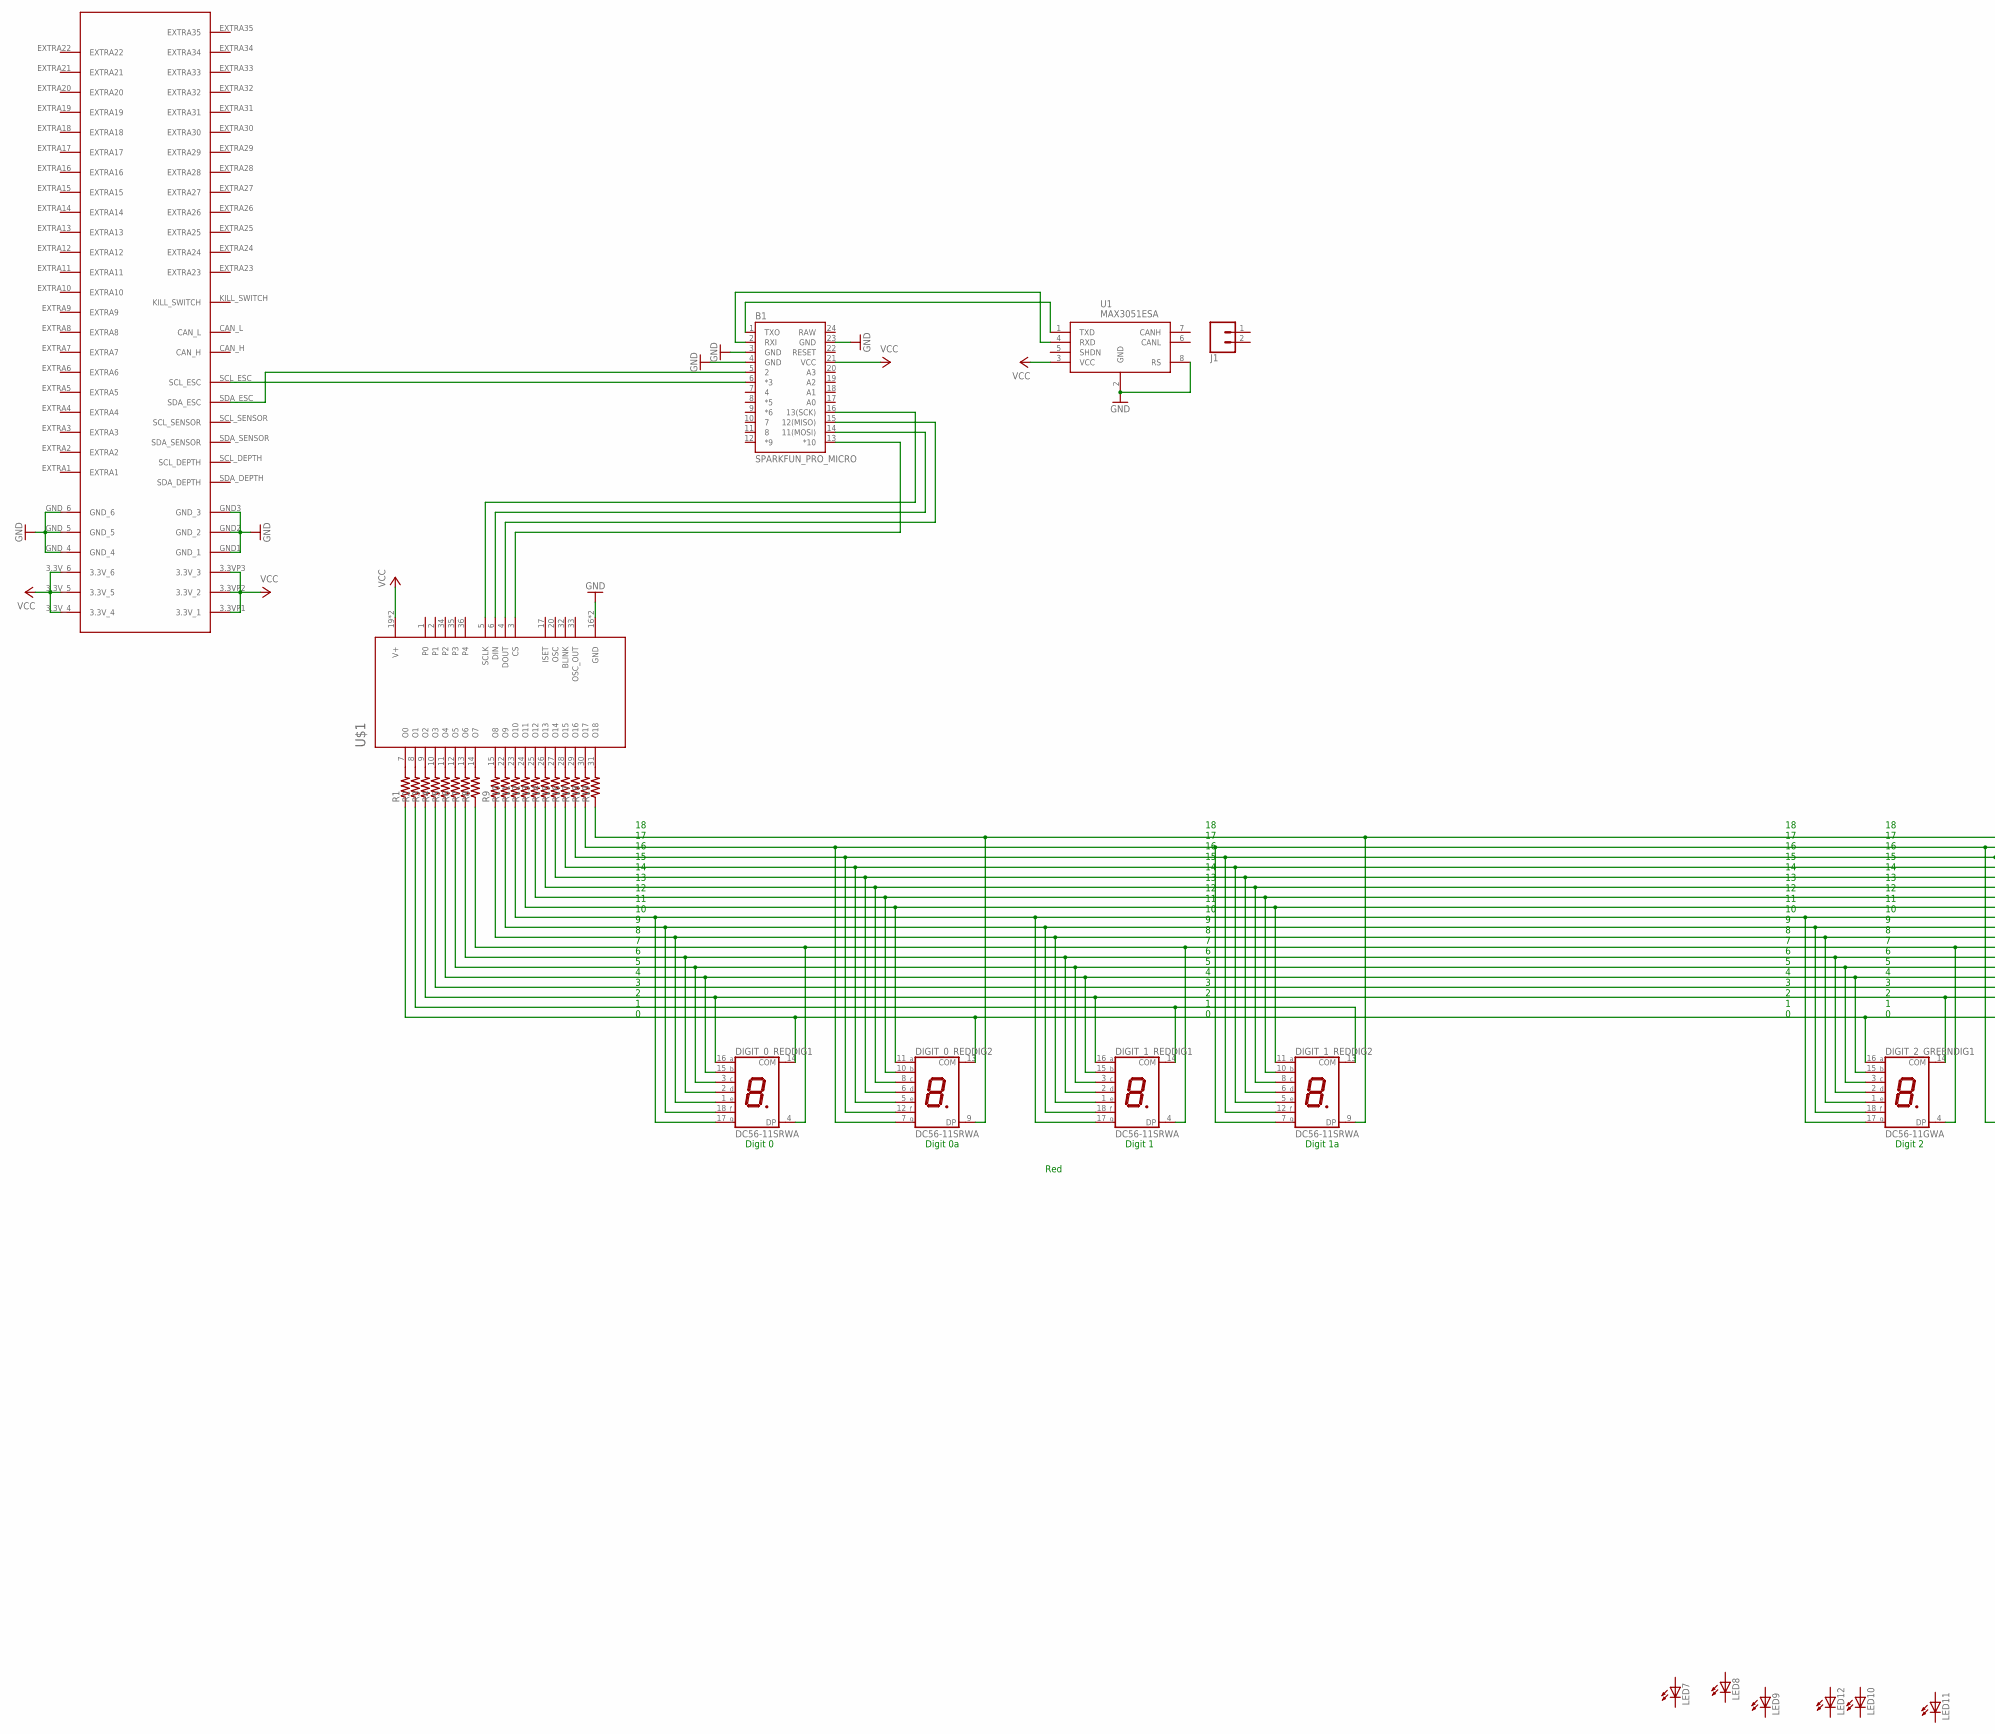
[picture p35: schematic Status Board 0.2.sch, part in row 1, column 1]

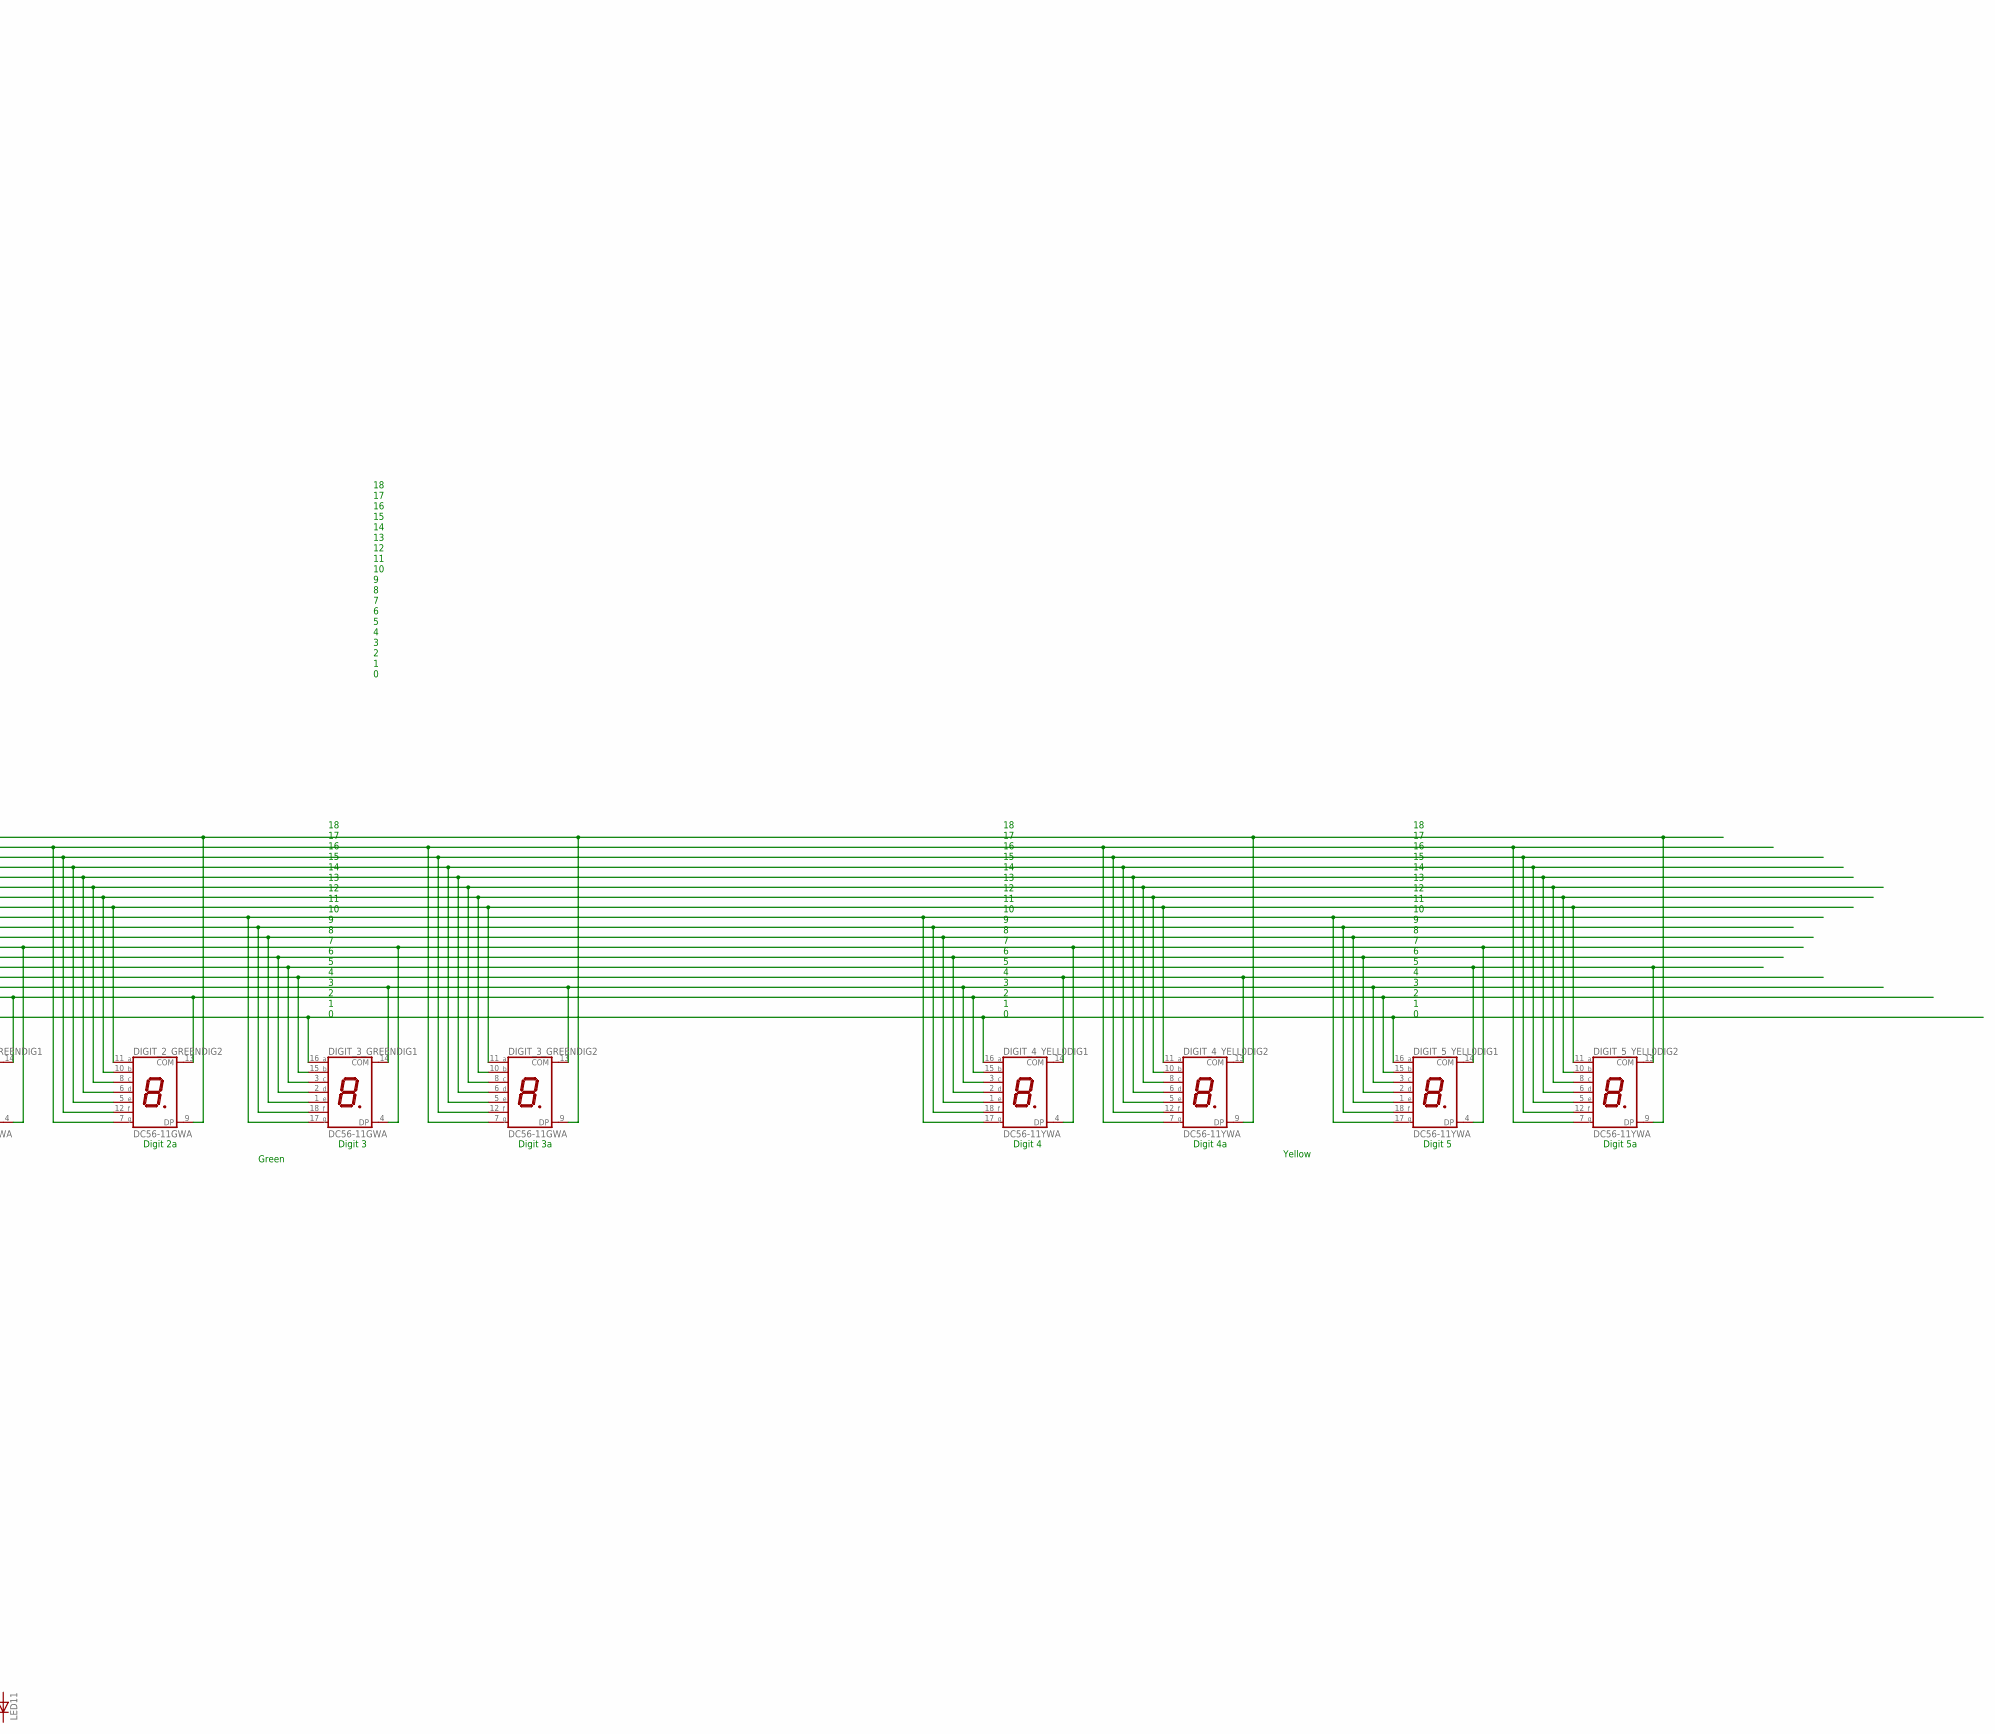
[picture p36: schematic Status Board 0.2.sch, part in row 1, column 2]

Parts:
B1: SPARKFUN_PRO_MICRO
DIGIT_0_RED, DIGIT_1_RED: DC56-11SRWA; DA56
DIGIT_2_GREEN, DIGIT_3_GREEN: DC56-11GWA; DA56
DIGIT_4_YELL0, DIGIT_5_YELL0: DC56-11YWA; DA56
J1: CONN_02; 1X02
LED7, LED8, LED9, LED10, LED11, LED12: LED3MM
R1, R2, R3, R4, R5, R6, R7, R8, R9, R10, R11, R12, R13, R14, R15, R16, R17, R18, R19: R-US_0207/12; 0207/12
U1: MAX3051ESA; 8-SOICN
U$1: MAX6954; SSOP36
U$2: 5530843; 5530843-6-BOARDFINGERS

Connections:
GND: B1.3 (GND), B1.4 (GND), B1.23 (GND), U1.2 (GND), U1.8 (RS), U$1.16 (GND), U$1.18 (GND), U$2.GND1 (GND_1), U$2.GND2 (GND_2), U$2.GND3 (GND_3), U$2.GND_4, U$2.GND_5, U$2.GND_6
unnamed: R2.2, U$1.8 (O1)
unnamed: R3.2, U$1.9 (O2)
unnamed: R4.2, U$1.10 (O3)
unnamed: R5.2, U$1.11 (O4)
unnamed: R6.2, U$1.12 (O5)
unnamed: R7.2, U$1.13 (O6)
unnamed: R8.2, U$1.14 (O7)
unnamed: R9.2, U$1.15 (O8)
unnamed: R10.2, U$1.22 (O9)
unnamed: R11.2, U$1.23 (O10)
unnamed: R12.2, U$1.24 (O11)
unnamed: R13.2, U$1.25 (O12)
unnamed: R14.2, U$1.26 (O13)
unnamed: R15.2, U$1.27 (O14)
unnamed: R16.2, U$1.28 (O15)
unnamed: R17.2, U$1.29 (O16)
unnamed: R18.2, U$1.30 (O17)
unnamed: R19.2, U$1.31 (O18)
unnamed: R1.2, U$1.7 (O0)
unnamed: DIGIT_0_RED.13 (COM), DIGIT_0_RED.14 (COM), DIGIT_2_GREEN.16 (A), DIGIT_3_GREEN.16 (A), DIGIT_4_YELL0.16 (A), DIGIT_5_YELL0.16 (A), R1.1
unnamed: DIGIT_1_RED.13 (COM), DIGIT_1_RED.14 (COM), R2.1
unnamed: DIGIT_0_RED.16 (A), DIGIT_1_RED.16 (A), DIGIT_2_GREEN.13 (COM), DIGIT_2_GREEN.14 (COM), DIGIT_4_YELL0.15 (B), DIGIT_5_YELL0.15 (B), R3.1
unnamed: DIGIT_3_GREEN.13 (COM), DIGIT_3_GREEN.14 (COM), DIGIT_4_YELL0.3 (C), DIGIT_5_YELL0.3 (C), R4.1
unnamed: B1.14 (11(MOSI)), U$1.6 (DIN)
unnamed: B1.15 (12(MISO)), U$1.4 (DOUT)
unnamed: DIGIT_0_RED.15 (B), DIGIT_1_RED.15 (B), DIGIT_2_GREEN.15 (B), DIGIT_3_GREEN.15 (B), DIGIT_4_YELL0.13 (COM), DIGIT_4_YELL0.14 (COM), R5.1
unnamed: DIGIT_0_RED.3 (C), DIGIT_1_RED.3 (C), DIGIT_2_GREEN.3 (C), DIGIT_3_GREEN.3 (C), DIGIT_5_YELL0.13 (COM), DIGIT_5_YELL0.14 (COM), R6.1
unnamed: DIGIT_0_RED.1 (E), DIGIT_1_RED.1 (E), DIGIT_2_GREEN.1 (E), DIGIT_3_GREEN.1 (E), DIGIT_4_YELL0.1 (E), DIGIT_5_YELL0.1 (E), R9.1
unnamed: DIGIT_0_RED.18 (F), DIGIT_1_RED.18 (F), DIGIT_2_GREEN.18 (F), DIGIT_3_GREEN.18 (F), DIGIT_4_YELL0.18 (F), DIGIT_5_YELL0.18 (F), R10.1
unnamed: DIGIT_0_RED.17 (G), DIGIT_1_RED.17 (G), DIGIT_2_GREEN.17 (G), DIGIT_3_GREEN.17 (G), DIGIT_4_YELL0.17 (G), DIGIT_5_YELL0.17 (G), R11.1
unnamed: DIGIT_0_RED.11 (A), DIGIT_1_RED.11 (A), DIGIT_2_GREEN.11 (A), DIGIT_3_GREEN.11 (A), DIGIT_4_YELL0.11 (A), DIGIT_5_YELL0.11 (A), R12.1
unnamed: DIGIT_0_RED.10 (B), DIGIT_1_RED.10 (B), DIGIT_2_GREEN.10 (B), DIGIT_3_GREEN.10 (B), DIGIT_4_YELL0.10 (B), DIGIT_5_YELL0.10 (B), R13.1
unnamed: DIGIT_0_RED.2 (D), DIGIT_1_RED.2 (D), DIGIT_2_GREEN.2 (D), DIGIT_3_GREEN.2 (D), DIGIT_4_YELL0.2 (D), DIGIT_5_YELL0.2 (D), R7.1
unnamed: DIGIT_0_RED.6 (D), DIGIT_1_RED.6 (D), DIGIT_2_GREEN.6 (D), DIGIT_3_GREEN.6 (D), DIGIT_4_YELL0.6 (D), DIGIT_5_YELL0.6 (D), R15.1
unnamed: DIGIT_0_RED.5 (E), DIGIT_1_RED.5 (E), DIGIT_2_GREEN.5 (E), DIGIT_3_GREEN.5 (E), DIGIT_4_YELL0.5 (E), DIGIT_5_YELL0.5 (E), R16.1
unnamed: DIGIT_0_RED.12 (F), DIGIT_1_RED.12 (F), DIGIT_2_GREEN.12 (F), DIGIT_3_GREEN.12 (F), DIGIT_4_YELL0.12 (F), DIGIT_5_YELL0.12 (F), R17.1
unnamed: DIGIT_0_RED.7 (G), DIGIT_1_RED.7 (G), DIGIT_2_GREEN.7 (G), DIGIT_3_GREEN.7 (G), DIGIT_4_YELL0.7 (G), DIGIT_5_YELL0.7 (G), R18.1
unnamed: DIGIT_0_RED.9 (DP), DIGIT_1_RED.9 (DP), DIGIT_2_GREEN.9 (DP), DIGIT_3_GREEN.9 (DP), DIGIT_4_YELL0.9 (DP), DIGIT_5_YELL0.9 (DP), R19.1
unnamed: B1.16 (13(SCK)), U$1.5 (SCLK)
unnamed: DIGIT_0_RED.8 (C), DIGIT_1_RED.8 (C), DIGIT_2_GREEN.8 (C), DIGIT_3_GREEN.8 (C), DIGIT_4_YELL0.8 (C), DIGIT_5_YELL0.8 (C), R14.1
unnamed: B1.13 (*10), U$1.3 (CS)
unnamed: B1.6 (*3), U$2.SCL_ESC
unnamed: B1.5 (2), U$2.SDA_ESC
unnamed: B1.1 (TXO), U1.1 (TXD)
unnamed: B1.2 (RXI), U1.4 (RXD)
unnamed: DIGIT_0_RED.4 (DP), DIGIT_1_RED.4 (DP), DIGIT_2_GREEN.4 (DP), DIGIT_3_GREEN.4 (DP), DIGIT_4_YELL0.4 (DP), DIGIT_5_YELL0.4 (DP), R8.1
RAW: B1.24 (RAW)
VCC: B1.21 (VCC), U1.3 (VCC), U$1.19 (V+), U$1.21 (V+), U$2.3.3VP1 (3.3V_1), U$2.3.3VP2 (3.3V_2), U$2.3.3VP3 (3.3V_3), U$2.3.3V_4, U$2.3.3V_5, U$2.3.3V_6

Notes on the sheet:
Green
Red
Yellow
Digit 0
Digit 0a
18 17 16 15 14 13 12 11 10 9 8 7 6 5 4 3 2 1 0
Digit 1
Digit 1a
Digit 2
Digit 2a
Digit 3
Digit 3a
Digit 4
Digit 4a
Digit 5
Digit 5a

Board: 2 copper layers, 36 parts (0 on the bottom side), 48 nets, no tracks yet.
