osu-uwrt/hardware_boards/batteryBalancer/Blaine/Rev2/batteryBalancer.brd

## EAGLE design batteryBalancer/Blaine/Rev2/batteryBalancer.brd (2018-02-09)

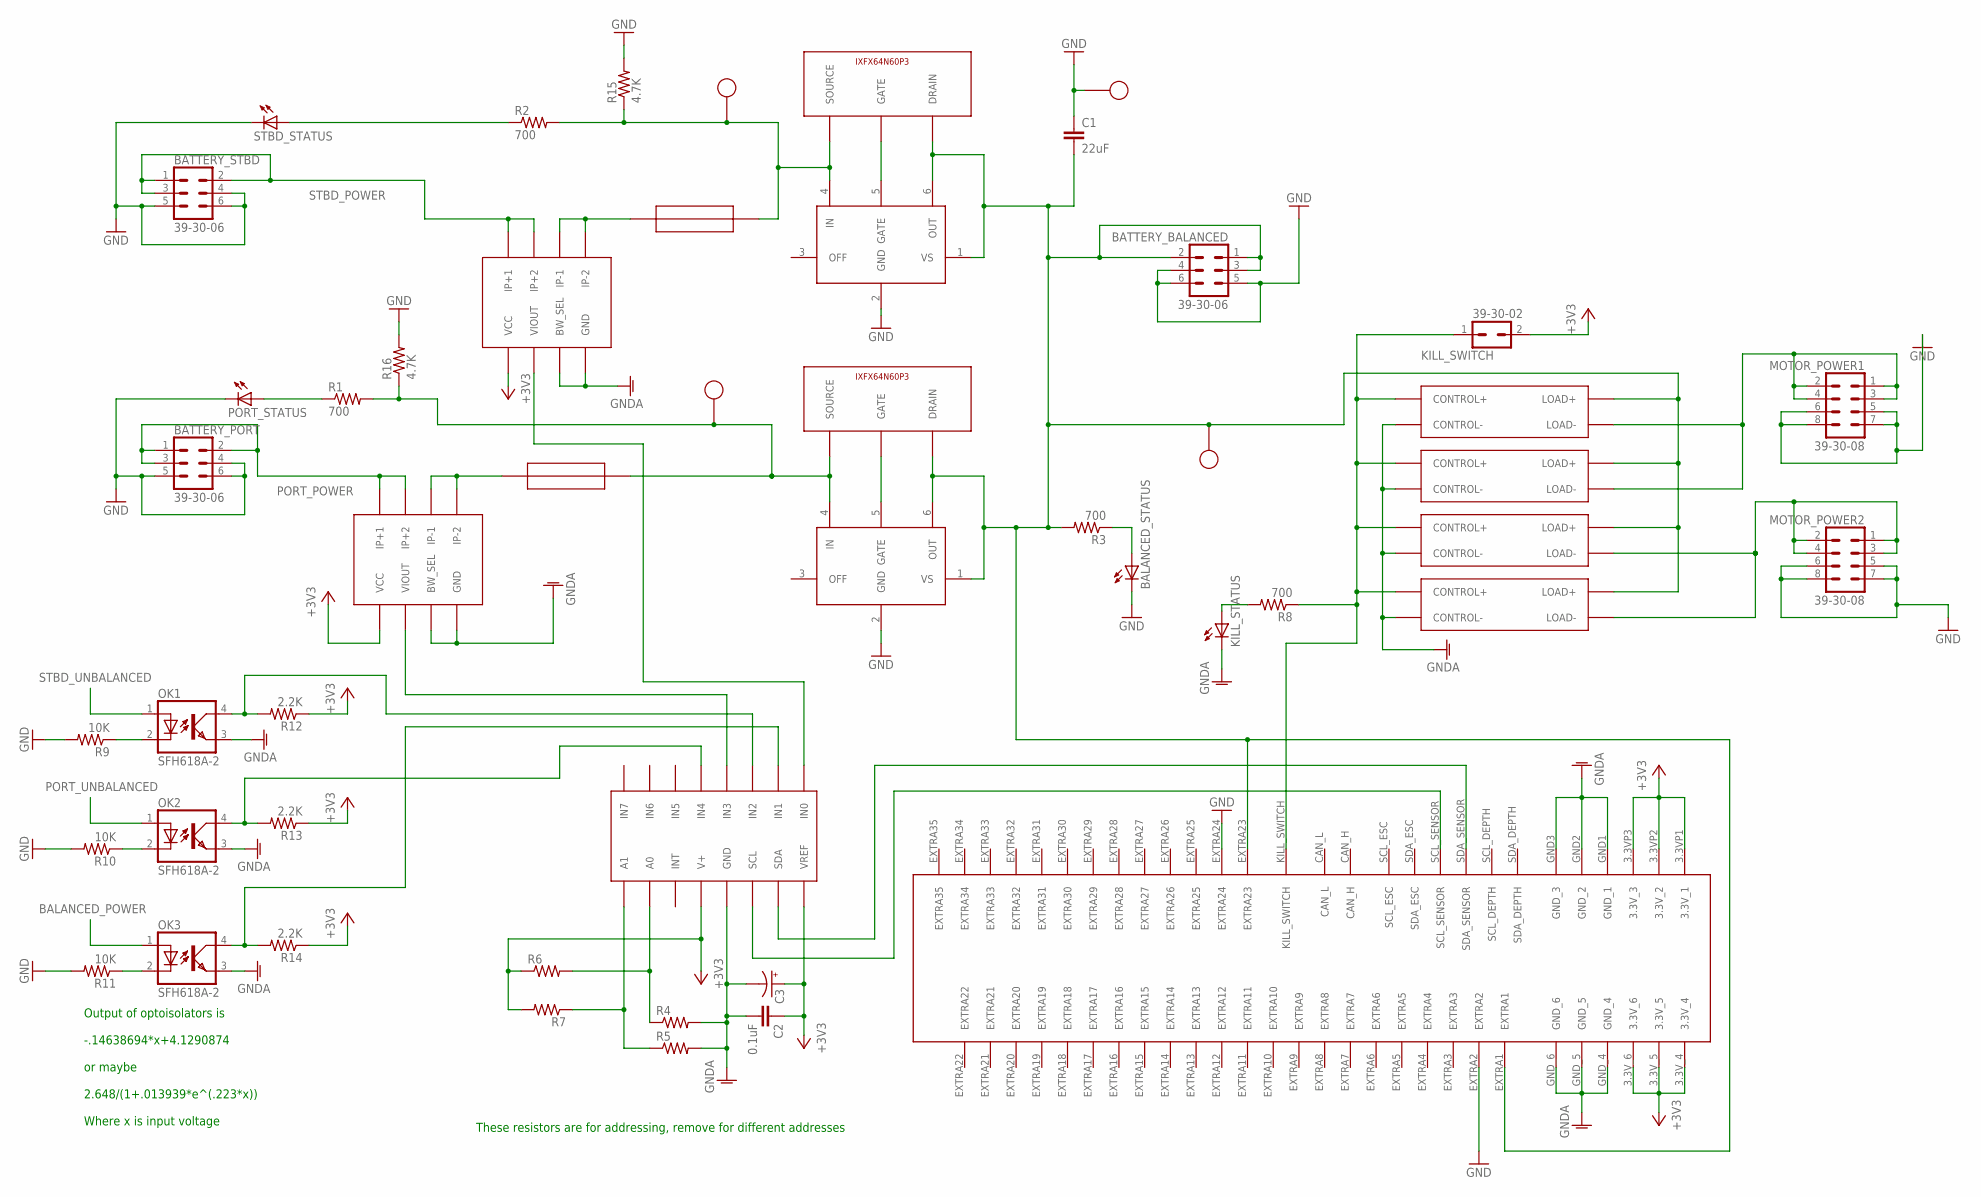
[picture p39: schematic batteryBalancer.sch]

Parts:
ADC: ADC128D818; TSSOP-16
BALANCED_STATUS: LTST-S270GKT
BATTERY_BALANCED: 39-30-06; 39-30-?06?
BATTERY_PORT: 39-30-06; 39-30-?06?
BATTERY_STBD: 39-30-06; 39-30-?06?
C1: 22uF; CAP-PTH-SMALL-KIT
C2: 0.1uF; CAP-PTH-SMALL-KIT
C3: CPOL-USE2-4; E2-4
EDGE_CONNECTOR: 5530843; 5530843-6-BOARDFINGERS
KILL_STATUS: LTST-S270GKT
KILL_SWITCH: 39-30-02; 39-30-?02?
MOTOR_POWER1, MOTOR_POWER2: 39-30-08; 39-30-?08?
OK1, OK2, OK3: SFH618A-2; DIP4
PORT_CS: ACS722; SOIC-8
PORT_FC: LM5050-1; SOT23-6
PORT_FET: IXFX64N60P3
PORT_FUSE: 01220083Z
PORT_STATUS: LTST-S270GKT
R1, R2, R3, R8: 700; 0207/7
R4, R5, R6, R7: R-US_0204/5; 0204/5
R9, R10, R11: 10K; 0207/7
R12, R13, R14: 2.2K; 0207/7
R15, R16: 4.7K; 0207/7
RELAY2, RELAY3, RELAY4: CMX60D20
RLAY1: CMX60D20
STBD_CS: ACS722; SOIC-8
STBD_FC: LM5050-1; SOT23-6
STBD_FET: IXFX64N60P3
STBD_FUSE: 01220083Z
STBD_STATUS: LTST-S270GKT
U$1, U$2, U$3, U$4: 5010_C

Connections:
3.3V: ADC.V+, ADC.VREF, C2.1, C3.+, EDGE_CONNECTOR.3.3VP1 (3.3V_1), EDGE_CONNECTOR.3.3VP2 (3.3V_2), EDGE_CONNECTOR.3.3VP3 (3.3V_3), EDGE_CONNECTOR.3.3V_4, EDGE_CONNECTOR.3.3V_5, EDGE_CONNECTOR.3.3V_6, KILL_SWITCH.2, PORT_CS.VCC, R6.1, R7.2, R12.1, R13.1, R14.1, STBD_CS.VCC
ADC_A0: ADC.A0, R4.1, R6.2
ADC_A1: ADC.A1, R5.1, R7.1
BALANCED_INDICATOR: BALANCED_STATUS.ANODE (A), R3.1
BALANCED_LOGIC: ADC.IN1, OK3.4 (COL), R14.2
BALANCED_OPTO_NEG: OK3.2 (C), R11.1
BALANCED_POWER: BATTERY_BALANCED.1, BATTERY_BALANCED.2, BATTERY_BALANCED.3, C1.2, EDGE_CONNECTOR.EXTRA1, EDGE_CONNECTOR.EXTRA23, OK3.1 (A), PORT_FC.1 (VS), PORT_FC.6 (OUT), PORT_FET.DRAIN, R3.2, RELAY2.LOAD+, RELAY3.LOAD+, RELAY4.LOAD+, RLAY1.LOAD+, STBD_FC.1 (VS), STBD_FC.6 (OUT), STBD_FET.DRAIN, U$3.P$1
GND: BALANCED_STATUS.CATHODE (C), BATTERY_BALANCED.4, BATTERY_BALANCED.5, BATTERY_BALANCED.6, BATTERY_PORT.4, BATTERY_PORT.5, BATTERY_PORT.6, BATTERY_STBD.4, BATTERY_STBD.5, BATTERY_STBD.6, C1.1, EDGE_CONNECTOR.EXTRA2, EDGE_CONNECTOR.EXTRA24, MOTOR_POWER1.5, MOTOR_POWER1.6, MOTOR_POWER1.7, MOTOR_POWER1.8, MOTOR_POWER2.5, MOTOR_POWER2.6, MOTOR_POWER2.7, MOTOR_POWER2.8, PORT_FC.2 (GND), PORT_STATUS.CATHODE (C), R9.2, R10.2, R11.2, R15.2, R16.2, STBD_FC.2 (GND), STBD_STATUS.CATHODE (C), U$4.P$1
KILL_SWITCH: EDGE_CONNECTOR.KILL_SWITCH, KILL_SWITCH.1, R8.1, RELAY2.CONTROL+, RELAY3.CONTROL+, RELAY4.CONTROL+, RLAY1.CONTROL+
LOGIC_GND: ADC.GND, C2.2, C3.-, EDGE_CONNECTOR.GND1 (GND_1), EDGE_CONNECTOR.GND2 (GND_2), EDGE_CONNECTOR.GND3 (GND_3), EDGE_CONNECTOR.GND_4, EDGE_CONNECTOR.GND_5, EDGE_CONNECTOR.GND_6, KILL_STATUS.CATHODE (C), OK1.3 (EMIT), OK2.3 (EMIT), OK3.3 (EMIT), PORT_CS.BW_SEL, PORT_CS.GND, R4.2, R5.2, RELAY2.CONTROL-, RELAY3.CONTROL-, RELAY4.CONTROL-, RLAY1.CONTROL-, STBD_CS.BW_SEL, STBD_CS.GND
MOTOR_POWER1: MOTOR_POWER1.1, MOTOR_POWER1.2, MOTOR_POWER1.3, MOTOR_POWER1.4, RELAY2.LOAD-, RLAY1.LOAD-
MOTOR_POWER2: MOTOR_POWER2.1, MOTOR_POWER2.2, MOTOR_POWER2.3, MOTOR_POWER2.4, RELAY3.LOAD-, RELAY4.LOAD-
unnamed: KILL_STATUS.ANODE (A), R8.2
PORT_CURRENT: ADC.IN3, PORT_CS.VIOUT
PORT_GATE: PORT_FC.5 (GATE), PORT_FET.GATE
PORT_LOGIC: ADC.IN4, OK2.4 (COL), R13.2
PORT_OPTO_NEG: OK2.2 (C), R10.1
PORT_POWER: BATTERY_PORT.1, BATTERY_PORT.2, BATTERY_PORT.3, PORT_CS.IP+1, PORT_CS.IP+2
PORT_STATUS: PORT_STATUS.ANODE (A), R1.1
PORT_UNBALANCED: OK2.1 (A), PORT_FC.4 (IN), PORT_FET.SOURCE, PORT_FUSE.P$3, PORT_FUSE.P$4, R1.2, R16.1, U$2.P$1
PORT_UNFUSED: PORT_CS.IP-1, PORT_CS.IP-2, PORT_FUSE.P$1, PORT_FUSE.P$2
SCL: ADC.SCL, EDGE_CONNECTOR.SCL_SENSOR
SDA: ADC.SDA, EDGE_CONNECTOR.SDA_SENSOR
STBD_CURRENT: ADC.IN0, STBD_CS.VIOUT
STBD_GATE: STBD_FC.5 (GATE), STBD_FET.GATE
STBD_LOGIC: ADC.IN2, OK1.4 (COL), R12.2
STBD_OPTO_NEG: OK1.2 (C), R9.1
STBD_POWER: BATTERY_STBD.1, BATTERY_STBD.2, BATTERY_STBD.3, STBD_CS.IP+1, STBD_CS.IP+2
STBD_STATUS: R2.1, STBD_STATUS.ANODE (A)
STBD_UNBALANCED: OK1.1 (A), R2.2, R15.1, STBD_FC.4 (IN), STBD_FET.SOURCE, STBD_FUSE.P$3, STBD_FUSE.P$4, U$1.P$1
STBD_UNFUSED: STBD_CS.IP-1, STBD_CS.IP-2, STBD_FUSE.P$1, STBD_FUSE.P$2

Notes on the sheet:
These resistors are for addressing, remove for different addresses
Output of optoisolators is -.14638694*x+4.1290874 or maybe 2.648/(1+.013939*e^(.223*x)) Where x is input voltage

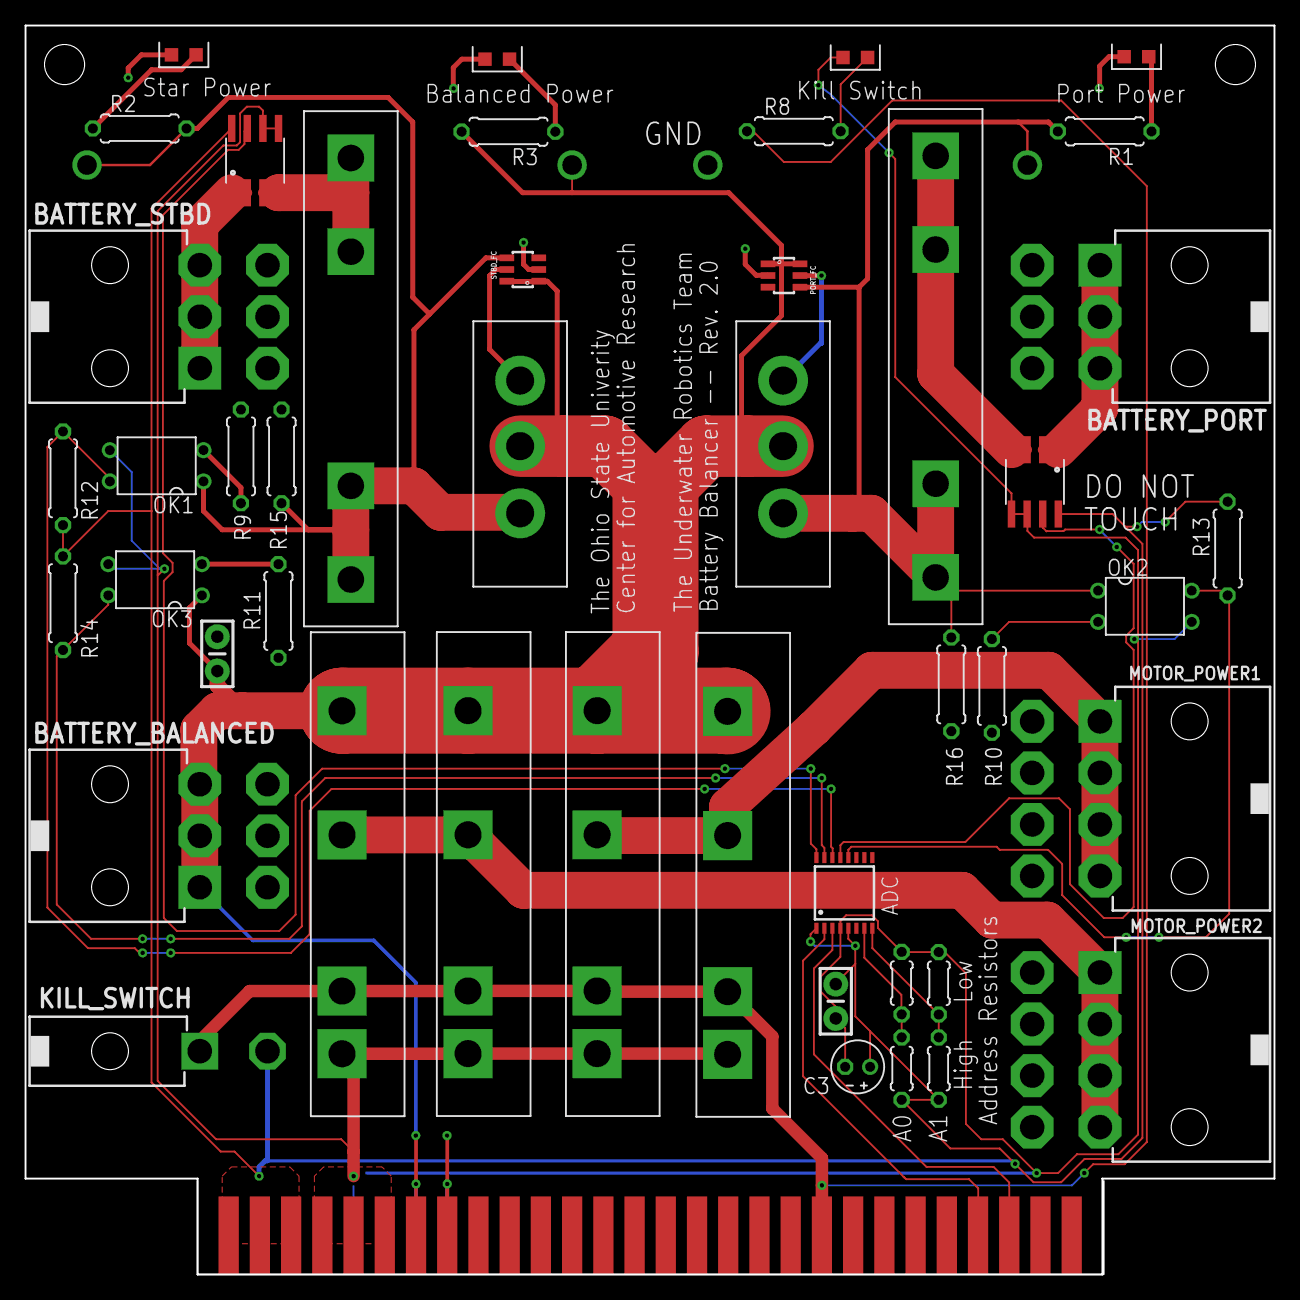
[picture p40: board batteryBalancer.brd from above]

Board: 2 copper layers, 101.6 x 101.6 mm, 50 parts (0 on the bottom side), 31 nets.
