osu-uwrt/hardware_boards/pneumaticsBoard/ConverterBoard.brd

## EAGLE design pneumaticsBoard/ConverterBoard.brd (2018-01-17)

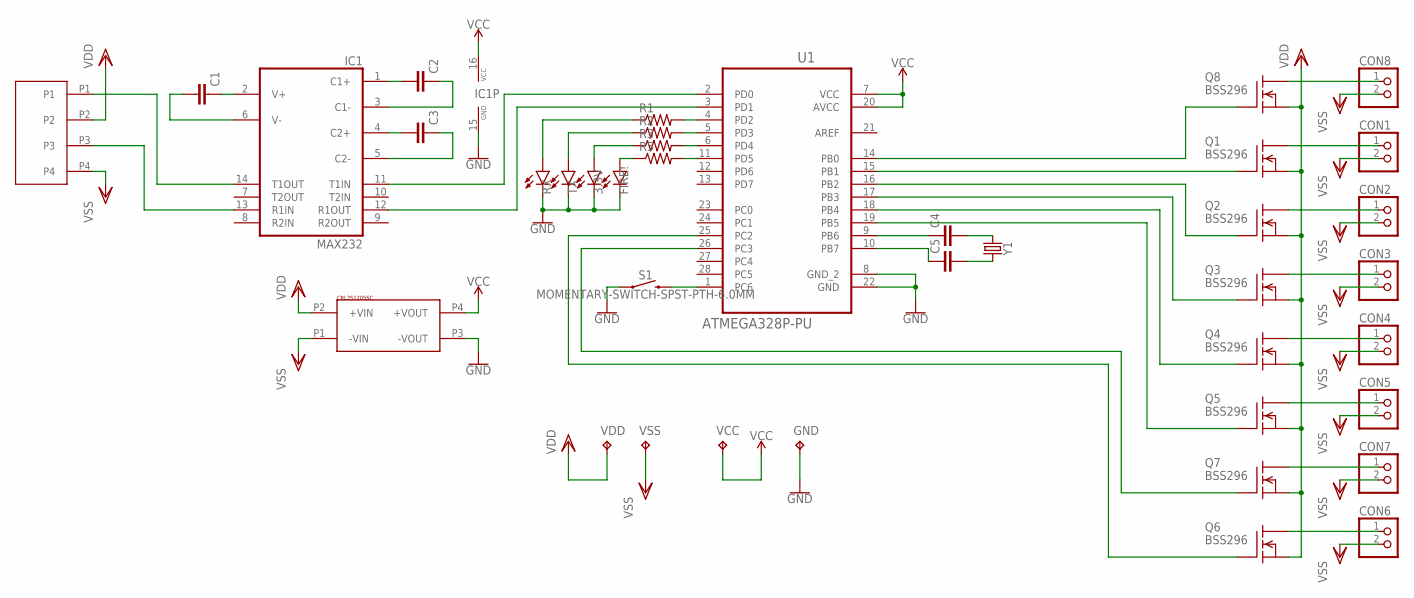
[picture p41: schematic ConverterBoard.sch]

Parts:
3.3V: BLUE; LED-0603
C1, C2, C3, C4, C5: C2.5/2; C2.5-2
CON1, CON2, CON3, CON4, CON5, CON6, CON7, CON8: PINHD-1X2; 1X02
FIRE!: BLUE; LED-0603
GND: TPTP11R; TP11R
IC1: MAX232; DIL16
Q1, Q2, Q3, Q4, Q5, Q6, Q7, Q8: BSS296; TO92
R1, R2, R3, R5: R-US_0204/2V; 0204V
RX: BLUE; LED-0603
S1: MOMENTARY-SWITCH-SPST-PTH-6.0MM; TACTILE_SWITCH_PTH_6.0MM
TX: BLUE; LED-0603
U1: ATMEGA328P-PU; DIP254P762X457-28
U$1: CRL2S1205SC
U$2: MINI_FIT_JR_4PIN_VERT
VCC: TPTP11R; TP11R
VDD: TPTP11R; TP11R
VSS: TPTP11R; TP11R
Y1: CRYSTALPTH-HC49UV; HC49U

Connections:
GND: 3.3V.C, FIRE!.C, GND.TP, IC1.15 (GND), RX.C, S1.1, TX.C, U1.8 (GND_2), U1.22 (GND), U$1.P3 (-VOUT)
unnamed: R3.2, U1.6 (PD4)
unnamed: FIRE!.A, R5.1
unnamed: R1.2, U1.4 (PD2)
unnamed: R2.2, U1.5 (PD3)
unnamed: C2.2, IC1.1 (C1+)
unnamed: C3.2, IC1.4 (C2+)
unnamed: C2.1, IC1.3 (C1-)
unnamed: C3.1, IC1.5 (C2-)
unnamed: C1.1, IC1.2 (V+)
unnamed: C1.2, IC1.6 (V-)
unnamed: CON8.1, Q8.2 (D)
unnamed: C4.2, Y1.1
unnamed: C5.2, Y1.2
unnamed: CON1.1, Q1.2 (D)
unnamed: CON2.1, Q2.2 (D)
unnamed: CON3.1, Q3.2 (D)
unnamed: CON4.1, Q4.2 (D)
unnamed: CON5.1, Q5.2 (D)
unnamed: CON7.1, Q7.2 (D)
unnamed: CON6.1, Q6.2 (D)
unnamed: R5.2, U1.11 (PD5)
POWER: 3.3V.A, R3.1
Q1: Q1.1 (G), U1.15 (PB1)
Q2: Q2.1 (G), U1.16 (PB2)
Q3: Q3.1 (G), U1.17 (PB3)
Q4: Q4.1 (G), U1.18 (PB4)
Q5: Q5.1 (G), U1.19 (PB5)
Q6: Q6.1 (G), U1.25 (PC2)
Q7: Q7.1 (G), U1.26 (PC3)
Q8: Q8.1 (G), U1.14 (PB0)
RESET: S1.3 (2), U1.1 (PC6)
RS232_RX-ATMEGA_TX: IC1.12 (R1OUT), U1.3 (PD1)
RS232_TX-ATMEGA_RX: IC1.11 (T1IN), U1.2 (PD0)
RX: IC1.13 (R1IN), U$2.P3
RX_ON: R1.1, RX.A
TX: IC1.14 (T1OUT), U$2.P1
TX_ON: R2.1, TX.A
VCC: IC1.16 (VCC), U1.7 (VCC), U1.20 (AVCC), U$1.P4 (+VOUT), VCC.TP
VDD: Q1.3 (S), Q2.3 (S), Q3.3 (S), Q4.3 (S), Q5.3 (S), Q6.3 (S), Q7.3 (S), Q8.3 (S), U$1.P2 (+VIN), U$2.P2, VDD.TP
VSS: CON1.2, CON2.2, CON3.2, CON4.2, CON5.2, CON6.2, CON7.2, CON8.2, U$1.P1 (-VIN), U$2.P4, VSS.TP
XTAL1: C4.1, U1.9 (PB6)
XTAL2: C5.1, U1.10 (PB7)

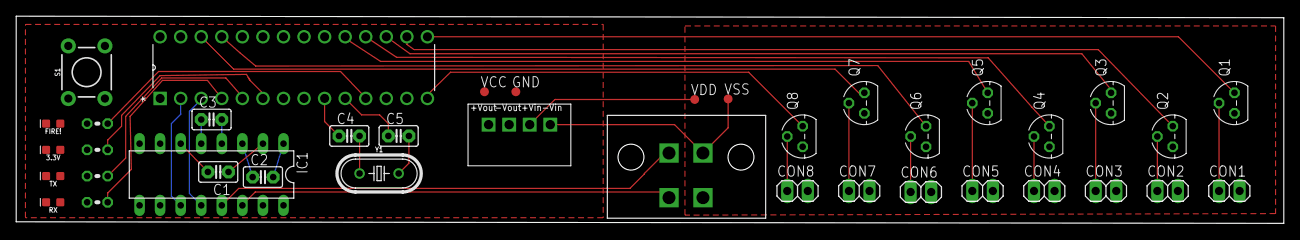
[picture p42: board pneumaticsBoard/ConverterBoard.brd from above]

Board: 2 copper layers, 156.6 x 25.6 mm, 39 parts (0 on the bottom side), 43 nets.
