osu-uwrt/hardware_boards/backplane/backplane.brd

## EAGLE design backplane/backplane.brd (2017-10-22)

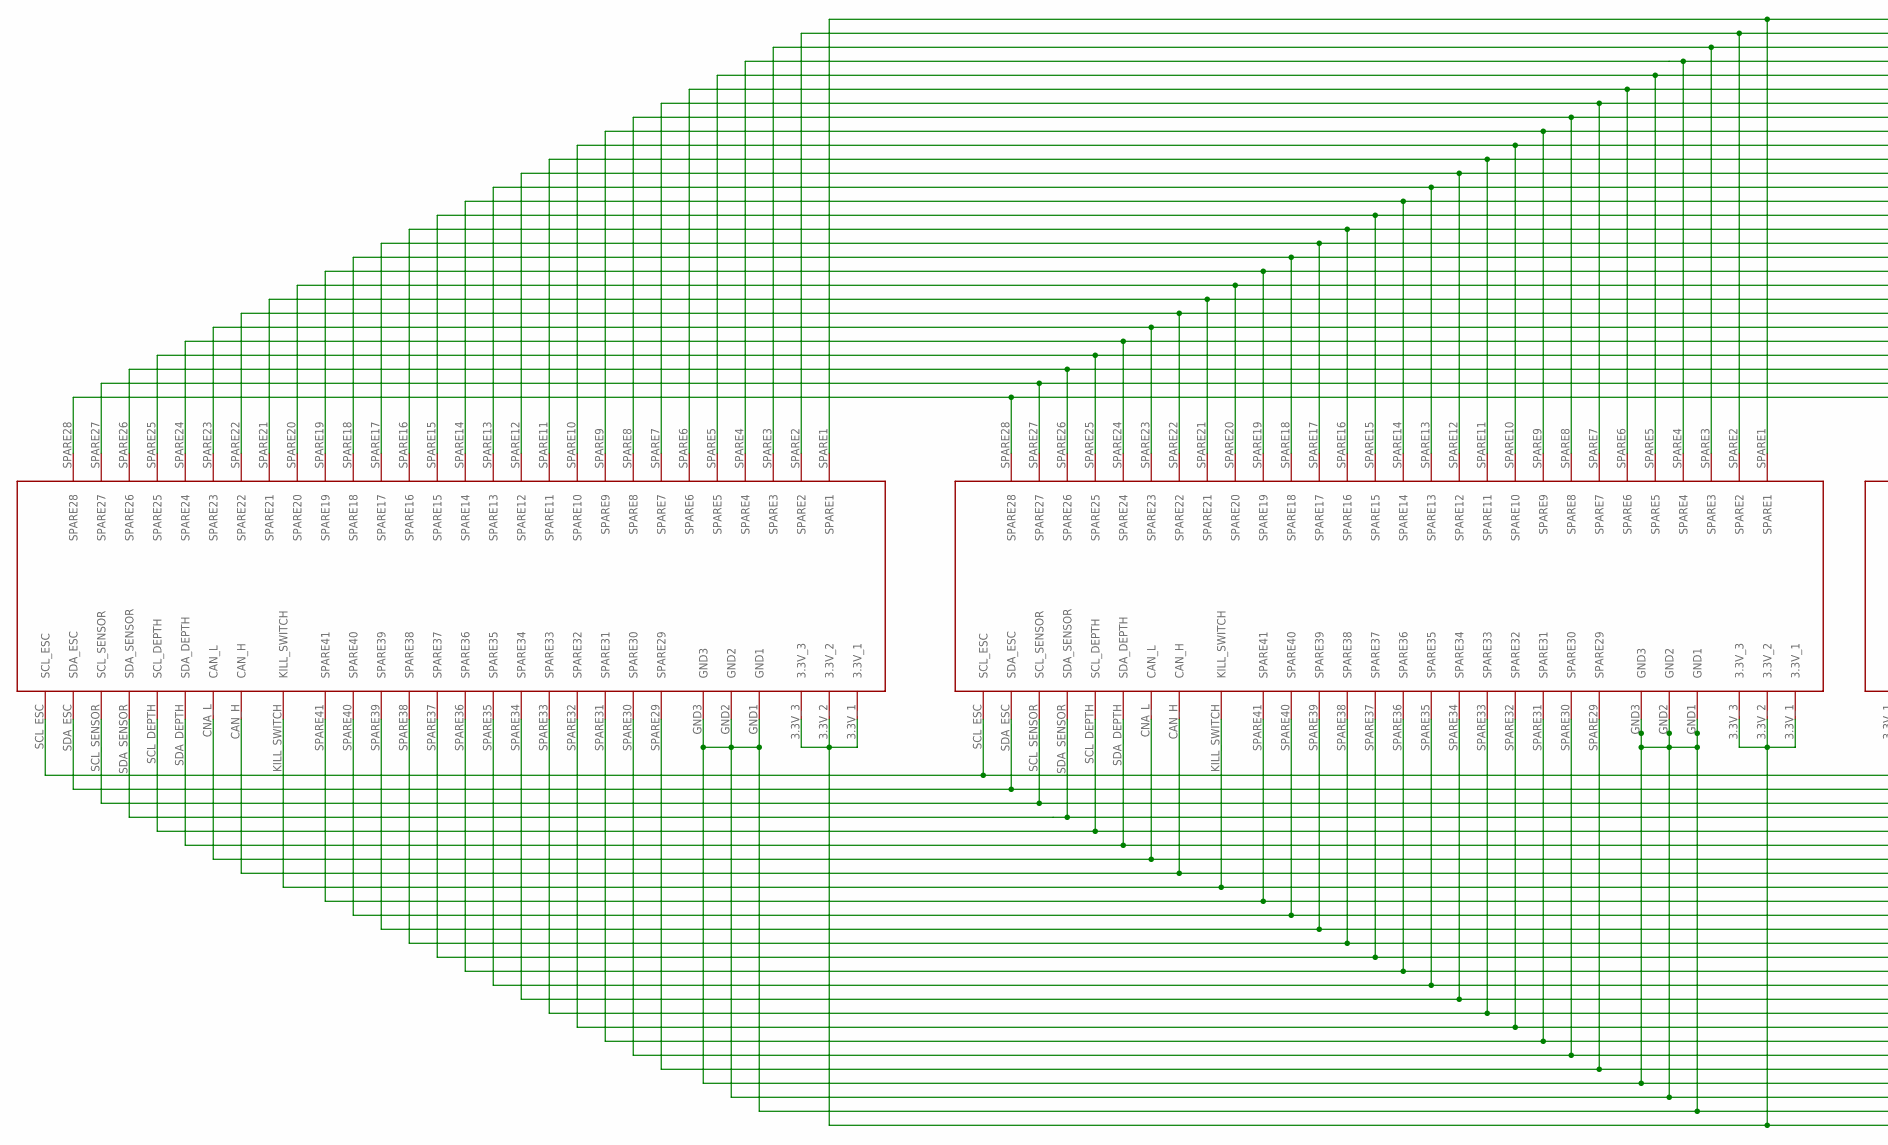
[picture p43: schematic backplane.sch, part in row 1, column 1]

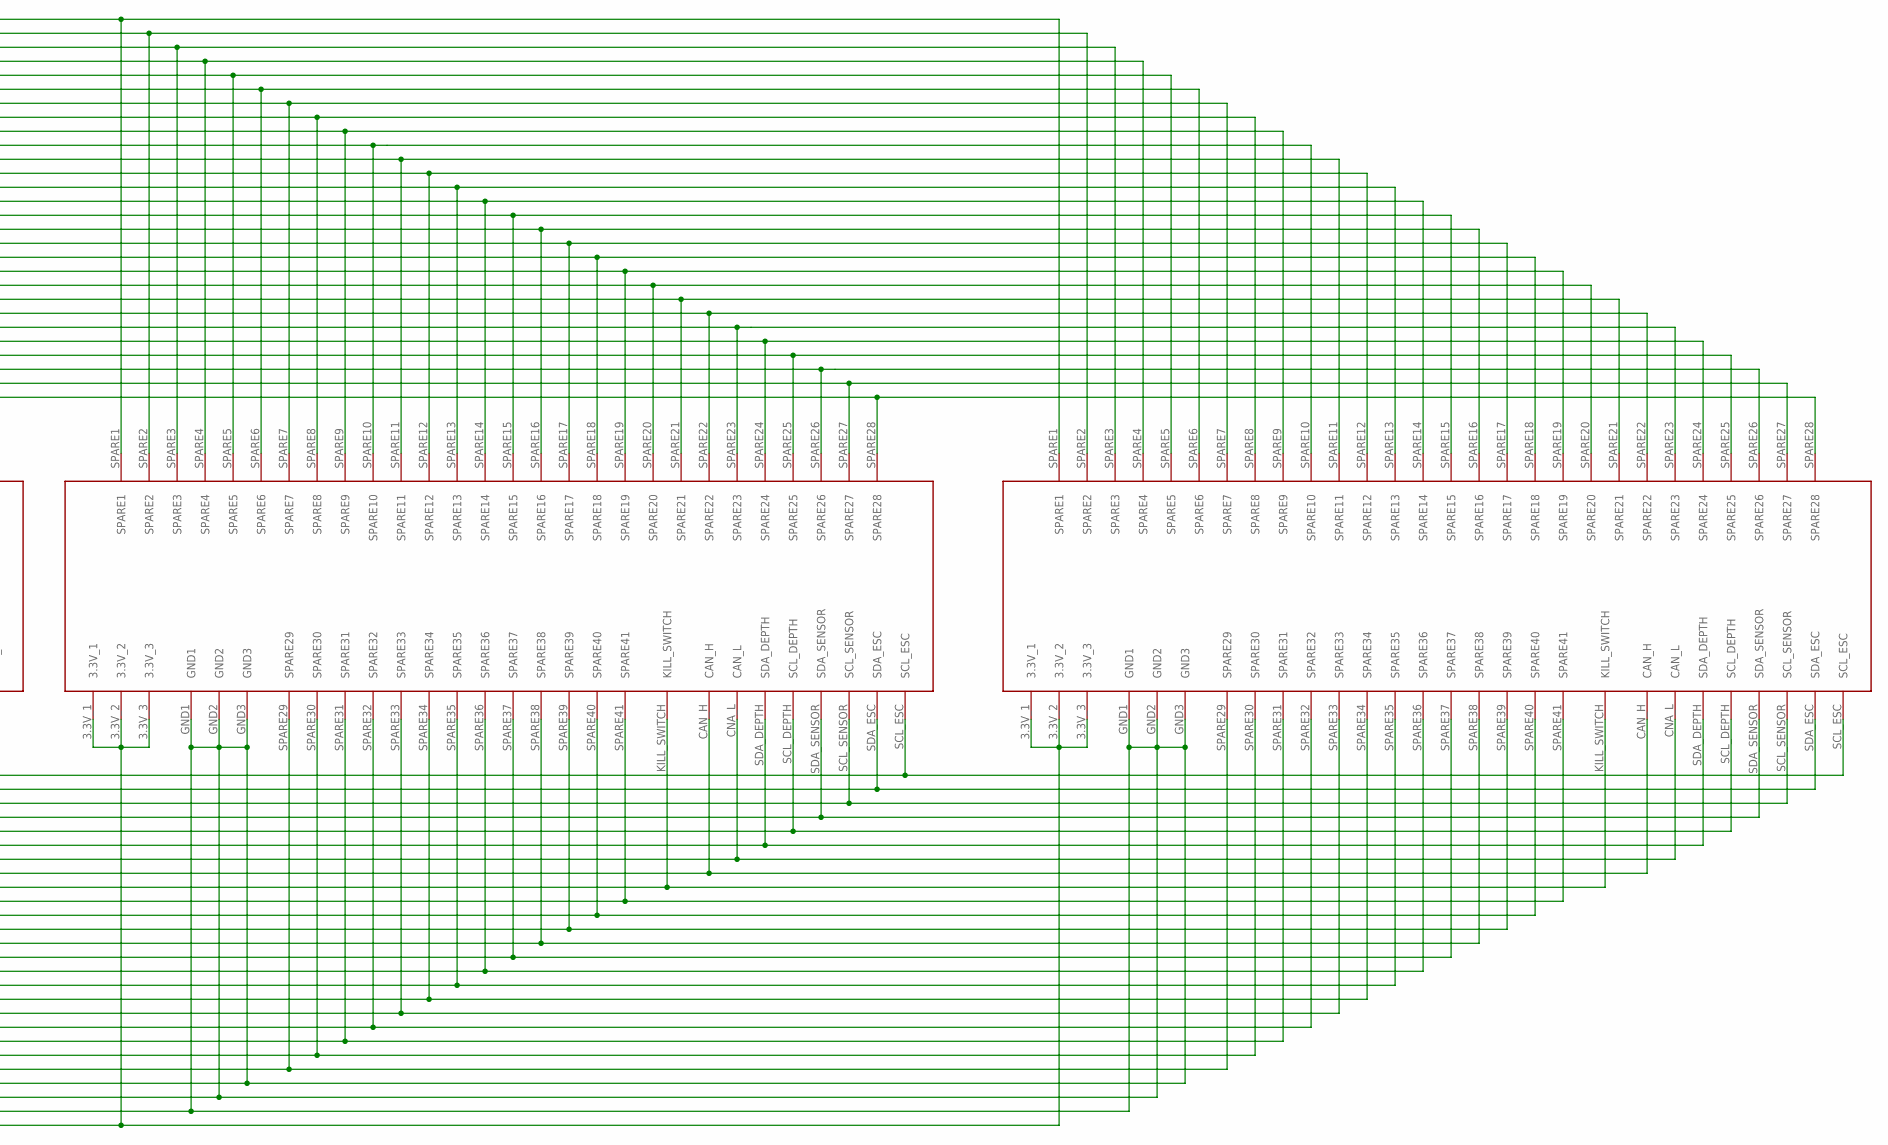
[picture p44: schematic backplane.sch, part in row 1, column 2]

Parts:
CO-PROCESSOR: 5530843_MATE; 5530843-6-BACKPLANEMATE
CONVERTER: 5530843_MATE; 5530843-6-BACKPLANEMATE
EXTRA: 5530843_MATE; 5530843-6-BACKPLANEMATE
LOAD_BALANCER: 5530843_MATE; 5530843-6-BACKPLANEMATE

Connections:
3.3: CO-PROCESSOR.3.3V_1, CO-PROCESSOR.3.3V_2, CO-PROCESSOR.3.3V_3, CO-PROCESSOR.SPARE1, CO-PROCESSOR.SPARE2, CO-PROCESSOR.SPARE3, CONVERTER.3.3V_1, CONVERTER.3.3V_2, CONVERTER.3.3V_3, CONVERTER.SPARE1, CONVERTER.SPARE2, CONVERTER.SPARE3, EXTRA.3.3V_1, EXTRA.3.3V_2, EXTRA.3.3V_3, EXTRA.SPARE1, EXTRA.SPARE2, EXTRA.SPARE3, LOAD_BALANCER.3.3V_1, LOAD_BALANCER.3.3V_2, LOAD_BALANCER.3.3V_3, LOAD_BALANCER.SPARE1, LOAD_BALANCER.SPARE2, LOAD_BALANCER.SPARE3
CAN_H: CO-PROCESSOR.CAN_H, CONVERTER.CAN_H, EXTRA.CAN_H, LOAD_BALANCER.CAN_H
CAN_L: CO-PROCESSOR.CNA_L (CAN_L), CONVERTER.CNA_L (CAN_L), EXTRA.CNA_L (CAN_L), LOAD_BALANCER.CNA_L (CAN_L)
GND: CO-PROCESSOR.GND1, CO-PROCESSOR.GND2, CO-PROCESSOR.GND3, CO-PROCESSOR.SPARE4, CO-PROCESSOR.SPARE5, CO-PROCESSOR.SPARE6, CONVERTER.GND1, CONVERTER.GND2, CONVERTER.GND3, CONVERTER.SPARE4, CONVERTER.SPARE5, CONVERTER.SPARE6, EXTRA.GND1, EXTRA.GND2, EXTRA.GND3, EXTRA.SPARE4, EXTRA.SPARE5, EXTRA.SPARE6, LOAD_BALANCER.GND1, LOAD_BALANCER.GND2, LOAD_BALANCER.GND3, LOAD_BALANCER.SPARE4, LOAD_BALANCER.SPARE5, LOAD_BALANCER.SPARE6
KILL_SWITCH: CO-PROCESSOR.KILL_SWITCH, CONVERTER.KILL_SWITCH, EXTRA.KILL_SWITCH, LOAD_BALANCER.KILL_SWITCH
SCL_DEPTH: CO-PROCESSOR.SCL_DEPTH, CONVERTER.SCL_DEPTH, EXTRA.SCL_DEPTH, LOAD_BALANCER.SCL_DEPTH
SCL_ESC: CO-PROCESSOR.SCL_ESC, CONVERTER.SCL_ESC, EXTRA.SCL_ESC, LOAD_BALANCER.SCL_ESC
SCL_SENSOR: CO-PROCESSOR.SCL_SENSOR, CONVERTER.SCL_SENSOR, EXTRA.SCL_SENSOR, LOAD_BALANCER.SCL_SENSOR
SDA_DEPTH: CO-PROCESSOR.SDA_DEPTH, CONVERTER.SDA_DEPTH, EXTRA.SDA_DEPTH, LOAD_BALANCER.SDA_DEPTH
SDA_ESC: CO-PROCESSOR.SDA_ESC, CONVERTER.SDA_ESC, EXTRA.SDA_ESC, LOAD_BALANCER.SDA_ESC
SDA_SENSOR: CO-PROCESSOR.SDA_SENSOR, CONVERTER.SDA_SENSOR, EXTRA.SDA_SENSOR, LOAD_BALANCER.SDA_SENSOR
SPARE7: CO-PROCESSOR.SPARE7, CONVERTER.SPARE7, EXTRA.SPARE7, LOAD_BALANCER.SPARE7
SPARE8: CO-PROCESSOR.SPARE8, CONVERTER.SPARE8, EXTRA.SPARE8, LOAD_BALANCER.SPARE8
SPARE9: CO-PROCESSOR.SPARE9, CONVERTER.SPARE9, EXTRA.SPARE9, LOAD_BALANCER.SPARE9
SPARE10: CO-PROCESSOR.SPARE10, CONVERTER.SPARE10, EXTRA.SPARE10, LOAD_BALANCER.SPARE10
SPARE11: CO-PROCESSOR.SPARE11, CONVERTER.SPARE11, EXTRA.SPARE11, LOAD_BALANCER.SPARE11
SPARE12: CO-PROCESSOR.SPARE12, CONVERTER.SPARE12, EXTRA.SPARE12, LOAD_BALANCER.SPARE12
SPARE13: CO-PROCESSOR.SPARE13, CONVERTER.SPARE13, EXTRA.SPARE13, LOAD_BALANCER.SPARE13
SPARE14: CO-PROCESSOR.SPARE14, CONVERTER.SPARE14, EXTRA.SPARE14, LOAD_BALANCER.SPARE14
SPARE15: CO-PROCESSOR.SPARE15, CONVERTER.SPARE15, EXTRA.SPARE15, LOAD_BALANCER.SPARE15
SPARE16: CO-PROCESSOR.SPARE16, CONVERTER.SPARE16, EXTRA.SPARE16, LOAD_BALANCER.SPARE16
SPARE17: CO-PROCESSOR.SPARE17, CONVERTER.SPARE17, EXTRA.SPARE17, LOAD_BALANCER.SPARE17
SPARE18: CO-PROCESSOR.SPARE18, CONVERTER.SPARE18, EXTRA.SPARE18, LOAD_BALANCER.SPARE18
SPARE19: CO-PROCESSOR.SPARE19, CONVERTER.SPARE19, EXTRA.SPARE19, LOAD_BALANCER.SPARE19
SPARE20: CO-PROCESSOR.SPARE20, CONVERTER.SPARE20, EXTRA.SPARE20, LOAD_BALANCER.SPARE20
SPARE21: CO-PROCESSOR.SPARE21, CONVERTER.SPARE21, EXTRA.SPARE21, LOAD_BALANCER.SPARE21
SPARE22: CO-PROCESSOR.SPARE22, CONVERTER.SPARE22, EXTRA.SPARE22, LOAD_BALANCER.SPARE22
SPARE23: CO-PROCESSOR.SPARE23, CONVERTER.SPARE23, EXTRA.SPARE23, LOAD_BALANCER.SPARE23
SPARE24: CO-PROCESSOR.SPARE24, CONVERTER.SPARE24, EXTRA.SPARE24, LOAD_BALANCER.SPARE24
SPARE25: CO-PROCESSOR.SPARE25, CONVERTER.SPARE25, EXTRA.SPARE25, LOAD_BALANCER.SPARE25
SPARE26: CO-PROCESSOR.SPARE26, CONVERTER.SPARE26, EXTRA.SPARE26, LOAD_BALANCER.SPARE26
SPARE27: CO-PROCESSOR.SPARE27, CONVERTER.SPARE27, EXTRA.SPARE27, LOAD_BALANCER.SPARE27
SPARE28: CO-PROCESSOR.SPARE28, CONVERTER.SPARE28, EXTRA.SPARE28, LOAD_BALANCER.SPARE28
SPARE29: CO-PROCESSOR.SPARE29, CONVERTER.SPARE29, EXTRA.SPARE29, LOAD_BALANCER.SPARE29
SPARE30: CO-PROCESSOR.SPARE30, CONVERTER.SPARE30, EXTRA.SPARE30, LOAD_BALANCER.SPARE30
SPARE31: CO-PROCESSOR.SPARE31, CONVERTER.SPARE31, EXTRA.SPARE31, LOAD_BALANCER.SPARE31
SPARE32: CO-PROCESSOR.SPARE32, CONVERTER.SPARE32, EXTRA.SPARE32, LOAD_BALANCER.SPARE32
SPARE33: CO-PROCESSOR.SPARE33, CONVERTER.SPARE33, EXTRA.SPARE33, LOAD_BALANCER.SPARE33
SPARE34: CO-PROCESSOR.SPARE34, CONVERTER.SPARE34, EXTRA.SPARE34, LOAD_BALANCER.SPARE34
SPARE35: CO-PROCESSOR.SPARE35, CONVERTER.SPARE35, EXTRA.SPARE35, LOAD_BALANCER.SPARE35
SPARE36: CO-PROCESSOR.SPARE36, CONVERTER.SPARE36, EXTRA.SPARE36, LOAD_BALANCER.SPARE36
SPARE37: CO-PROCESSOR.SPARE37, CONVERTER.SPARE37, EXTRA.SPARE37, LOAD_BALANCER.SPARE37
SPARE38: CO-PROCESSOR.SPARE38, CONVERTER.SPARE38, EXTRA.SPARE38, LOAD_BALANCER.SPARE38
SPARE39: CO-PROCESSOR.SPARE39, CONVERTER.SPARE39, EXTRA.SPARE39, LOAD_BALANCER.SPARE39
SPARE40: CO-PROCESSOR.SPARE40, CONVERTER.SPARE40, EXTRA.SPARE40, LOAD_BALANCER.SPARE40
SPARE41: CO-PROCESSOR.SPARE41, CONVERTER.SPARE41, EXTRA.SPARE41, LOAD_BALANCER.SPARE41

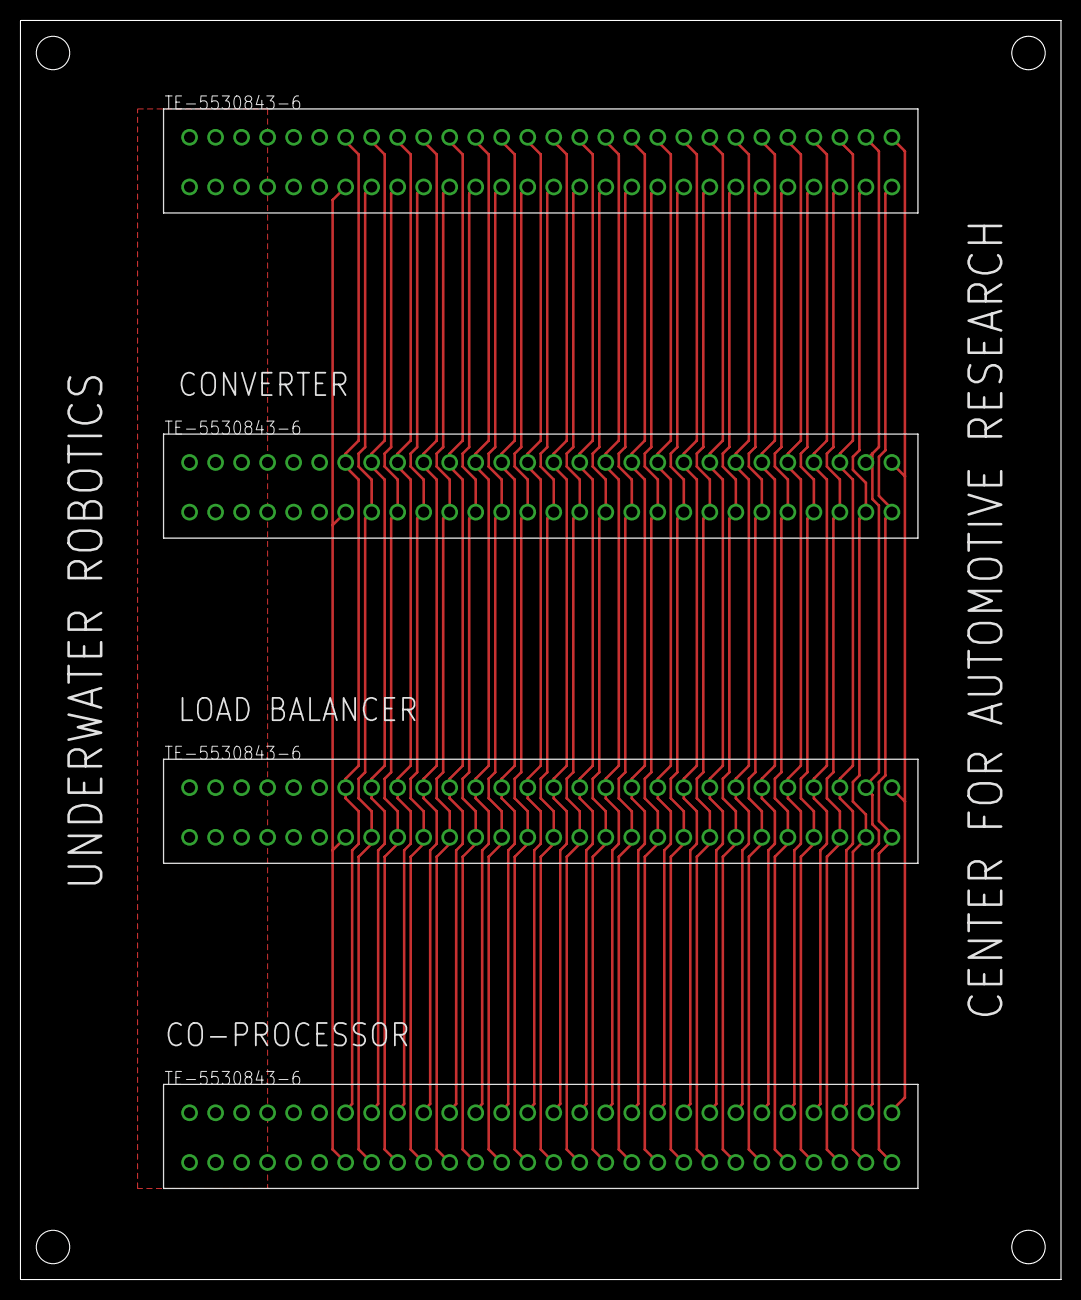
[picture p45: board backplane.brd from above]

Board: 2 copper layers, 101.6 x 122.9 mm, 4 parts (0 on the bottom side), 46 nets.
