osu-uwrt/hardware_boards/powerSupply/power_supply.brd

## EAGLE design powerSupply/power_supply.brd (2017-08-23)

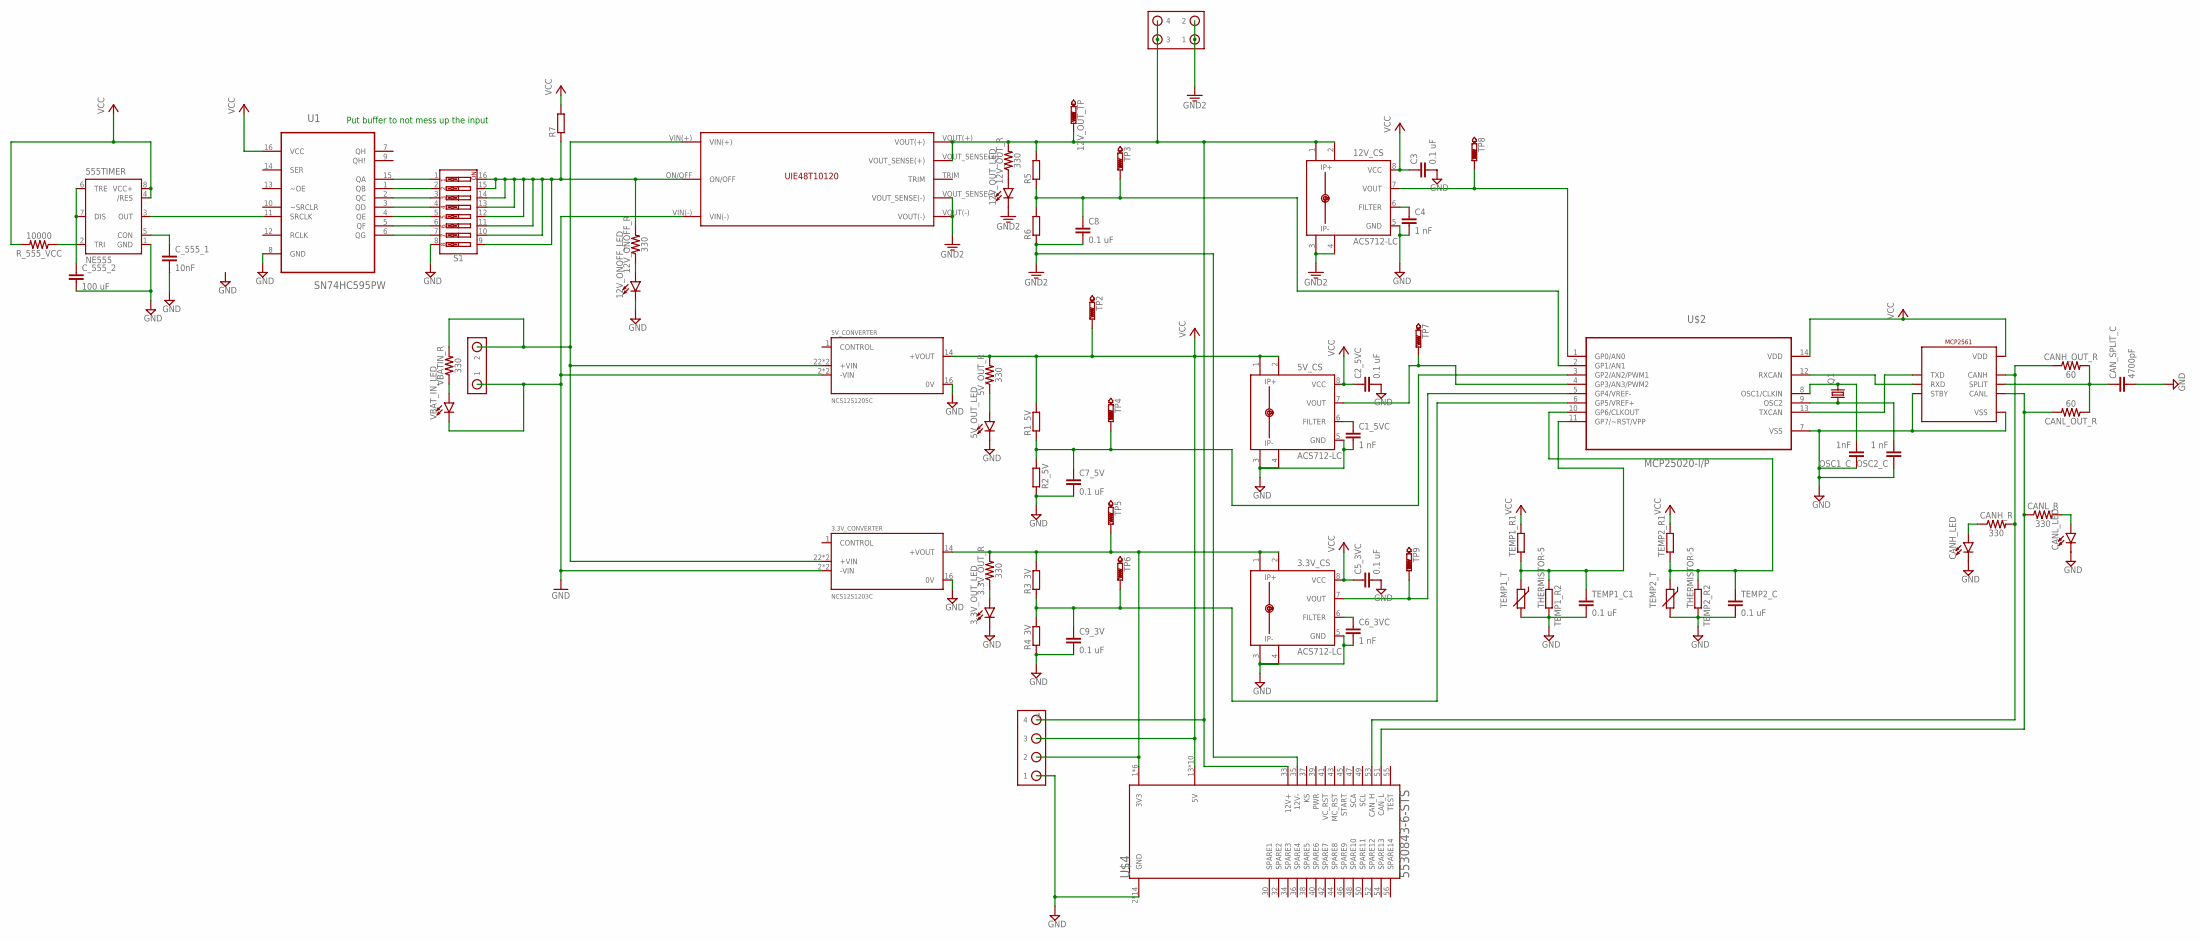
[picture p46: schematic power_supply.sch]

Parts:
3.3V_CONVERTER: NCS12S1203C; CONV_NCS12S1203C
3.3V_CS, 5V_CS, 12V_CS: ACS712-LC; SOIC8
3.3V_OUT_LED, 5V_OUT_LED, 12V_ONOFF_LED, 12V_OUT_LED: LED1206; LED-1206
3.3V_OUT_R, 5V_OUT_R, 12V_ONOFF_R, 12V_OUT_R: 330; 0603
5V_CONVERTER: NCS12S1205C; CONV_NCS12S1205C
12V_OUT_TP: PTR1B1,27; B1,27
555TIMER: NE555; DIL-08
C1_5VC, C4, C6_3VC: 1 nF; C2.5-2
C2_5VC, C3, C5_3VC, C7_5V, C8, C9_3V: 0.1 uF; C2.5-2
CANH_LED: LED1206; LED-1206
CANH_OUT_R: 60; 0603
CANH_R: 330; 0603
CANL_LED: LED1206; LED-1206
CANL_OUT_R: 60; 0603
CANL_R: 330; 0603
CAN_SPLIT_C: 4700pF; C2.5-2
C_555_1: 10nF; C2.5-2
C_555_2: 100 uF; C2.5-2
MCP2561: MCP2561; SOIC8
OSC1_C: 1nF; C2.5-2
OSC2_C: 1 nF; C2.5-2
POWER_IN: 39-30-1020; 5569-02A2
Q1: CRYSTALHC49S; HC49/S
R1_5V, R2_5V, R3_3V, R4_3V, R5, R6, R7: R0204/7; 0204/7
R_555_VCC: 10000; 0603
S1: DIP-08-PTH; DIPSWITCH-08
TEMP1_C1, TEMP2_C: 0.1 uF; C2.5-2
TEMP1_R1, TEMP1_R2, TEMP2_R1, TEMP2_R2: R0204/7; 0204/7
TEMP1_T, TEMP2_T: THERMISTOR-5; R-5
TP2, TP3, TP4, TP5, TP6, TP7, TP8, TP9: PTR1B1,27; B1,27
U1: SN74HC595PW; SOP65P640X120-16N
U$1: UIE48T10120
U$2: MCP25020-I/P; DIP254P762X432-14
U$4: 5530843-6-STS; 5530843-6-BOARD
U$6: 39-30-1040; 5569-04A2
U$7: 70555-0003
VBATIN_R: 330; 0603
VBAT_IN_LED: LED1206; LED-1206

Connections:
3.3V_ANA_CUR_OUT: 3.3V_CS.7 (VOUT), TP9.TP, U$2.5 (GP4/VREF-)
3.3V_OUT: 3.3V_CONVERTER.14 (+VOUT), 3.3V_CS.1 (IP+), 3.3V_CS.2 (IP+1), 3.3V_OUT_R.2, R3_3V.2, TP5.TP, U$4.1 (3V3), U$4.3 (3V3), U$4.5 (3V3), U$4.7 (3V3), U$4.9 (3V3), U$4.11 (3V3), U$7.2
3.3V_OUT_LED: 3.3V_OUT_LED.A, 3.3V_OUT_R.1
3V_VOL_ANA_OUT: C9_3V.1, R3_3V.1, R4_3V.2, TP6.TP, U$2.6 (GP5/VREF+)
5V_CUR_ANA_OUT: 5V_CS.7 (VOUT), TP7.TP, U$2.4 (GP3/AN3/PWM2)
5V_OUT_LED: 5V_OUT_LED.A, 5V_OUT_R.1
5V_VOL_ANA_OUT: C7_5V.1, R1_5V.1, R2_5V.1, TP4.TP, U$2.3 (GP2/AN2/PWM1)
12V_CON_ONOFF: 12V_ONOFF_R.2, R7.1, S1.9, S1.10, S1.11, S1.12, S1.13, S1.14, S1.15, S1.16, U$1.ON/OFF
12V_CUR_ANA_OUT: 12V_CS.7 (VOUT), TP8.TP, U$2.1 (GP0/AN0)
12V_FILTER: 12V_CS.6 (FILTER), C4.1
12V_GND: 12V_CS.3 (IP-), 12V_CS.4 (IP-1), 12V_OUT_LED.C, C8.2, R6.1, U$1.VOUT(-), U$1.VOUT_SENSE(-), U$4.35 (12V-), U$6.3 (2), U$6.4 (1)
12V_ONOFF_LED: 12V_ONOFF_LED.A, 12V_ONOFF_R.1
12V_OUT: 12V_CS.1 (IP+), 12V_CS.2 (IP+1), 12V_OUT_R.2, 12V_OUT_TP.TP, R5.2, U$1.VOUT(+), U$1.VOUT_SENSE(+), U$4.33 (12V+), U$6.1 (4), U$6.2 (3), U$7.4
12V_OUT_LED: 12V_OUT_LED.A, 12V_OUT_R.1
12V_VOL_ANA_OUT: C8.1, R5.1, R6.2, TP3.TP, U$2.2 (GP1/AN1)
555_CON: 555TIMER.5 (CON), C_555_1.1
555_TREDIS: 555TIMER.6 (TRE), 555TIMER.7 (DIS), C_555_2.1
555_TRIG: 555TIMER.2 (TRI), R_555_VCC.1
CANH_LED: CANH_LED.A, CANH_R.1
CANH_OUT: CANH_OUT_R.1, CANH_R.2, MCP2561.P$7 (CANH), U$4.53 (CAN_H)
CANL_LED: CANL_LED.A, CANL_R.2
CANL_OUT: CANL_OUT_R.2, CANL_R.1, MCP2561.P$6 (CANL), U$4.51 (CAN_L)
CAN_SPLIT: CANH_OUT_R.2, CANL_OUT_R.1, CAN_SPLIT_C.1, MCP2561.P$5 (SPLIT)
FILTER_3V: 3.3V_CS.6 (FILTER), C6_3VC.1
FILTER_5V: 5V_CS.6 (FILTER), C1_5VC.1
GND: 3.3V_CONVERTER.16 (0V), 3.3V_CS.3 (IP-), 3.3V_CS.4 (IP-1), 3.3V_CS.5 (GND), 3.3V_OUT_LED.C, 5V_CONVERTER.16 (0V), 5V_CS.3 (IP-), 5V_CS.4 (IP-1), 5V_CS.5 (GND), 5V_OUT_LED.C, 12V_CS.5 (GND), 12V_ONOFF_LED.C, 555TIMER.1 (GND), C1_5VC.2, C2_5VC.2, C3.2, C4.2, C5_3VC.2, C6_3VC.2, C7_5V.2, C9_3V.2, CANH_LED.C, CANL_LED.C, CAN_SPLIT_C.2, C_555_1.2, C_555_2.2, MCP2561.P$2 (VSS), MCP2561.P$8 (STBY), OSC1_C.1, OSC2_C.1, R2_5V.2, R4_3V.1, S1.8, TEMP1_C1.2, TEMP1_R2.2, TEMP1_T.2, TEMP2_C.2, TEMP2_R2.2, TEMP2_T.2, U1.8 (GND), U$2.7 (VSS), U$4.2 (GND), U$4.4 (GND), U$4.6 (GND), U$4.8 (GND), U$4.10 (GND), U$4.12 (GND), U$4.14 (GND), U$4.16 (GND), U$4.18 (GND), U$4.20 (GND), U$4.22 (GND), U$4.24 (GND), U$4.26 (GND), U$4.28 (GND), U$7.1
unnamed: MCP2561.P$4 (RXD), U$2.12 (RXCAN)
unnamed: MCP2561.P$1 (TXD), U$2.13 (TXCAN)
NAND1: S1.1, U1.15 (QA)
NAND2: S1.2, U1.1 (QB)
NAND3: S1.3, U1.2 (QC)
NAND4: S1.4, U1.3 (QD)
NAND5: S1.5, U1.4 (QE)
NAND6: S1.6, U1.5 (QF)
NAND7: S1.7, U1.6 (QG)
OSC1: OSC1_C.2, Q1.2, U$2.8 (OSC1/CLKIN)
OSC2: OSC2_C.2, Q1.1, U$2.9 (OSC2)
OUT555: 555TIMER.3 (OUT), U1.11 (SRCLK)
TEMP1_ANA_OUT: TEMP1_C1.1, TEMP1_R1.1, TEMP1_R2.1, TEMP1_T.1, U$2.11 (GP7/~RST/VPP)
TEMP2_ANA_OUT: TEMP2_C.1, TEMP2_R1.1, TEMP2_R2.1, TEMP2_T.1, U$2.10 (GP6/CLKOUT)
VBAT_IN_LED: VBATIN_R.1, VBAT_IN_LED.A
VCC: 3.3V_CS.8 (VCC), 5V_CONVERTER.14 (+VOUT), 5V_CS.1 (IP+), 5V_CS.2 (IP+1), 5V_CS.8 (VCC), 5V_OUT_R.2, 12V_CS.8 (VCC), 555TIMER.4 (/RES), 555TIMER.8 (VCC+), C2_5VC.1, C3.1, C5_3VC.1, MCP2561.P$3 (VDD), R1_5V.2, R7.2, R_555_VCC.2, TEMP1_R1.2, TEMP2_R1.2, TP2.TP, U1.16 (VCC), U$2.14 (VDD), U$4.13 (5V), U$4.15 (5V), U$4.17 (5V), U$4.19 (5V), U$4.21 (5V), U$4.23 (5V), U$4.25 (5V), U$4.27 (5V), U$4.29 (5V), U$4.31 (5V), U$7.3
V_BAT_BAL+: 3.3V_CONVERTER.22 (+VIN), 3.3V_CONVERTER.23 (+VIN), 5V_CONVERTER.22 (+VIN), 5V_CONVERTER.23 (+VIN), POWER_IN.2, U$1.VIN(+), VBATIN_R.2
V_BAT_BAL-: 3.3V_CONVERTER.2 (-VIN), 3.3V_CONVERTER.3 (-VIN), 5V_CONVERTER.2 (-VIN), 5V_CONVERTER.3 (-VIN), POWER_IN.1, U$1.VIN(-), VBAT_IN_LED.C

Notes on the sheet:
Put buffer to not mess up the input

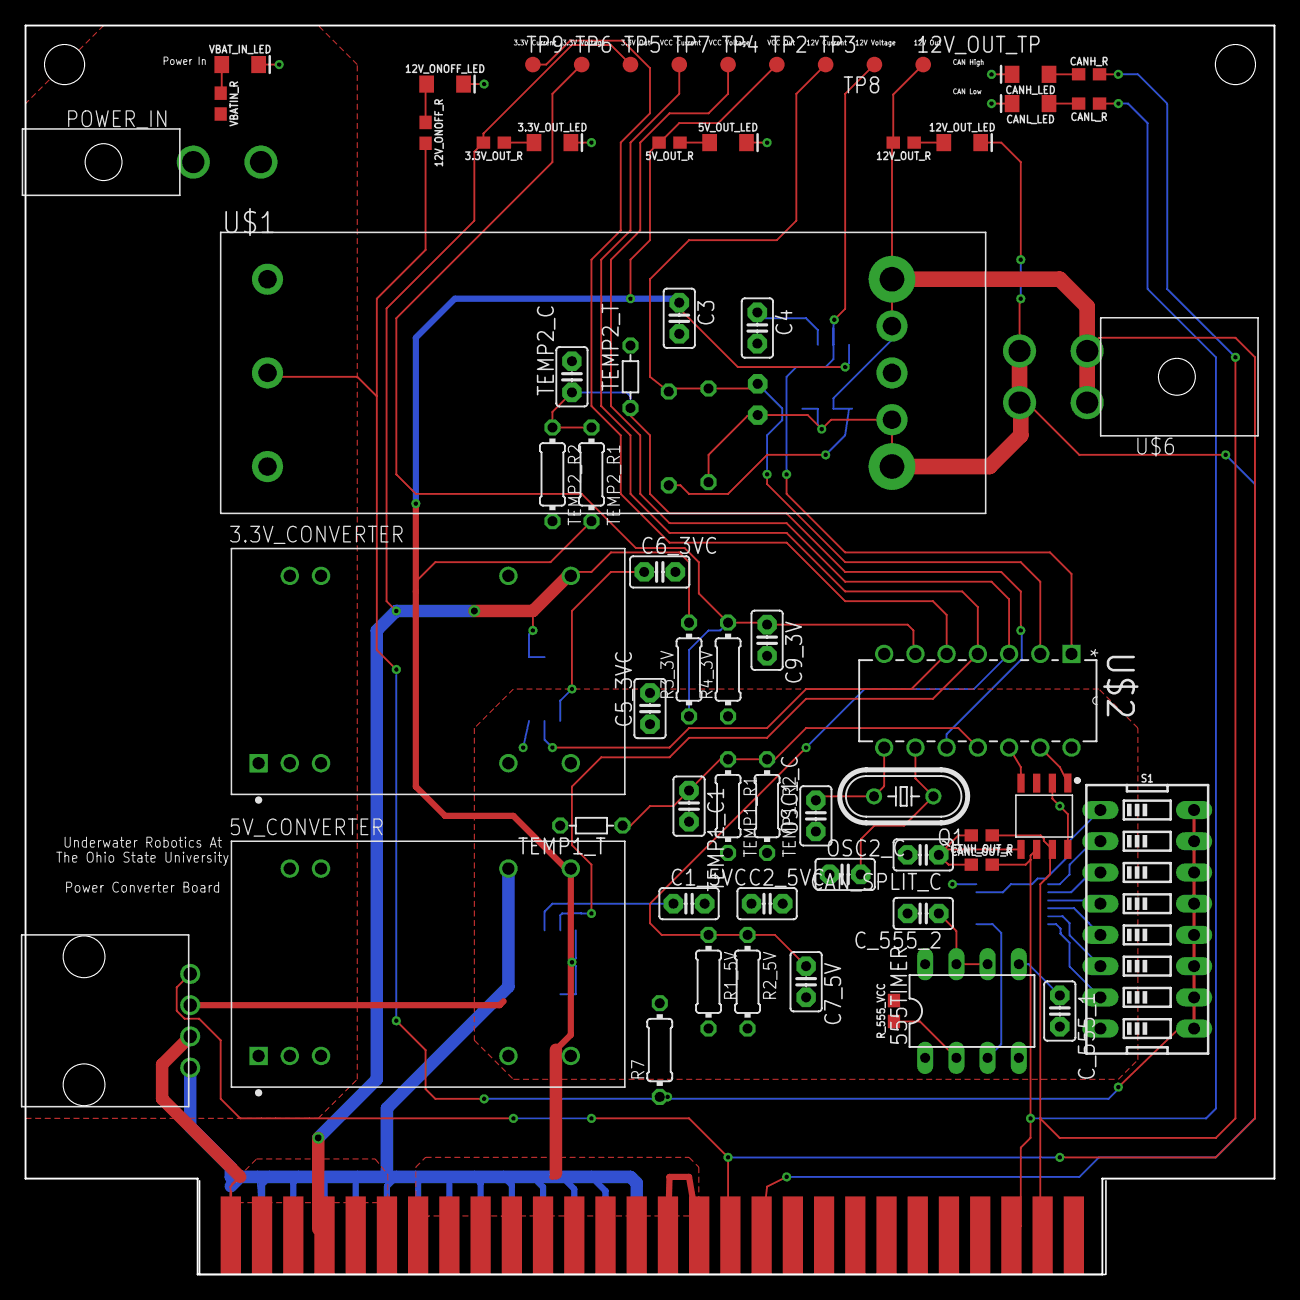
[picture p47: board power_supply.brd from above]

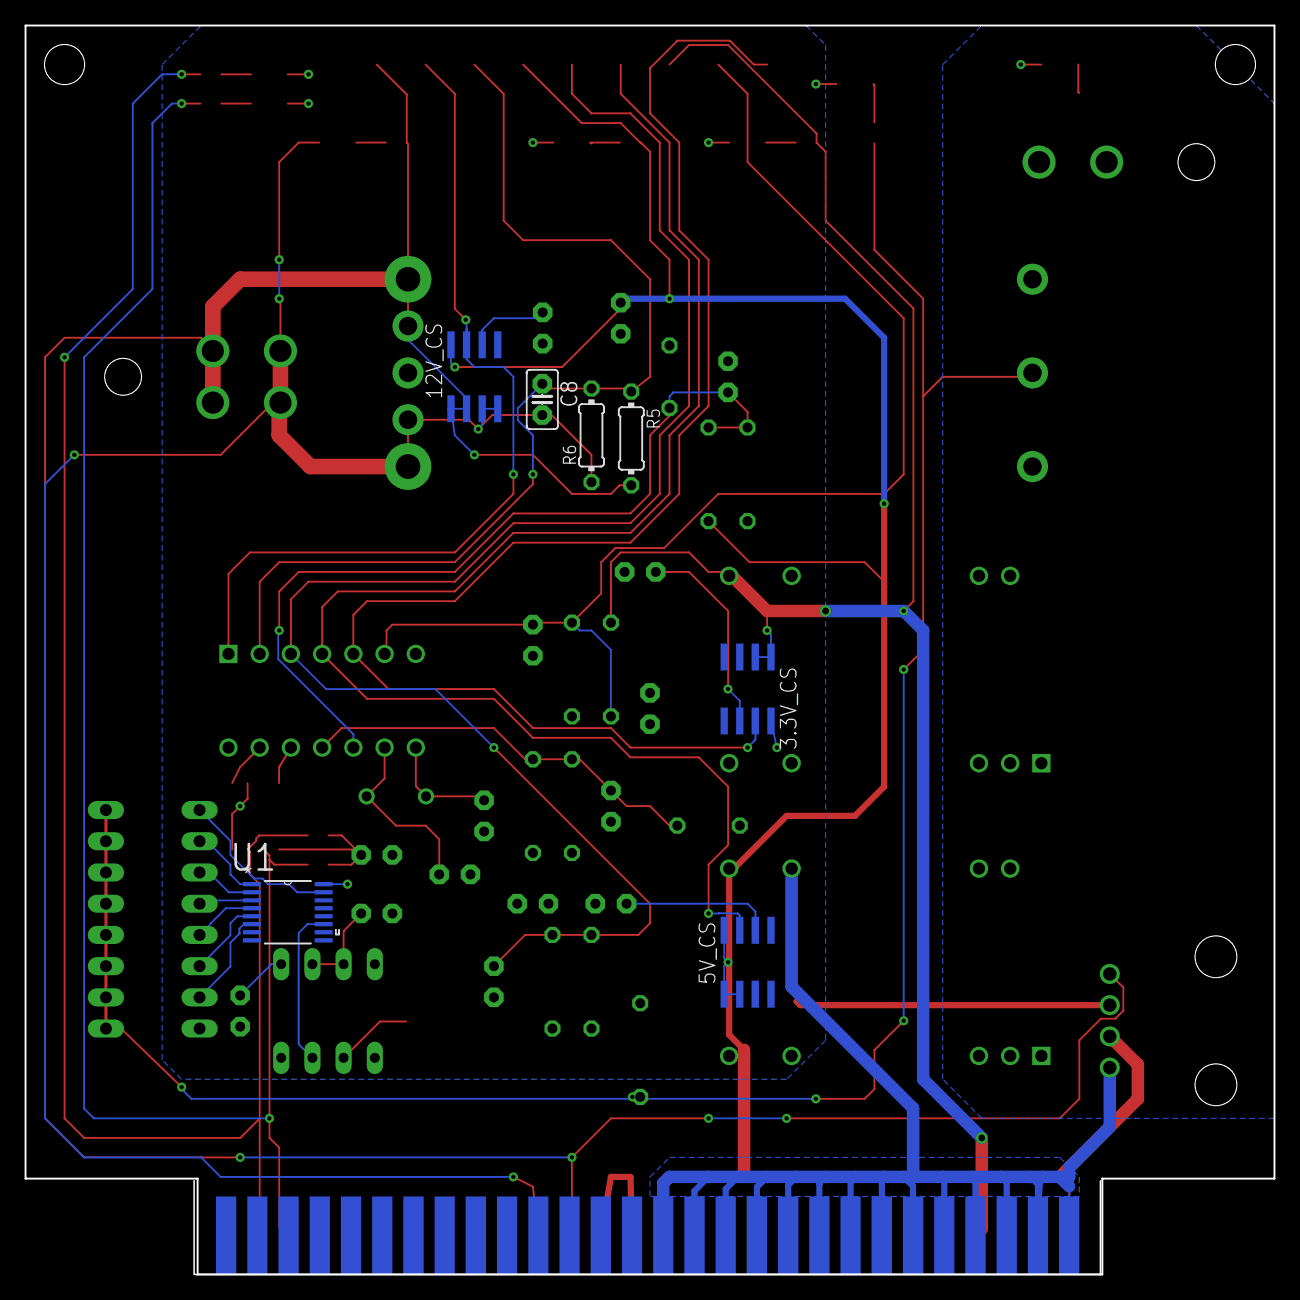
[picture p48: board power_supply.brd from below]

Board: 2 copper layers, 101.6 x 101.6 mm, 71 parts (7 on the bottom side), 44 nets.
