osu-uwrt/hardware_boards/coProcessor/pinconnections.brd

## EAGLE design coProcessor/pinconnections.brd (2017-08-23)

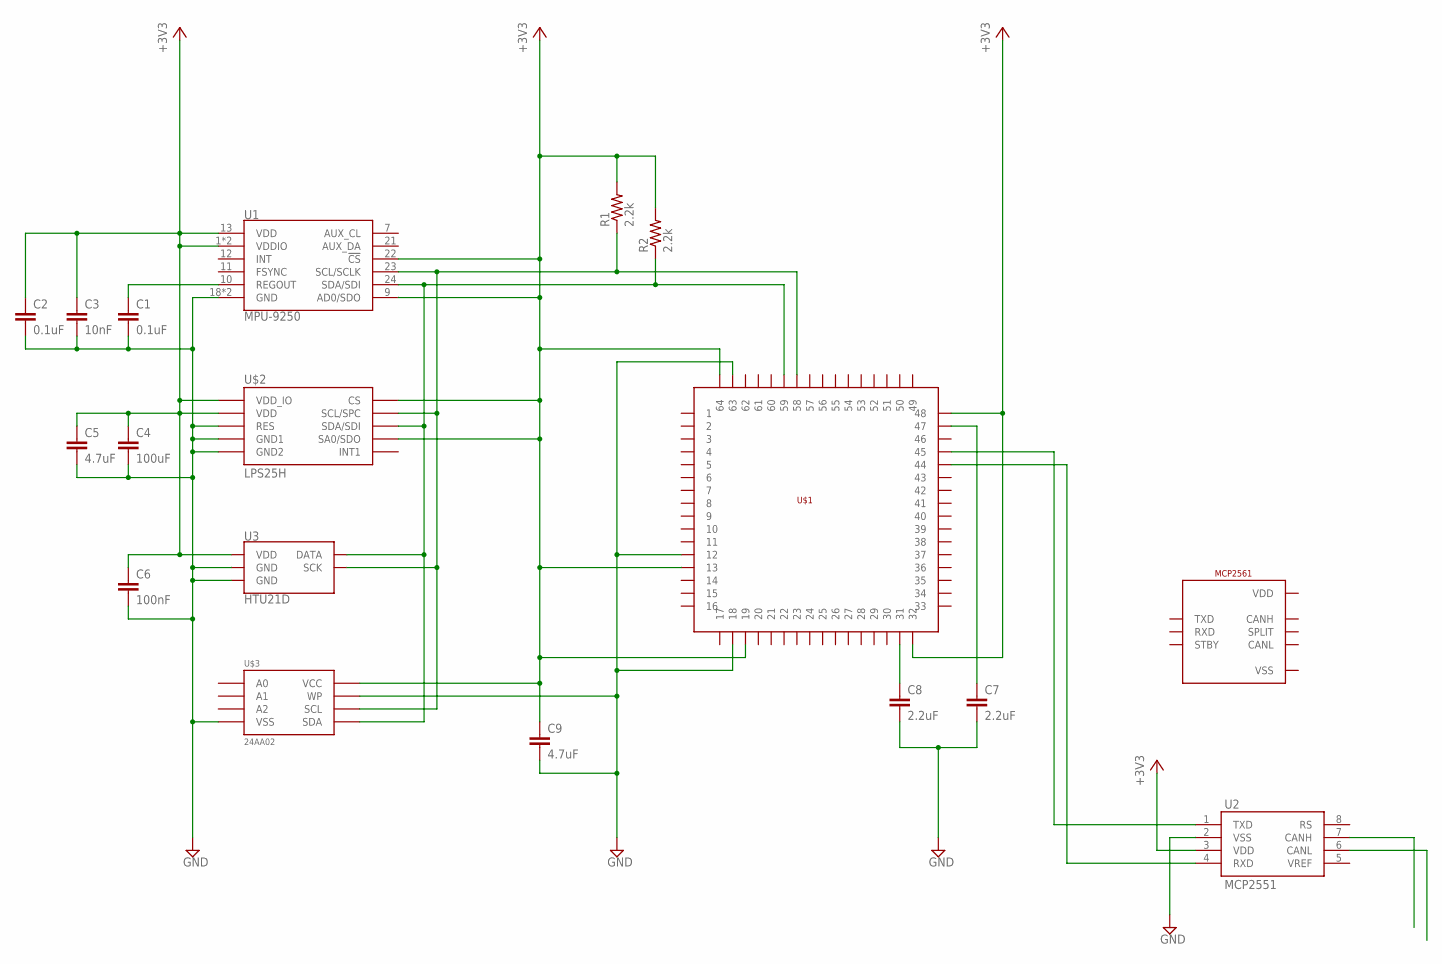
[picture p49: schematic pinconnections.sch]

Parts:
C1, C2: 0.1uF; C025-025X050
C3: 10nF; C025-025X050
C4: 100uF; C025-025X050
C5, C9: 4.7uF; C025-025X050
C6: 100nF; C025-025X050
C7, C8: 2.2uF; C025-025X050
R1, R2: 2.2k; 0204/5
U1: MPU-9250; QFN24-3X3
U2: MCP2551; SO08
U3: HTU21D; DFN-6-3X3-HTU21D
U$1: STM32F405RG
U$2: LPS25H
U$3: 24AA02; SO-08M
U$4: MCP2561; SOIC8

Connections:
+3V3: U$1.32, U$1.48
GND: C1.2, C2.2, C3.2, C4.2, C5.2, C6.2, C7.2, C8.2, C9.2, U2.2 (VSS), U3.7 (GND), U3.GND, U$1.12, U$1.18, U$1.63, U$2.3 (RES), U$2.8 (GND1), U$2.9 (GND2), U$3.4 (VSS), U$3.7 (WP)
unnamed: C8.1, U$1.31
unnamed: C1.1, U1.10 (REGOUT)
unnamed: U2.1 (TXD), U$1.45
unnamed: U1.18 (GND), U1.20 (GND)
unnamed: U2.4 (RXD), U$1.44
unnamed: C7.1, U$1.47
SCL: R1.1, U1.23 (SCL/SCLK), U3.SCK, U$1.58, U$2.2 (SCL/SPC), U$3.6 (SCL)
SDA: R2.1, U1.24 (SDA/SDI), U3.DATA, U$1.59, U$2.4 (SDA/SDI), U$3.5 (SDA)
VDD: C2.1, C3.1, C4.1, C5.1, C6.1, C9.1, R1.2, R2.2, U1.1 (VDDIO), U1.8 (VDDIO), U1.9 (AD0/SDO), U1.13 (VDD), U1.22 (!CS), U2.3 (VDD), U3.VDD, U$1.13, U$1.19, U$1.64, U$2.1 (VDD_IO), U$2.5 (SA0/SDO), U$2.6 (CS), U$2.10 (VDD), U$3.8 (VCC)

Board: 2 copper layers, 18 parts (0 on the bottom side), 11 nets, no tracks yet.
