osu-uwrt/hardware_boards/coProcessor/co_processor.brd

## EAGLE design coProcessor/co_processor.brd (2017-08-23)

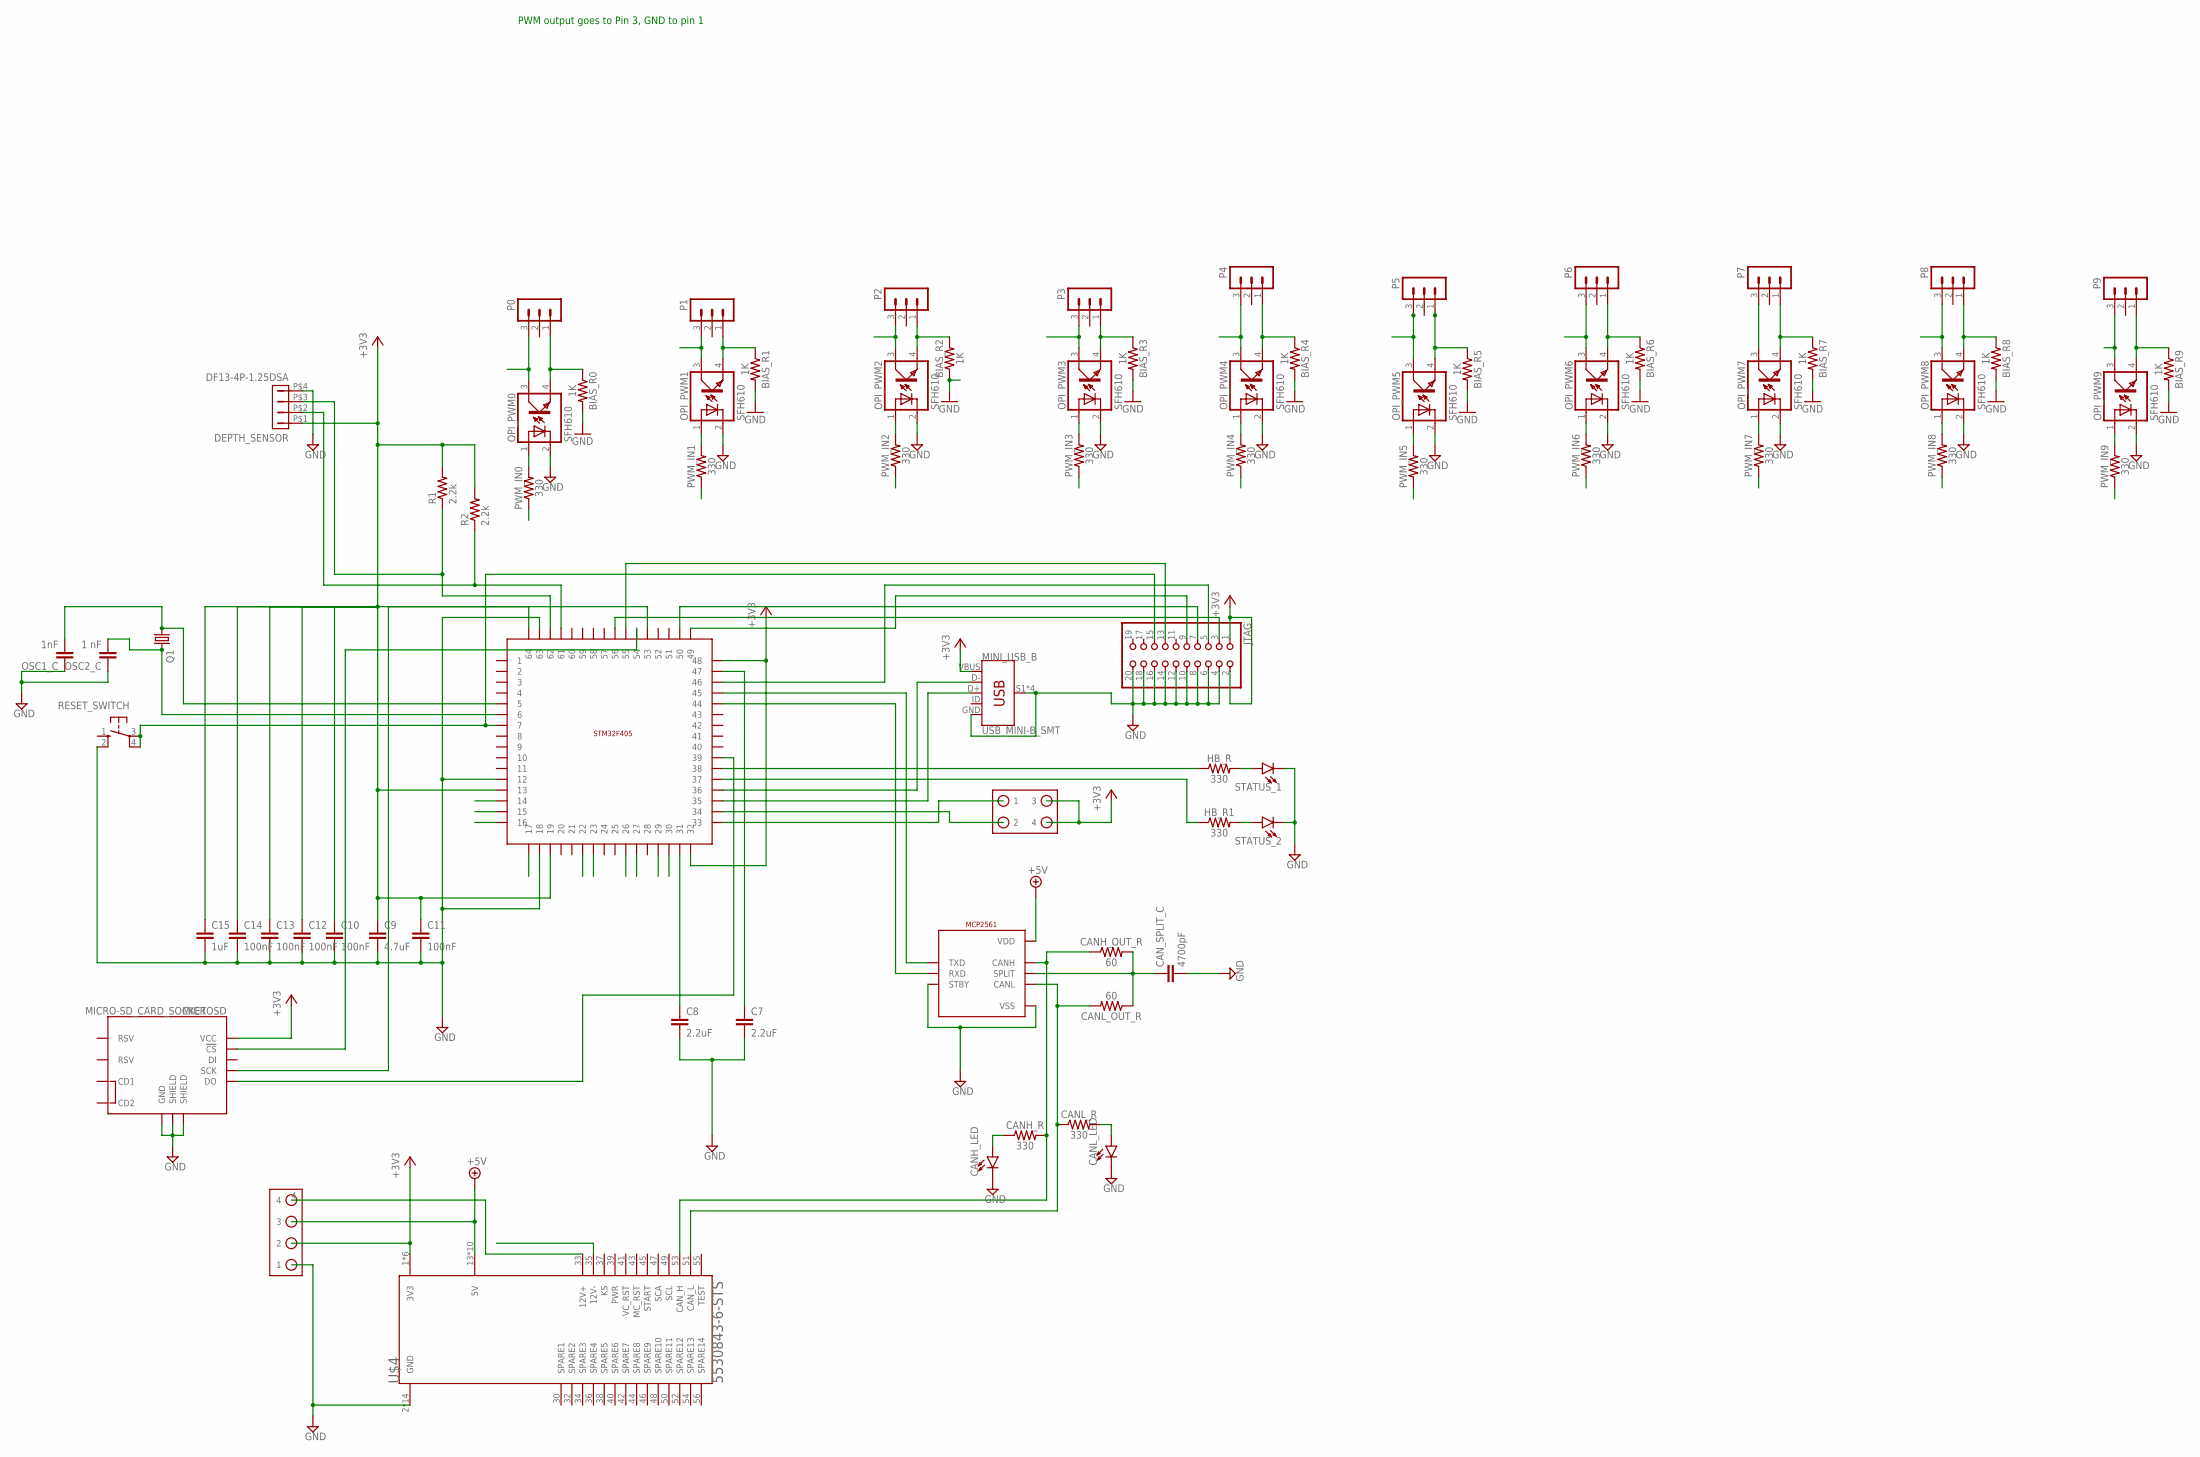
[picture p50: schematic co_processor.sch]

Parts:
BIAS_R0, BIAS_R1, BIAS_R2, BIAS_R3, BIAS_R4, BIAS_R5, BIAS_R6, BIAS_R7, BIAS_R8, BIAS_R9: 1K; 0603
C7, C8: 2.2uF; C025-025X050
C9: 4.7uF; C025-025X050
C10, C11, C12, C13, C14: 100nF; C025-025X050
C15: 1uF; C025-025X050
CANH_LED: LED1206; LED-1206
CANH_OUT_R: 60; 0603
CANH_R: 330; 0603
CANL_LED: LED1206; LED-1206
CANL_OUT_R: 60; 0603
CANL_R: 330; 0603
CAN_SPLIT_C: 4700pF; C2.5-2
DEPTH_SENSOR: DF13-4P-1.25DSA
HB_R, HB_R1: 330; 0603
JTAG: PINHD-2X10; 2X10
MCP2561: MCP2561; SOIC8
MICROSD: MICRO-SD_CARD_SOCKET; MICRO-SD-SOCKET
MINI_USB_B: USB_MINI-B_SMT; USB-MINIB
OPI_PWM0, OPI_PWM1, OPI_PWM2, OPI_PWM3, OPI_PWM4, OPI_PWM5, OPI_PWM6, OPI_PWM7, OPI_PWM8, OPI_PWM9: SFH610; DIL04
OSC1_C: 1nF; C2.5-2
OSC2_C: 1 nF; C2.5-2
P0, P1, P2, P3, P4, P5, P6, P7, P8, P9: MA03-1
PWM_IN0, PWM_IN1, PWM_IN2, PWM_IN3, PWM_IN4, PWM_IN5, PWM_IN6, PWM_IN7, PWM_IN8, PWM_IN9: 330; 0603
Q1: CRYSTALHC49S; HC49/S
R1, R2: 2.2k; 0204/5
RESET_SWITCH: 10-XX; B3F-10XX
STATUS_1, STATUS_2: LED1206; LED-1206
STM32F405: STM32F405RG
SWITCHES: 39-30-1040; 5569-04A2
U$4: 5530843-6-STS; 5530843-6-BOARD
U$7: 70555-0003

Connections:
12V_OUT: OPI_PWM0.3 (COL), OPI_PWM1.3 (COL), OPI_PWM2.3 (COL), OPI_PWM3.3 (COL), OPI_PWM4.3 (COL), OPI_PWM5.3 (COL), OPI_PWM6.3 (COL), OPI_PWM7.3 (COL), OPI_PWM8.3 (COL), OPI_PWM9.3 (COL), P0.3, P1.3, P2.3, P3.3, P4.3, P5.3, P6.3, P7.3, P8.3, P9.3, U$4.33 (12V+), U$7.4
+3V3: C9.1, C10.1, C11.1, C12.1, C13.1, C14.1, C15.1, DEPTH_SENSOR.P$1 (1), JTAG.1, JTAG.2, MICROSD.VCC, MINI_USB_B.VBUS, R1.2, R2.2, STM32F405.13, STM32F405.19, STM32F405.32, STM32F405.48, STM32F405.64, SWITCHES.1 (4), SWITCHES.2 (3), U$4.1 (3V3), U$4.3 (3V3), U$4.5 (3V3), U$4.7 (3V3), U$4.9 (3V3), U$4.11 (3V3), U$7.2
+5V: MCP2561.P$3 (VDD), U$4.13 (5V), U$4.15 (5V), U$4.17 (5V), U$4.19 (5V), U$4.21 (5V), U$4.23 (5V), U$4.25 (5V), U$4.27 (5V), U$4.29 (5V), U$4.31 (5V), U$7.3
CANH_LED: CANH_LED.A, CANH_R.1
CANH_OUT: CANH_OUT_R.1, CANH_R.2, MCP2561.P$7 (CANH), U$4.53 (CAN_H)
CANL_LED: CANL_LED.A, CANL_R.2
CANL_OUT: CANL_OUT_R.2, CANL_R.1, MCP2561.P$6 (CANL), U$4.51 (CAN_L)
CAN_RX: MCP2561.P$4 (RXD), STM32F405.44
CAN_SPLIT: CANH_OUT_R.2, CANL_OUT_R.1, CAN_SPLIT_C.1, MCP2561.P$5 (SPLIT)
CAN_TX: MCP2561.P$1 (TXD), STM32F405.45
EMIT0: BIAS_R0.1, OPI_PWM0.4 (EMIT), P0.1
EMIT1: BIAS_R1.1, OPI_PWM1.4 (EMIT), P1.1
EMIT2: BIAS_R2.2, OPI_PWM2.4 (EMIT), P2.1
EMIT3: BIAS_R3.1, OPI_PWM3.4 (EMIT), P3.1
EMIT4: BIAS_R4.1, OPI_PWM4.4 (EMIT), P4.1
EMIT5: BIAS_R5.1, OPI_PWM5.4 (EMIT), P5.1
EMIT6: BIAS_R6.1, OPI_PWM6.4 (EMIT), P6.1
EMIT7: BIAS_R7.1, OPI_PWM7.4 (EMIT), P7.1
EMIT8: BIAS_R8.1, OPI_PWM8.4 (EMIT), P8.1
EMIT9: BIAS_R9.1, OPI_PWM9.4 (EMIT), P9.1
GND: C7.2, C8.2, C9.2, C10.2, C11.2, C12.2, C13.2, C14.2, C15.2, CANH_LED.C, CANL_LED.C, CAN_SPLIT_C.2, DEPTH_SENSOR.P$4 (4), JTAG.4, JTAG.6, JTAG.8, JTAG.10, JTAG.12, JTAG.14, JTAG.16, JTAG.18, JTAG.20, MCP2561.P$2 (VSS), MCP2561.P$8 (STBY), MICROSD.GND, MICROSD.GND1 (SHIELD), MICROSD.GND3 (SHIELD), MINI_USB_B.GND, MINI_USB_B.S1 (SHIELD), MINI_USB_B.S2 (SHIELD), MINI_USB_B.S3 (SHIELD), MINI_USB_B.S4 (SHIELD), OPI_PWM0.2 (C), OPI_PWM1.2 (C), OPI_PWM2.2 (C), OPI_PWM3.2 (C), OPI_PWM4.2 (C), OPI_PWM5.2 (C), OPI_PWM6.2 (C), OPI_PWM7.2 (C), OPI_PWM8.2 (C), OPI_PWM9.2 (C), OSC1_C.1, OSC2_C.1, RESET_SWITCH.2 (S1), STATUS_1.C, STATUS_2.C, STM32F405.12, STM32F405.18, STM32F405.63, U$4.2 (GND), U$4.4 (GND), U$4.6 (GND), U$4.8 (GND), U$4.10 (GND), U$4.12 (GND), U$4.14 (GND), U$4.16 (GND), U$4.18 (GND), U$4.20 (GND), U$4.22 (GND), U$4.24 (GND), U$4.26 (GND), U$4.28 (GND), U$7.1
GND_ESC: BIAS_R0.2, BIAS_R1.2, BIAS_R2.1, BIAS_R3.2, BIAS_R4.2, BIAS_R5.2, BIAS_R6.2, BIAS_R7.2, BIAS_R8.2, BIAS_R9.2
HB_OUT: HB_R.1, STM32F405.38
HB_OUT1: HB_R1.1, STM32F405.37
I2C_SCL: DEPTH_SENSOR.P$2 (2), R2.1, STM32F405.61
I2C_SDA: DEPTH_SENSOR.P$3 (3), R1.1, STM32F405.62
JTAG_RST: JTAG.3, STM32F405.56
JTAG_TCK: JTAG.9, STM32F405.49
JTAG_TDI: JTAG.5, STM32F405.50
JTAG_TDO: JTAG.13, STM32F405.55
JTAG_TMS: JTAG.7, STM32F405.46
KILL_SW: STM32F405.34, SWITCHES.3 (2)
unnamed: HB_R.2, STATUS_1.A
unnamed: HB_R1.2, STATUS_2.A
unnamed: OPI_PWM1.1 (A), PWM_IN1.2
unnamed: OPI_PWM3.1 (A), PWM_IN3.2
unnamed: OPI_PWM4.1 (A), PWM_IN4.2
unnamed: OPI_PWM5.1 (A), PWM_IN5.2
unnamed: OPI_PWM9.1 (A), PWM_IN9.2
unnamed: OPI_PWM6.1 (A), PWM_IN6.2
unnamed: OPI_PWM7.1 (A), PWM_IN7.2
unnamed: OPI_PWM8.1 (A), PWM_IN8.2
unnamed: OPI_PWM0.1 (A), PWM_IN0.2
unnamed: OPI_PWM2.1 (A), PWM_IN2.2
NRST: JTAG.15, RESET_SWITCH.3, RESET_SWITCH.4 (P1), STM32F405.7
OSC_IN: OSC1_C.2, Q1.1, STM32F405.5
OSC_OUT: OSC2_C.2, Q1.2, STM32F405.6
PWM0_OUT: PWM_IN0.1, STM32F405.30
PWM1_OUT: PWM_IN1.1, STM32F405.29
PWM2_OUT: PWM_IN2.1, STM32F405.27
PWM3_OUT: PWM_IN3.1, STM32F405.26
PWM4_OUT: PWM_IN4.1, STM32F405.23
PWM5_OUT: PWM_IN5.1, STM32F405.22
PWM6_OUT: PWM_IN6.1, STM32F405.17
PWM7_OUT: PWM_IN7.1, STM32F405.16
PWM8_OUT: PWM_IN8.1, STM32F405.15
PWM9_OUT: PWM_IN9.1, STM32F405.14
SDIO_CK: MICROSD.SCLK (SCK), STM32F405.53
SDIO_CMD: MICROSD.CS (!CS), STM32F405.54
SDIO_D0: MICROSD.DO, STM32F405.39
START_SW: STM32F405.33, SWITCHES.4 (1)
USB_DM: MINI_USB_B.D-, STM32F405.36
USB_DP: MINI_USB_B.D+, STM32F405.35
VCAP_1: C8.1, STM32F405.31
VCAP_2: C7.1, STM32F405.47

Notes on the sheet:
PWM output goes to Pin 3, GND to pin 1

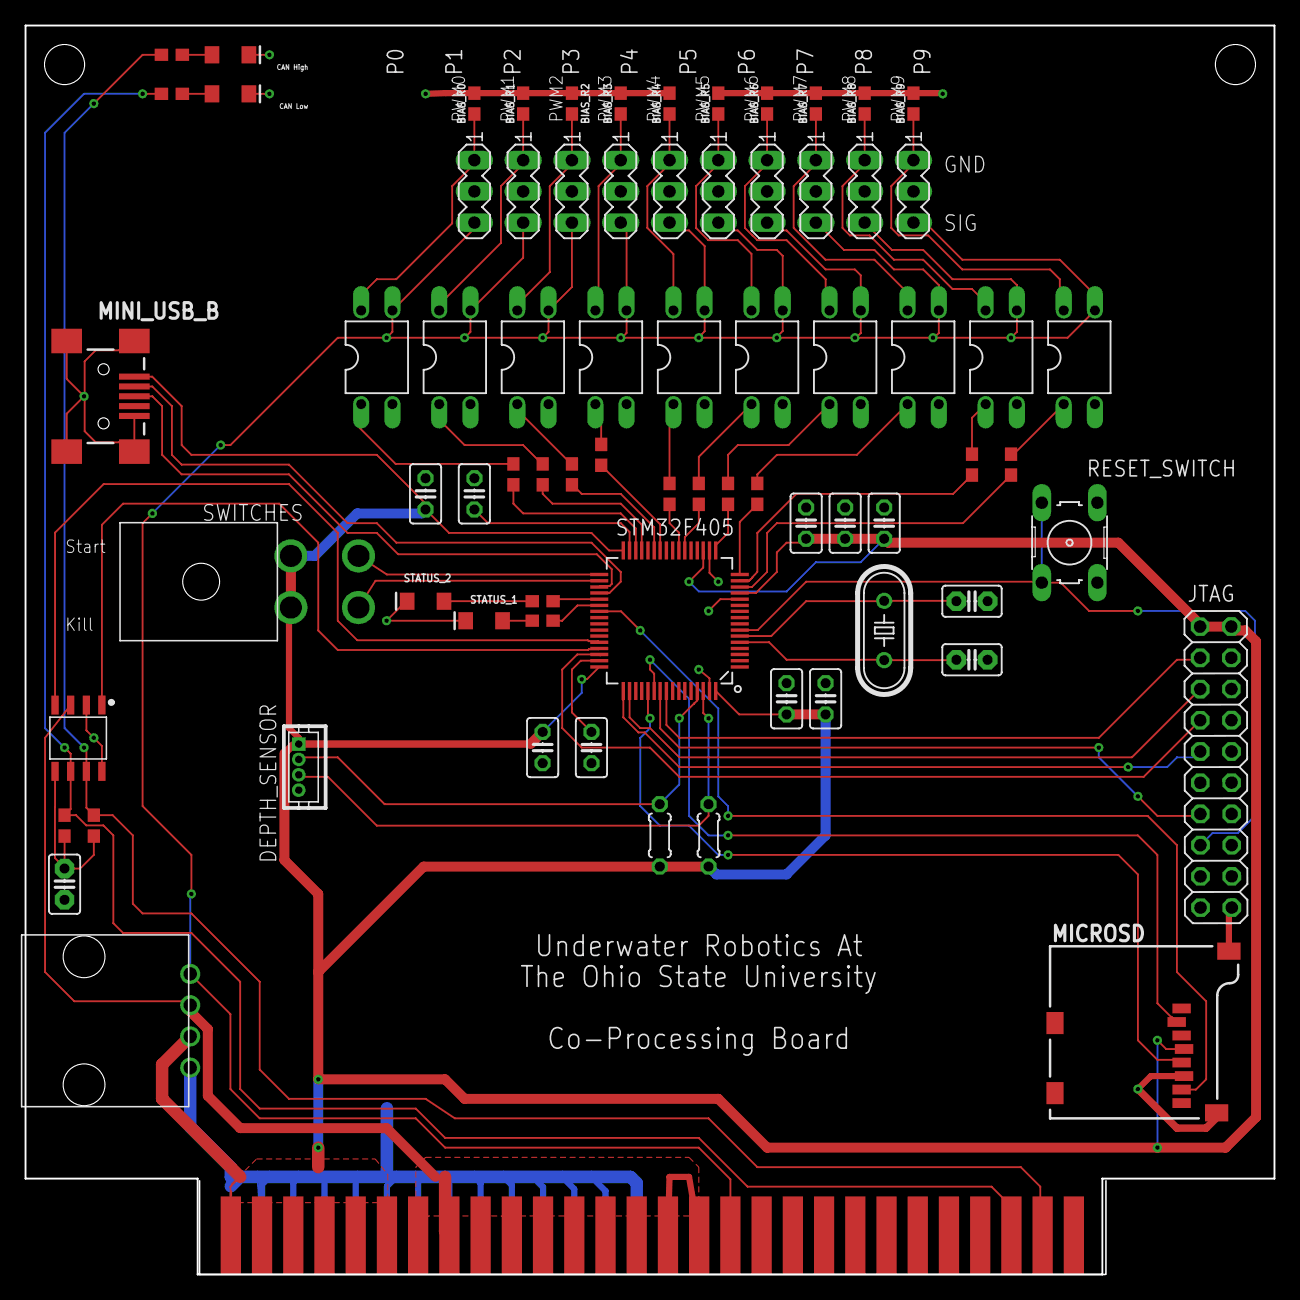
[picture p51: board co_processor.brd from above]

Board: 2 copper layers, 101.6 x 101.6 mm, 75 parts (0 on the bottom side), 65 nets.
