osu-uwrt/hardware_boards/Converter Board/Converter Board.brd

## EAGLE design Converter Board/Converter Board.brd (2017-10-22)

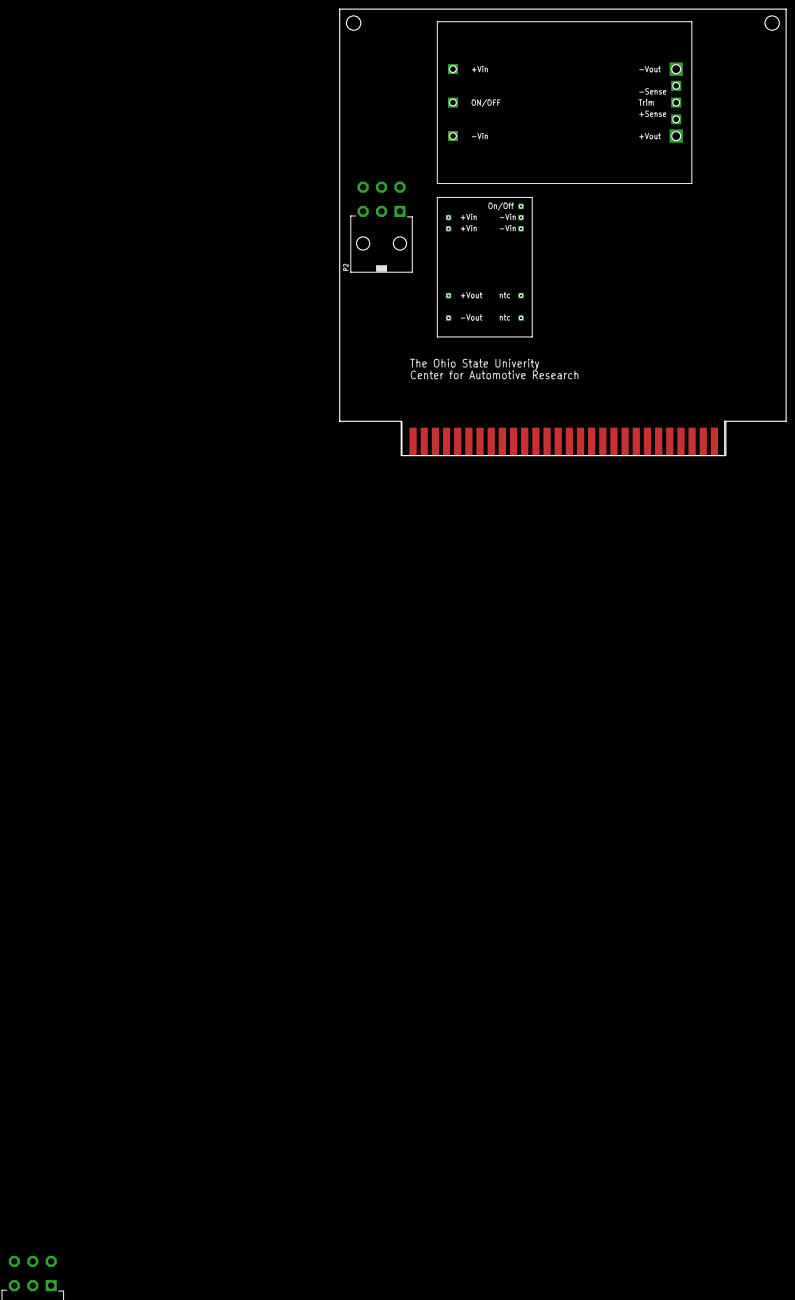
[picture p53: board Converter Board.brd from above]

Board: 2 copper layers, 101.6 x 101.6 mm, 5 parts (0 on the bottom side), 6 nets, no tracks yet.

Parts:
P1, P2: 39-30-06?; 39-30-?06?
U$1: 3.3VCONV
U$2: 12VCONV
U$3: 5530843; 5530843-6-BOARDFINGERS

Connections:
unnamed: P2.4, P2.5, P2.6, U$1.22, U$1.23, U$2.1,+VIN
unnamed: P2.1, P2.2, P2.3, U$1.2, U$1.3, U$2.3,-VIN
unnamed: U$1.14, U$3.3.3VP1, U$3.3.3VP2, U$3.3.3VP3
unnamed: U$1.16, U$3.GND1, U$3.GND2, U$3.GND3
unnamed: P1.1, P1.2, P1.3, U$2.4,-VOUT
unnamed: P1.4, P1.5, P1.6, U$2.8,+VOUT
