osu-uwrt/hardware_boards/(commit log)

2017-08-23 Initial commit of riptide boards
    [co_processor.brd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]
2017-08-28 First commit of the batteryBalancer with the board temp
    [battery_balancer.brd, battery_balancer.sch]
2017-08-28 Rev1 Board
    [batteryBalancer.brd, batteryBalancer.sch, battery_balancer.brd, battery_balancer.sch]
2017-08-30 Adding initial board template to repo
    [boardTemplate.brd, boardTemplate.sch]
2017-08-31 Battery load balencer board rev 1.1 to be printed
2017-08-31 Gerber Files for Battery Balancer
    [batteryBalancer.GBL, batteryBalancer.GBO, batteryBalancer.GBS, batteryBalancer.GTL, batteryBalancer.GTO, batteryBalancer.GTP, batteryBalancer.GTS]
2017-08-31 Edgefinger not connected
    [batteryBalancer.brd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]
2017-09-06 Leaving the old boards (reluctantly) in the repo
    [12v_converter.brd, 12v_converter.sch, 5v_converter.brd, 5v_converter.sch, backplane.brd, backplane.sch, battery_monitor.brd, battery_monitor.sch]
2017-10-02 Edge Connector parts revision 1 (10/1/17)
2017-10-05 Cleaning up september boards for noobs
    [batteryBalancer.brd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]
2017-10-05 Initial commit of the battery balancer board
    [batteryBalancer.brd, batteryBalancer.sch]
2017-10-05 Backplane V1, new edge layout for 2017
    [backplane.brd, backplane.sch]
2017-10-08 Updated backplane with all topside traces, correct planes.
    [backplane.brd, backplane.sch]
2017-10-08 Re-do with dimensions agreeing with mechanical team
    [backplane.brd]
2017-10-08 Added 5 V converter part
2017-10-08 Fixed some parts and named parts
    [batteryBalancer.brd]
2017-10-08 Added the 3.3 Volt converter
2017-10-08 Fancied up the schematic, nets still need to be named
    [batteryBalancer.brd, batteryBalancer.sch]
2017-10-09 Fixed some connection errors
    [batteryBalancer.brd, batteryBalancer.sch]
2017-10-11 Added net names
    [batteryBalancer.brd, batteryBalancer.sch]
2017-10-15 Started board design
    [batteryBalancer.brd]
2017-10-18 Routed the board
    [batteryBalancer.brd, batteryBalancer.sch]
2017-10-18 Fixed a trace
    [batteryBalancer.brd]
2017-10-19 Made traces the right size
    [batteryBalancer.brd]
2017-10-19 Prettied up the routing and added kill switch indicator
    [batteryBalancer.brd, batteryBalancer.sch]
2017-10-19 fixed edge connector, no more dimension layer and power/ground planes fixed
2017-10-19 Lost all my work :( but at least I got the new edge connector
    [batteryBalancer.brd, batteryBalancer.sch]
2017-10-21 Applied changes suggested in design review
    [batteryBalancer.brd, batteryBalancer.sch]
2017-10-21 Added testpoints
    [batteryBalancer.brd, batteryBalancer.sch]
2017-10-21 Revised the 5V and 3.3V Converter files Created the 12V converter Began schematic for converter board Created block diagram
    [Converter Board.brd, Converter Board.sch]
2017-10-22 Revising converter board
    [Converter Board.brd, Converter Board.sch]
2017-10-22 Done, made gerbers, time for lunch
    [batteryBalancer.brd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]
2017-10-22 Fixing backplane hole placement
    [backplane.brd, batteryBalancer.brd]
2017-10-22 Added library for Depth Sensor Connector
2017-10-22 Revised 12 V and 3.3 V Converters Finished the majority of the converter board
    [ConverterBoard.brd, ConverterBoard.sch]
2017-10-22 Cleaning up the mess
    [batteryBalancer.brd, batteryBalancer.sch]
2017-10-22 Got the gerber and also labeled the gnd test point
    [batteryBalancer.brd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]
2017-10-23 Added LEDs and resistors to converter board
    [ConverterBoard.brd, ConverterBoard.sch]
2017-10-24 Jennifer's edits on the converter board
    [Converter Board.sch, ConverterBoard.brd]
2017-10-25 Renamed templates
    [copro.brd, copro.sch]
2017-10-25 added several eagle libraries, all "big" parts are on the copro schematic
    [copro.brd, copro.sch]
2017-10-26 Made some final adjustments to the converter board
2017-10-26 Adjustments to the converter board
    [ConverterBoard.sch]
2017-10-27 Added battery gnd to backplane
    [batteryBalancer.brd, batteryBalancer.sch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]
2017-10-29 Adjustments to board, created gerber files
    [ConverterBoard.brd]
2017-11-05 some progress on the copro eagle schematic, optoisolator needs fixed
    [STM32F405RGT6.stl, STM32F405RGT6.stp, co_processor.sch, copro.brd, copro.sch]
2017-11-05 Opto-isolator finished, usb port finished, jtag finished
    [copro.brd, copro.sch]
2017-11-11 copro board schematic nearly finished. Still need to work out transceiver
    [co_processor.brd, co_processor.sch, copro.brd, copro.sch]
2017-11-11 Slight progress on last commit, just so everything is up to date
    [copro.brd, copro.sch]
2017-11-14 The current official coprocessor board is now saved under the filename "copro - copy". I will change that. More importantly, the board is tentatively finished, atleast enough for others to check it, 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
    [co_processor.brd, copro - Copy.brd, copro - Copy.sch, copro.brd, copro.sch]
2017-11-14 renamed the current official copro board to filename "Coprocessor_Board"
    [Coprocessor_Board.brd, Coprocessor_Board.sch, coproDeadEnd.brd, coproDeadEnd.sch]
2017-11-15 completely rerouted, about 3/4 routed. many resistors switched to through-hole. opto-isolators moved for more space. gnd planes reworked.
2017-11-16 Fixed 3.3V converter Added extra connector Updated board with new parts
    [ConverterBoard.brd, ConverterBoard.sch]
2017-11-19 coprocessor board tentatively finished draft2, many things fixed, CAN kicked the can, and parts list added
    [Coprocessor_Board.brd, Coprocessor_Board.sch, co_processor.sch, parts list.xlsx]
2017-11-19 Created a copy of rev, created a humidity sensor library
    [ConverterBoardRev2.brd, ConverterBoardRev2.sch]
2017-11-19 Started Rev2
    [batteryBalancer.brd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]
2017-11-28 General clean (salute) up of copro
    [Coprocessor_Board.brd, Coprocessor_Board.sch, coproDeadEnd.brd, coproDeadEnd.sch]
2017-11-28 Fixing USB lines, we RF now boyz
    [Coprocessor_Board.brd, Coprocessor_Board.sch]
2017-11-28 Trace clean up
    [Coprocessor_Board.brd, Coprocessor_Board.sch]
2017-11-28 Future proofing
    [Coprocessor_Board.brd, Coprocessor_Board.sch]
2017-11-30 Adding gerbers
    [Coprocessor_Board.brd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]
2017-11-30 Revised humidity sensor Started current sensor
2017-12-07 Finished current sensor and started temperature libraries
2017-12-10 Revision 2 of the battery balancer
2017-12-17 Last commit of the old copro
    [co_processor.brd]
2017-12-17 Cleanup of coprocessor folder
    [Coprocessor_Board.brd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]
2017-12-17 Last commit of Battery balancer Rev 1
    [batteryBalancer.brd, batteryBalancer.sch]
2017-12-17 Removal of the old folder
    [12v_converter.brd, 12v_converter.sch, 5v_converter.brd, 5v_converter.sch, backplane.brd, backplane.sch, battery_monitor.brd, battery_monitor.sch]
2017-12-17 Touched up the battery balancer
    [batteryBalancer.brd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]
2017-12-17 Fixed optoisolator values
    [batteryBalancer.brd, batteryBalancer.sch]
2017-12-18 Preliminary schematic finished, missing 5 V converter. Basic board layout complete, exception of Qs.
    [ConverterBoard.brd, ConverterBoard.sch]
2017-12-18 Added 12V-5V Con. Q needs attention. Layout changed to 1x6 rect.
    [ConverterBoard.brd, ConverterBoard.sch]
2018-01-09 Finished up sensor libraries, started cleaning up board schematic to begin adding new sensors
2018-01-11 Additions to Rev2, added sensors to schematic
    [ConverterBoardRev2.brd, ConverterBoardRev2.sch]
2018-01-11 Updated board and added block diagram
    [batteryBalancer.brd]
2018-01-17 Pneumatics update - something incorrect with EAGLE GND planes
    [ConverterBoard.brd, ConverterBoard.sch]
2018-01-20 Added Blaine's acoustics .sch - pneu almost done except for orphan adjustment
    [ConverterBoard.brd, ConverterBoard.sch, acoustics.sch]
2018-01-21 Most recent version of converter board
2018-01-21 Rev 2 of Coprocessor Board (No IMU) 1.fixed wires that were flipped. JTAG 5 fixed to pin 50. JTAG 7 fixed to pin 46 2.LEDs for power 3.CAN 4.LEDs for CAN 5.Swapped Through-Hole Resistors with more sp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
    [Coprocessor_Board_Rev2.brd, Coprocessor_Board_Rev2.sch]
2018-01-21 Finished Pneumatics Board, if RS232 still exists in a day
    [ConverterBoard.brd, ConverterBoard.sch]
2018-01-24 Pneumatics Board complete. Gerber files uploaded.
    [pneumaticsBoard.brd, pneumaticsBoard.sch]
2018-01-25 Moved C10, changed GND place on logic side.
    [pneumaticsBoard.brd]
2018-01-25 Added 0 Ohm Resistors on TX and RX lines just in case.
    [pneumaticsBoard.brd, pneumaticsBoard.sch]
2018-01-26 Crystal Circuit wasn't grounded
    [pneumaticsBoard.brd, pneumaticsBoard.sch]
2018-01-28 replaced 5v can tran with correct 3.3v
    [Coprocessor_Board_Rev2.brd, Coprocessor_Board_Rev2.sch]
2018-01-28 Computer might blow up
    Schematic done
    [ConverterBoardRev2 (3).brd, ConverterBoardRev2 (3).sch]
2018-01-28 Added the other adcs on the acoustics board
2018-02-02 2 pin connector for can. please check... USB moved No usb id line Different switch connector, custom-made 12 pin package Esc names horizontal LEDs for programming Pushbutton for programming 4 leds , 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
    [Coprocessor_Board_Rev2 - Copy.brd, Coprocessor_Board_Rev2 - Copy.sch, Coprocessor_Board_Rev2.brd, Coprocessor_Board_Rev2.sch]
2018-02-03 added gpio pin connector, erc, fixed some air wires
    [Coprocessor_Board_Rev2 - Copy.brd, Coprocessor_Board_Rev2 - Copy.sch, Coprocessor_Board_Rev2.brd, Coprocessor_Board_Rev2.sch]
2018-02-03 fixed ground, added labels for gpio pins
2018-02-04 Finished it up and made the gerber files
    [batteryBalancer.brd, batteryBalancer.sch]
2018-02-04 Added acoustics reference generator
    [acoustics.brd, acoustics.sch]
2018-02-04 Added Board v0.2
    Other files like basic parts list and Micro-controller files.
    [SparkFun_Pro_Micro_v13a.brd, SparkFun_Pro_Micro_v13a.sch, Status Board 0.1 7 seg matrix templet.sch, Status Board 0.2.brd, Status Board 0.2.sch]
2018-02-05 fixed led orientation, added switch to switch connector
    [Coprocessor_Board_Rev2.brd, parts list.xlsx]
2018-02-07 PN - changed VD to Reg, added pressure sensor, added silkscreen to proper layer
    [pneumaticsBoard.brd, pneumaticsBoard.sch]
2018-02-08 Changed regulator position, fixed traces
    [pneumaticsBoard.brd, pneumaticsBoard.sch]
2018-02-09 Added 8 pin connector
    [batteryBalancer.brd, batteryBalancer.sch]
2018-02-09 Widened minifit holes
    [batteryBalancer.brd, batteryBalancer.sch]
2018-02-09 Adding the converter board gerbers
    [ConverterBoardRev2 (3).GBL, ConverterBoardRev2 (3).GBO, ConverterBoardRev2 (3).GBS, ConverterBoardRev2 (3).GTL, ConverterBoardRev2 (3).GTO, ConverterBoardRev2 (3).GTP, ConverterBoardRev2 (3).GTS]
2018-02-09 Adding copro gerbers revision 2
    [Coprocessor_Board_Rev2.GBL, Coprocessor_Board_Rev2.GBO, Coprocessor_Board_Rev2.GBS, Coprocessor_Board_Rev2.GTL, Coprocessor_Board_Rev2.GTO, Coprocessor_Board_Rev2.GTP, Coprocessor_Board_Rev2.GTS]
2018-02-09 General cleanup (salutes) of the converter and copro eagle files
    [ConverterBoardRev2 (3).brd, ConverterBoardRev2 (3).sch, ConverterBoardRev2.brd, ConverterBoardRev2.sch, Coprocessor_Board_Rev2.brd, Coprocessor_Board_Rev2.sch]
2018-02-09 Added water mark and fixed the .6 mm blunder
    [batteryBalancer.brd]
2018-02-09 Adding the gerbers, last working commit of batBalance Revision 2
    [batteryBalancer.GBL, batteryBalancer.GBO, batteryBalancer.GBS, batteryBalancer.GTL, batteryBalancer.GTO, batteryBalancer.GTP, batteryBalancer.GTS]
2018-02-11 Rev 0.3
    [Status Board 0.3.brd, Status Board 0.3.sch]
2018-02-11 Added THS VSSOP-8 package, added reference data sheets
    [acoustics.sch]
2018-02-18 Ver. 0.4
    Buzzer, address pins, GP LEDs, labels
    [Status Board 0.4.brd, Status Board 0.4.sch]
2018-02-19 Rev 1 done
    Gerber Zip created
    [Status Board 0.4.brd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]
2018-02-25 Cleaned up file structure and commit gerbers
    [Status Board 0.1 7 seg matrix templet.sch, Status Board 0.2.brd, Status Board 0.2.sch, Status Board 0.3.brd, Status Board 0.3.sch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]
2018-02-27 Added basic opa - package NEEDS changed. no values4passive components
    [acoustics.brd]
2018-03-02 Will this commit?
    [acoustics.brd]
2018-03-04 Acoustics Schematic Finished
    [acoustics.sch]
2018-03-04 Added passive components around differencial amplifier. Yikes.
    [acoustics.brd, acoustics.sch]
2018-03-04 Coprocessor 3.0 Schematic
    [CoprocessorBoard3.0.brd, CoprocessorBoard3.0.sch, Coprocessor_Board_Rev2.sch]
2018-03-04 Updated lables position and content
    [Status Board 1.0.brd, Status Board 1.0.sch]
2018-03-07 Mega cleanup and initial placement of rev3 parts
    [CoprocessorBoard3.0.brd, CoprocessorBoard3.0.sch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]
2018-03-08 Final-ish placement of parts
    [CoprocessorBoard3.0.sch]
2018-03-08 (Hulk) Smash
    [CoprocessorBoard3.0.brd, CoprocessorBoard3.0.sch]
2018-03-08 Adding labels to everything
    [CoprocessorBoard3.0.brd, CoprocessorBoard3.0.sch]
2018-03-09 Fixed THS 4551 library and Acoustics Schematic
    [acoustics.brd]
2018-03-09 Added Final Bulk Decoupling cap, updated lables, Gerber files are not updated to reflect new cap yet.
    [Status_Board.brd, Status_Board.sch]
2018-03-09 Added low pass filter, ran DRC fixed weird issue
    [CoprocessorBoard3.0.brd, CoprocessorBoard3.0.sch]
2018-03-18 Create BatteryMonitor
2018-03-18 Created Documentarion for Rev 1.0 Needs Picture of assembled board, and code documentation
2018-03-20 Merging to fix with the stuff
    [CoprocessorBoard3.0.brd, CoprocessorBoard3.0.sch, Status_Board.brd]
2018-03-20 Orginazed directory, generated documentation in Markdown
    [SparkFun_Pro_Micro_v13a.brd, SparkFun_Pro_Micro_v13a.sch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]
2018-04-01 Cleaned and updated converter board, added spots for capacitors
    [ConverterBoard.brd, ConverterBoard.sch, ConverterBoardRev2 (3).brd, ConverterBoardRev2 (3).sch, ConverterBoardRev2.brd, ConverterBoardRev2.sch]
2018-04-01 Removed battery monitor files
    [Battery_Monitor_5.brd, Battery_Monitor_5.sch]
2018-04-01 Add battery monitor eagle schematic and board
    [Battery_Monitor.brd, Battery_Monitor.sch]
2018-04-05 One channel done-ish for 4/5 meeting with Dave
    [acoustics.brd, acoustics.sch]
2018-04-06 One channel done updated Dave's suggestions
    [acoustics.sch]
2018-04-09 Combining AGND and GND into one
    [acoustics.brd, acoustics.sch]
2018-04-09 Debug Board. Should be done.
    [debugBoard.brd, debugBoard.sch]
2018-04-09 Battery monitor board is updated with spi headers
    [Battery_Monitor.brd, Battery_Monitor.sch]
2018-04-10 Initial placement of parts completed
    [acoustics.brd, acoustics.sch]
2018-04-10 Clean up for Jennifer
    [ConverterBoardRev2 (3).brd, ConverterBoardRev2 (3).sch]
2018-04-11 Fixing connector placement of signal connectors
    [acoustics.brd, acoustics.sch]
2018-04-11 Fixing channel 4 to match the others
    [acoustics.brd]
2018-04-11 Fixing planes and matching bounding box
    [acoustics.brd]
2018-04-11 open invitation for august to mess with this layout before he yells at me
    [debugBoard.brd]
2018-04-11 Adding power connection to acoustics
    [acoustics.brd, acoustics.sch]
2018-04-12 Fixing the power connector to add spot for nub
    [acoustics.brd, acoustics.sch]
2018-04-12 Added correct capacitors, rearranged parts
    [ConverterBoard.brd, ConverterBoard.sch]
2018-04-13 Finished Rev 3 of converter board
    [ConverterBoard.brd, ConverterBoard.sch]
2018-04-15 Finished rev3 of board, made gerber files
    [ConverterBoard.brd, ConverterBoard.sch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]
2018-04-25 Adding connectors and labels
    [acoustics.brd, acoustics.sch]
2018-04-29 Revamped Converter Board
    [ConverterBoard.brd, ConverterBoard.sch]
2018-05-15 Commit for cleanup
    [acoustics.brd, acoustics.sch]
2018-05-15 Fixing acoustics branch up to date now
    [acoustics.brd, acoustics.sch]
2018-05-18 Fixing schematic of new ADC package
    [acoustics.brd, acoustics.sch]
2018-05-18 Proper ADC library for our package
2018-05-21 Finished routing ADC
    [acoustics.brd]
2018-09-10 Gitignore and starting acoustics rev 2
    [acoustics.brd, acoustics.sch]
2018-09-23 Labelled Acoustics input connectors.
    [acoustics.brd, acoustics.sch]
2018-09-23 Changing Labels and fixing Layout of Acoustic board (#102)
    [acoustics.brd]
2018-09-27 Added more connections (#103)
    [acoustics.brd]
2018-09-28 Finished PA channel (#104)
    [acoustics.brd, acoustics.sch]
